shahzaibWaseem27/HSHL_ELE_Shahzaib_Waseem_Project_Work/Floorplanning/floorPlanning_bottomView.png

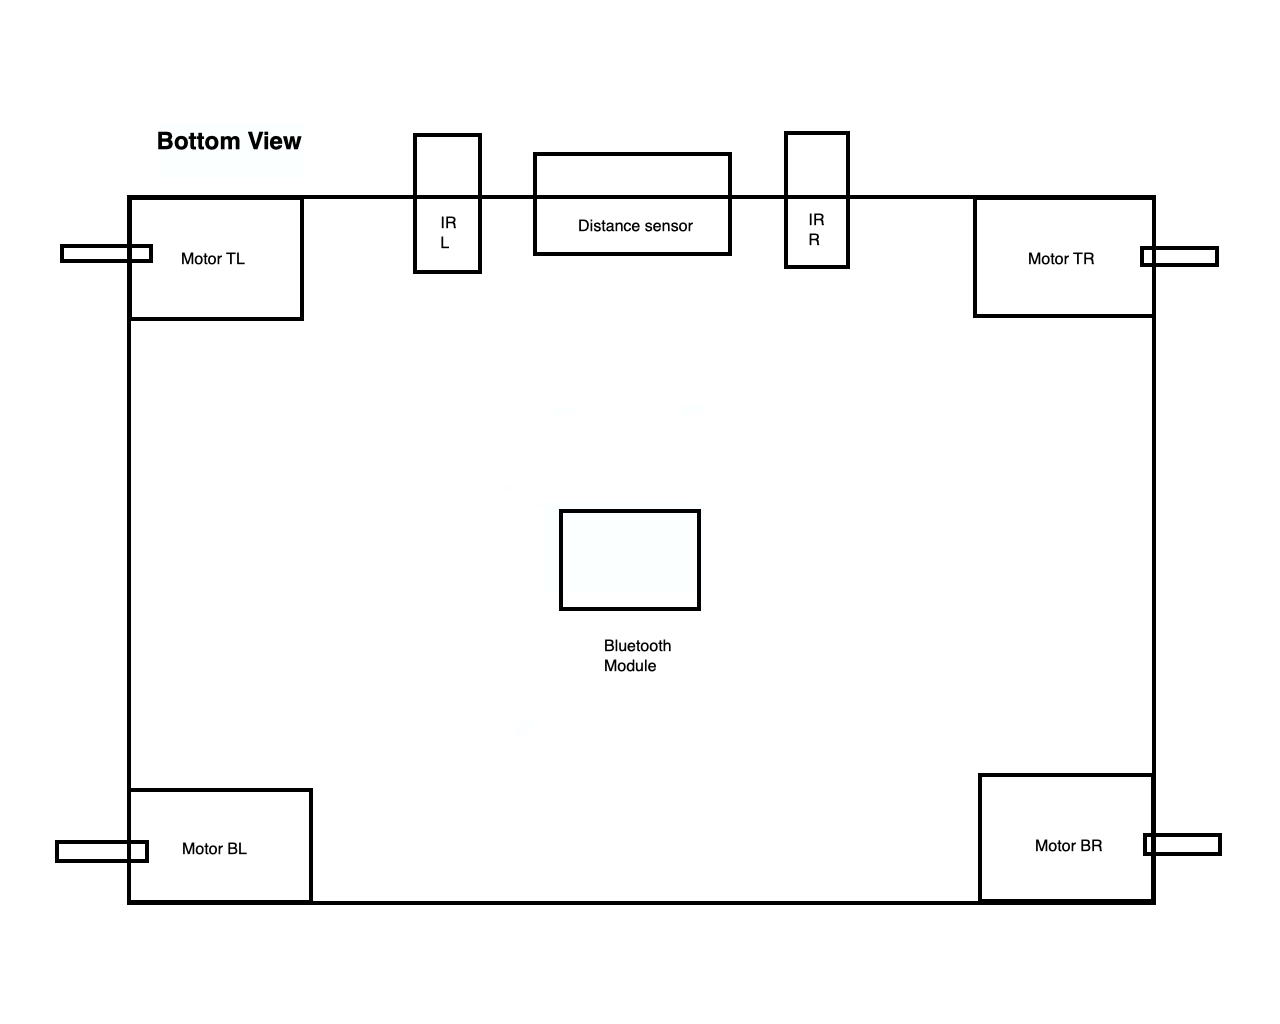
Floorplanning/floorPlanning_bottomView.png
