shahzaibWaseem27/HSHL_ELE_Shahzaib_Waseem_Project_Work/Floorplanning/floorPlanning_topView.png

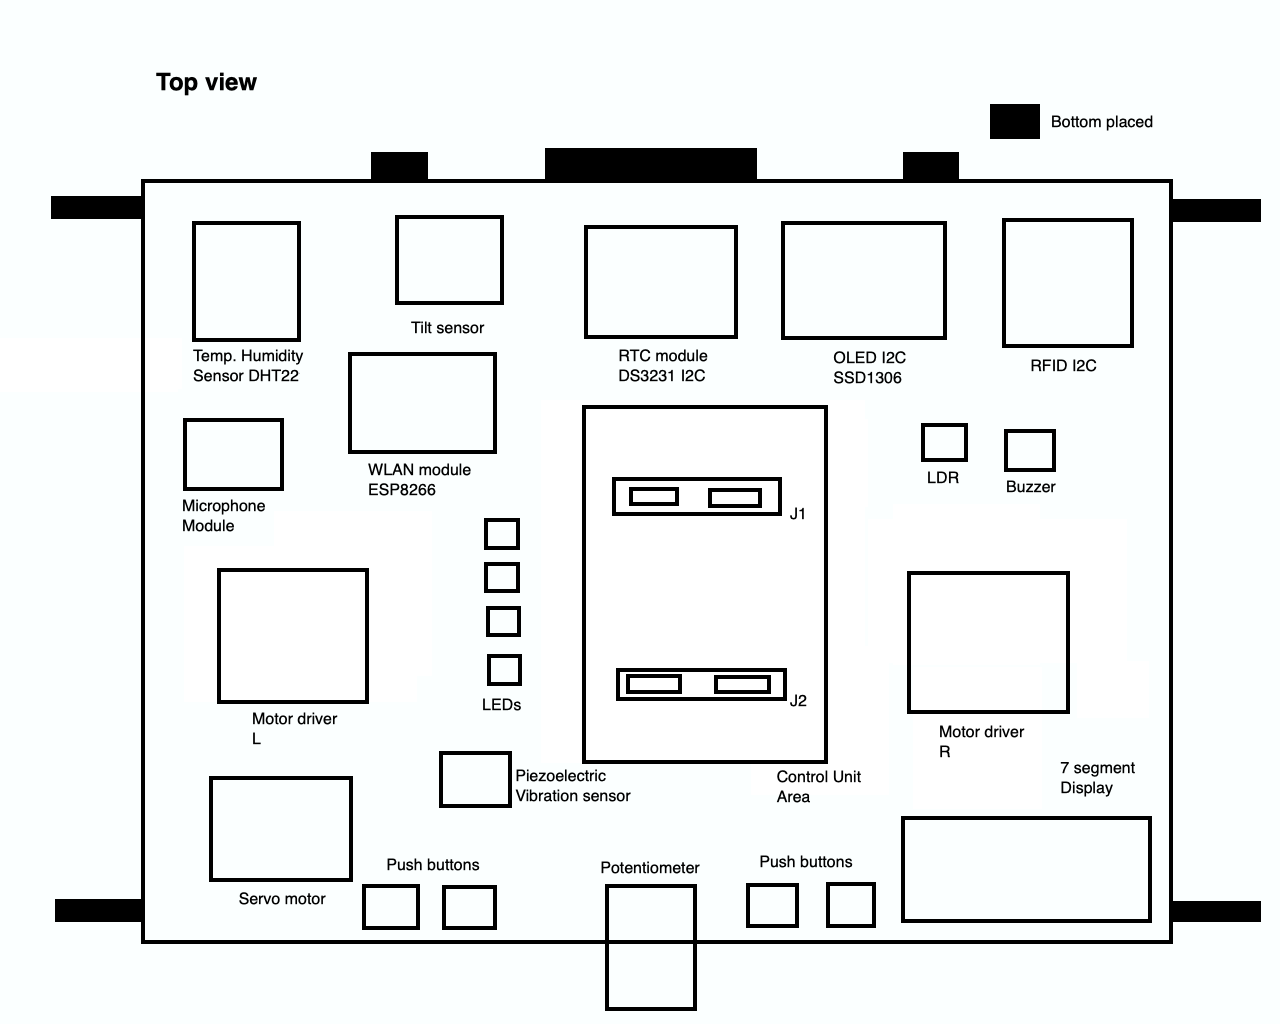
Floorplanning/floorPlanning_topView.png
