shahzaibWaseem27/HSHL_ELE_Shahzaib_Waseem_Project_Work/High density connectors pin mapping.xlsx

Sheet: Export Summary
This document was exported from Numbers. Each table was converted to an Excel worksheet. All other objects on each Numbers sheet were placed on separate worksheets. Please be aware that formula calculations may differ in Excel.
Numbers Sheet Name | Numbers Table Name | Excel Worksheet Name
x_connectors
 | X connectors | x_connectors - X connectors
y_connectors
 | Y connectors | y_connectors - Y connectors

Sheet: x_connectors - X connectors
X connectors
 | Connector code | Peripheral name | Arduino Portenta H7 pin
 | X1 | Keypad R1
 | X2 | Keypad R2
 | X3 | Keypad R3
 | X4 | Keypad R4
 | X5 | Keypad C1
 | X6 | Keypad C2
 | X7 | Keypad C3
 | X8 | Keypad C4
 | X9 | SPI SCK
 | X10 | SPI MISO
 | X11 | SPI MOSI
 | X12 | HC05 BLE RXD
 | X13 | HC05 BLE TXD
 | X14 | ESP8266 WLAN RXD
 | X15 | ESP8266 WLAN TXD
 | X16 | GPIO 1
 | X17 | GPIO 2
 | X18 | GPIO 3
 | X19 | GPIO 4
 | X20
 | X21 | VIN
 | X22 | GND
 | X23
 | X24 | LED 1
 | X25 | LED 2
 | X26 | LED 3
 | X27 | GPIO 5
 | X28 | GPIO 6
 | X29 | GPIO 7
 | X30 | GPIO 8
 | X31 | GND
 | X32 | VIN
 | X33 | LED 4
 | X34 | LED 5
 | X35 | LED 6
 | X36 | LED 7
 | X37 | LED 8
 | X38 | LED 9
 | X39 | LED 10
 | X40 | LED 11
 | X41 | VIN
 | X42 | GND
 | X43
 | X44 | I2C SDA | D11
 | X45
 | X46 | I2C SCL | D12
 | X47 | GND
 | X48 | VIN
 | X49 | LED 12
 | X50 | LED 13
 | X51 | LED 14
 | X52 | LED 15
 | X53 | VSYS
 | X54 | GND
 | X55
 | X56 | Switch 1
 | X57 | Switch 2
 | X58 | Switch 3
 | X59 | Switch 4
 | X60 | Switch 5
 | X61 | Switch 6
 | X62 | Switch 7
 | X63 | Switch 8
 | X64 | VSYS
 | X65 | Switch 9
 | X66 | Switch 10
 | X67 | Switch 11
 | X68 | Switch 12
 | X69 | Switch 13
 | X70 | Switch 14
 | X71 | Switch 15
 | X72 | Switch 16
 | X73 | RESET
 | X74
 | X75 | Push button 1
 | X76 | Push button 2
 | X77 | Push button 3
 | X78 | Push button 4
 | X79
 | X80

Sheet: y_connectors - Y connectors
Y connectors
 | Connector code | Peripheral name | Arduino Portenta H7 pin
 | Y1 | Color sensor S0
 | Y2 | Moisture sensor signal
 | Y3 | Color sensor S1
 | Y4 | Color sensor S2
 | Y5 | GPIO 9
 | Y6 | GPIO 10
 | Y7 | GPIO 11
 | Y8 | GPIO 12
 | Y9 | GPIO 13
 | Y10 | GPIO 14
 | Y11 | GPIO 15
 | Y12 | GPIO 16
 | Y13 | Buzzer
 | Y14 | Color sensor S3
 | Y15 | Seven segment display (segment a)
 | Y16 | Seven segment display (segment b)
 | Y17 | Seven segment display (segment c)
 | Y18 | Seven segment display (segment d)
 | Y19 | Seven segment display (segment e)
 | Y20 | Seven segment display (segment f)
 | Y21 | Seven segment display (segment g)
 | Y22 | Color sensor Out
 | Y23 | VCC / +3V3
 | Y24 | GND
 | Y25 | Seven segment display (anode 1)
 | Y26 | Seven segment display (anode 2)
 | Y27 | Seven segment display (anode 3)
 | Y28 | Seven segment display (anode 4)
 | Y29 | Seven segment display (anode 5)
 | Y30 | Seven segment display (anode 6)
 | Y31 | Seven segment display (anode 7)
 | Y32 | Seven segment display (anode 8)
 | Y33 | GND
 | Y34 | VCC
 | Y35
 | Y36 | Motor driver IN2 | D7
 | Y37
 | Y38 | Left IR sensor pin | D9
 | Y39
 | Y40 | Right IR sensor pin | D10
 | Y41
 | Y42 | Motor driver IN4 | D8
 | Y43 | VCC / +3V3
 | Y44 | GND
 | Y45
 | Y46 | PIR motion sensor
 | Y47
 | Y48 | LoRa G0
 | Y49 | LoRa CS
 | Y50 | LoRa RST
 | Y51 | RFID CS
 | Y52 | RFID RST
 | Y53
 | Y54 | DHT22 temperature sensor pin
 | Y55
 | Y56
 | Y57 | GND
 | Y58
 | Y59 | Distance sensor trigger | D6
 | Y60 | Motor driver IN1 | D1
 | Y61 | Left servo signal | D5
 | Y62 | Motor driver EnA | D0
 | Y63 | Motor driver IN3 | D4
 | Y64
 | Y65 | Motor driver EnB | D3
 | Y66
 | Y67 | Right servo signal | D2
 | Y68
 | Y69 | VCC / +3V3
 | Y70 | GND
 | Y71 | ADC VREF +
 | Y72 | ADC VREF -
 | Y73 | LDR | A0
 | Y74 | Piezo vibration sensor | A4
 | Y75 | Potentiometer 2 | A1
 | Y76 | Distance sensor echo | D20
 | Y77 | LED 16 | A2
 | Y78 | Push button 5 | D21
 | Y79 | Microphone analog pin | A3
 | Y80
