shahzaibWaseem27/HSHL_ELE_Shahzaib_Waseem_Project_Work/Arduino Portenta/ABX00042-full-pinout.pdf

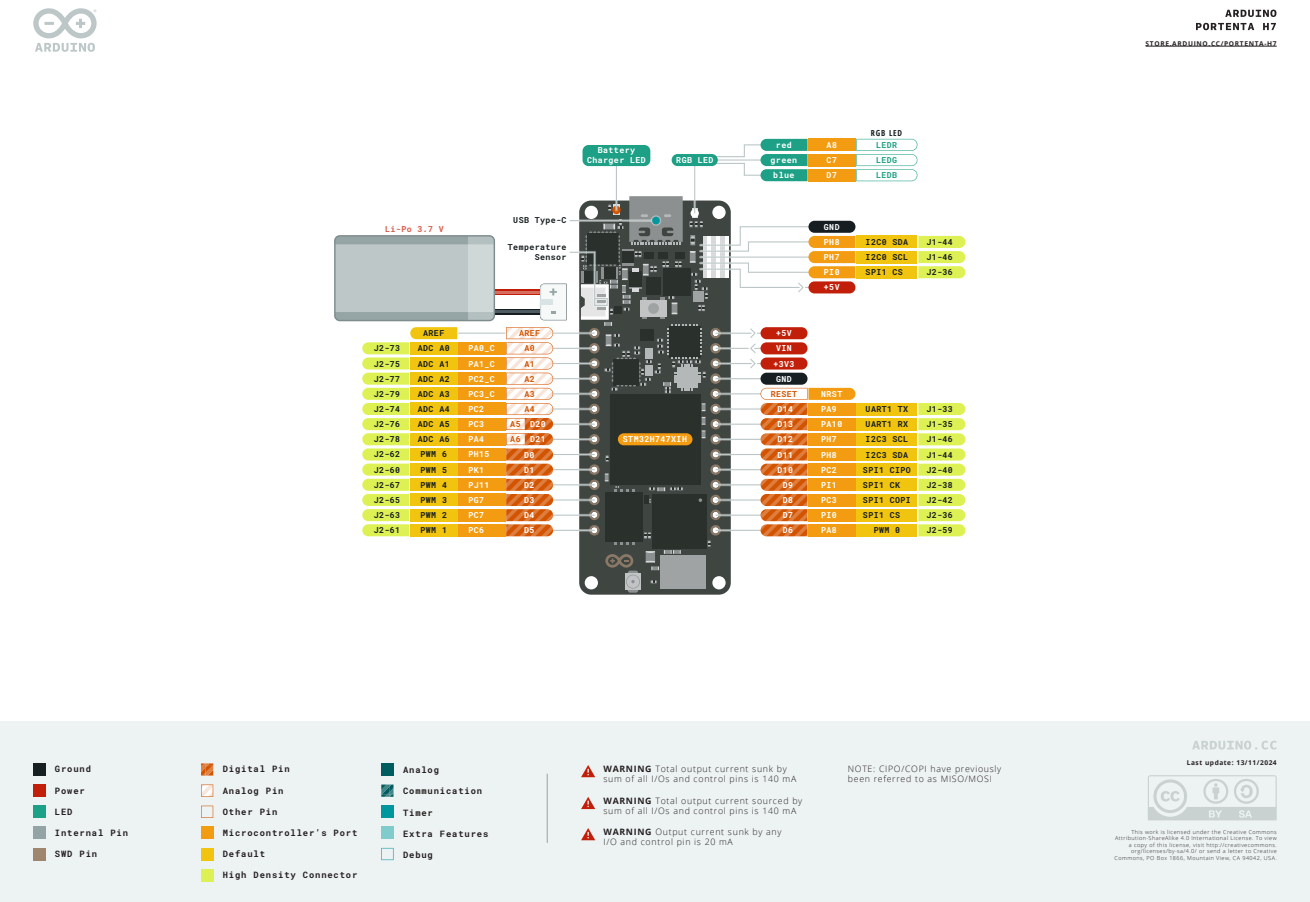
[picture p25: page 1]

STORE.ARDUINO.CC/PORTENTA-H7

WARNING Total output current sunk by
sum of all I/Os and control pins is 140 mA
WARNING Total output current sourced by
WARNING Output current sunk by any
I/O and control pin is 20 mA

NOTE: CIPO/COPI have previously
been referred to as MISO/MOSI

This work is licensed under the Creative Commons
Attribution-ShareAlike 4.0 International License. To view
a copy of this license, visit http://creativecommons.
org/licenses/by-sa/4.0/ or send a letter to Creative
Commons, PO Box 1866, Mountain View, CA 94042, USA.

J1 | J2

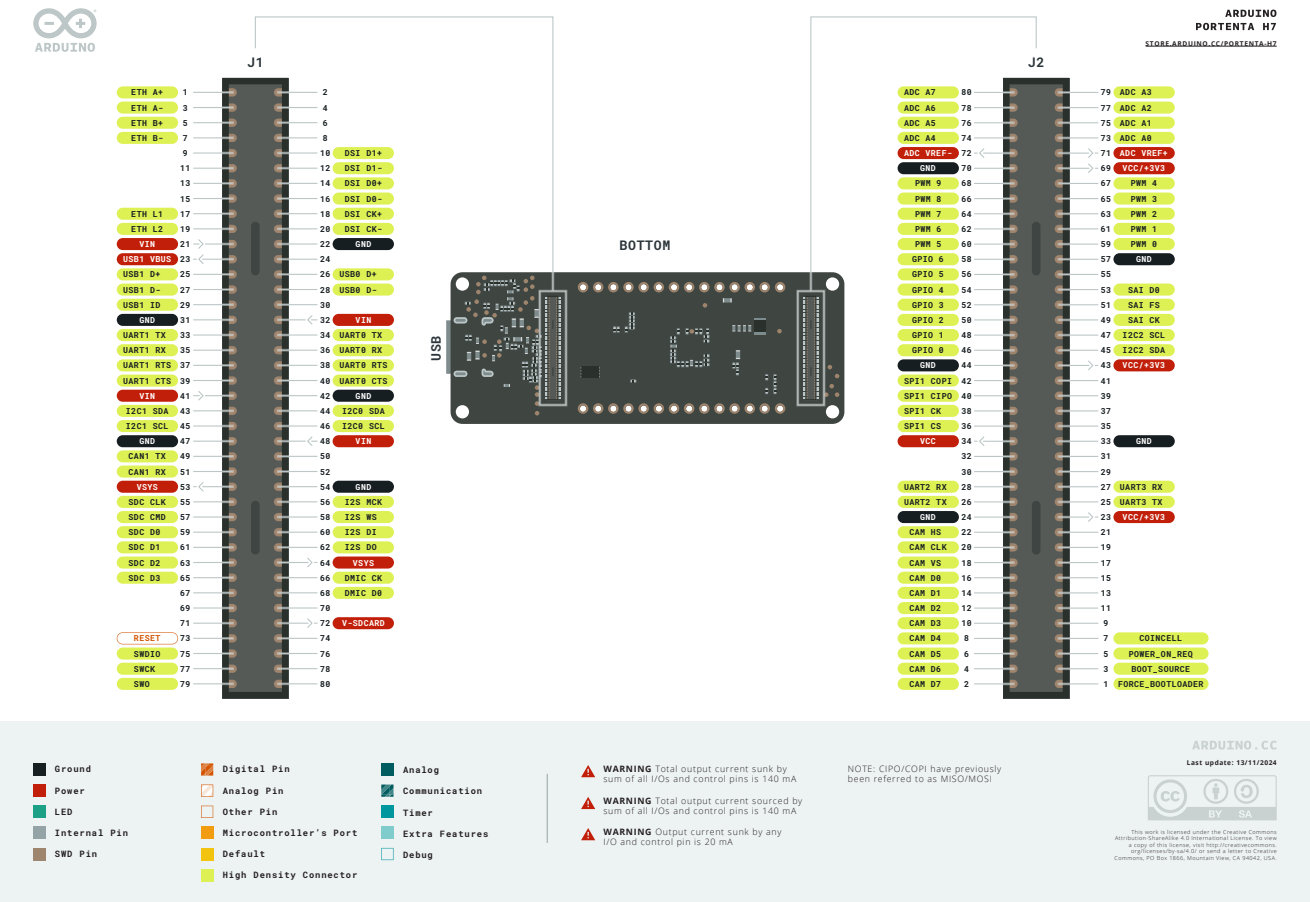
[picture p26: page 2]
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

NOTE: CIPO/COPI have previously
been referred to as MISO/MOSI

J1

# J1_odd - Analog/Timer

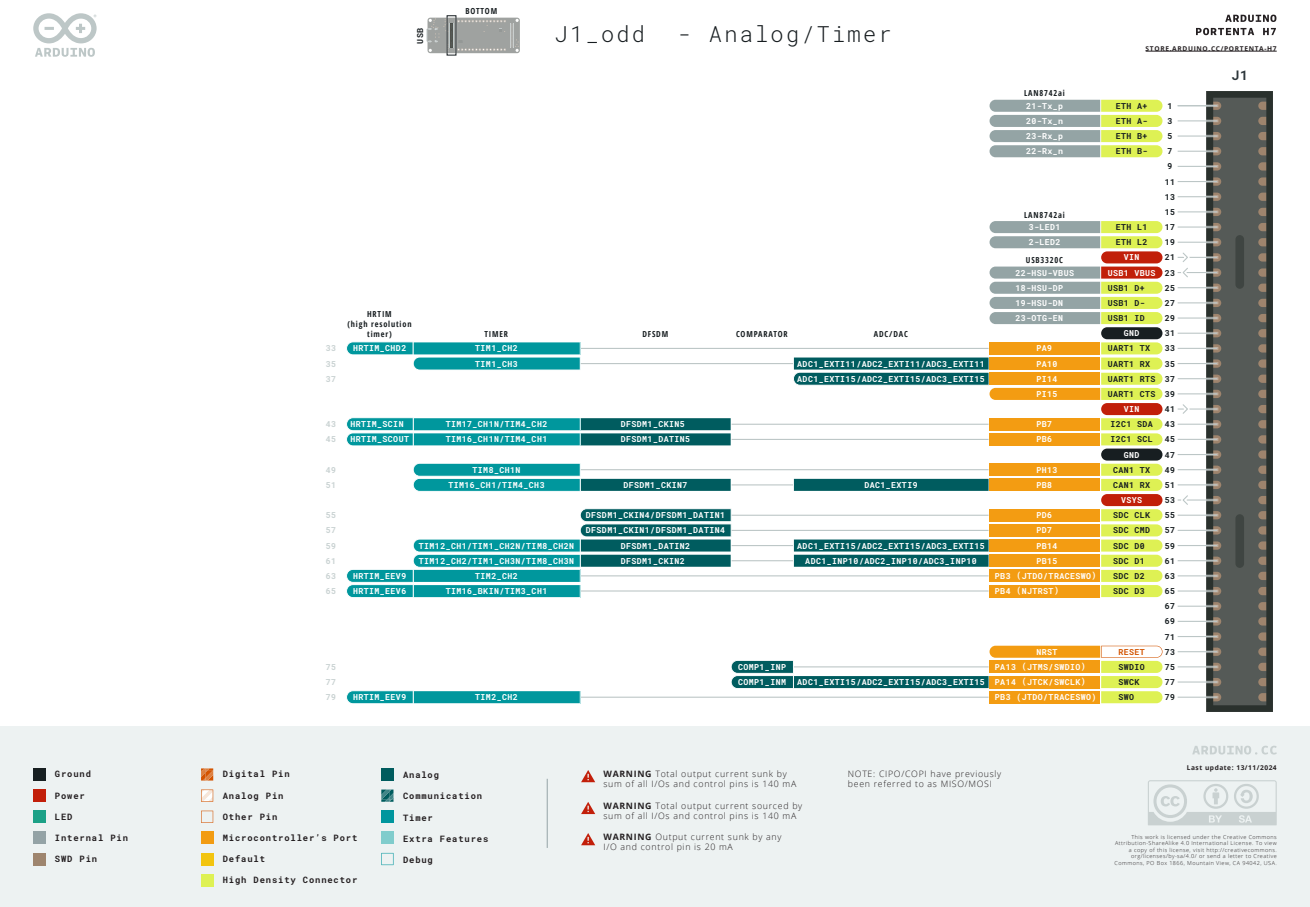
[picture p27: page 3]
Analog; Communication; Timer; Ground; Power; LED; Digital Pin; Analog Pin; Other Pin; Last update: 13/11/2024; BOTTOM; USB; ADC1_EXTI11/ADC2_EXTI11/ADC3_EXTI11 ADC1_EXTI15/ADC2_EXTI15/ADC3_EXTI15; DAC1_EXTI9; ADC1_EXTI15/ADC2_EXTI15/ADC3_EXTI15 ADC1_INP10/ADC2_INP10/ADC3_INP10; ADC1_EXTI15/ADC2_EXTI15/ADC3_EXTI15; DFSDM1_CKIN7; DFSDM1_CKIN4/DFSDM1_DATIN1 DFSDM1_CKIN1/DFSDM1_DATIN4 DFSDM1_DATIN2 DFSDM1_CKIN2; COMP1_INP COMP1_INM; DFSDM; COMPARATOR; ADC/DAC; ETH A+; ETH A-; ETH B+; ETH B-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

TIM17_CH1N/TIM4_CH2 | DFSDM1_CKIN5
TIM16_CH1N/TIM4_CH1 | DFSDM1_DATIN5

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

NOTE: CIPO/COPI have previously
been referred to as MISO/MOSI

J1

# J1_odd - Communication

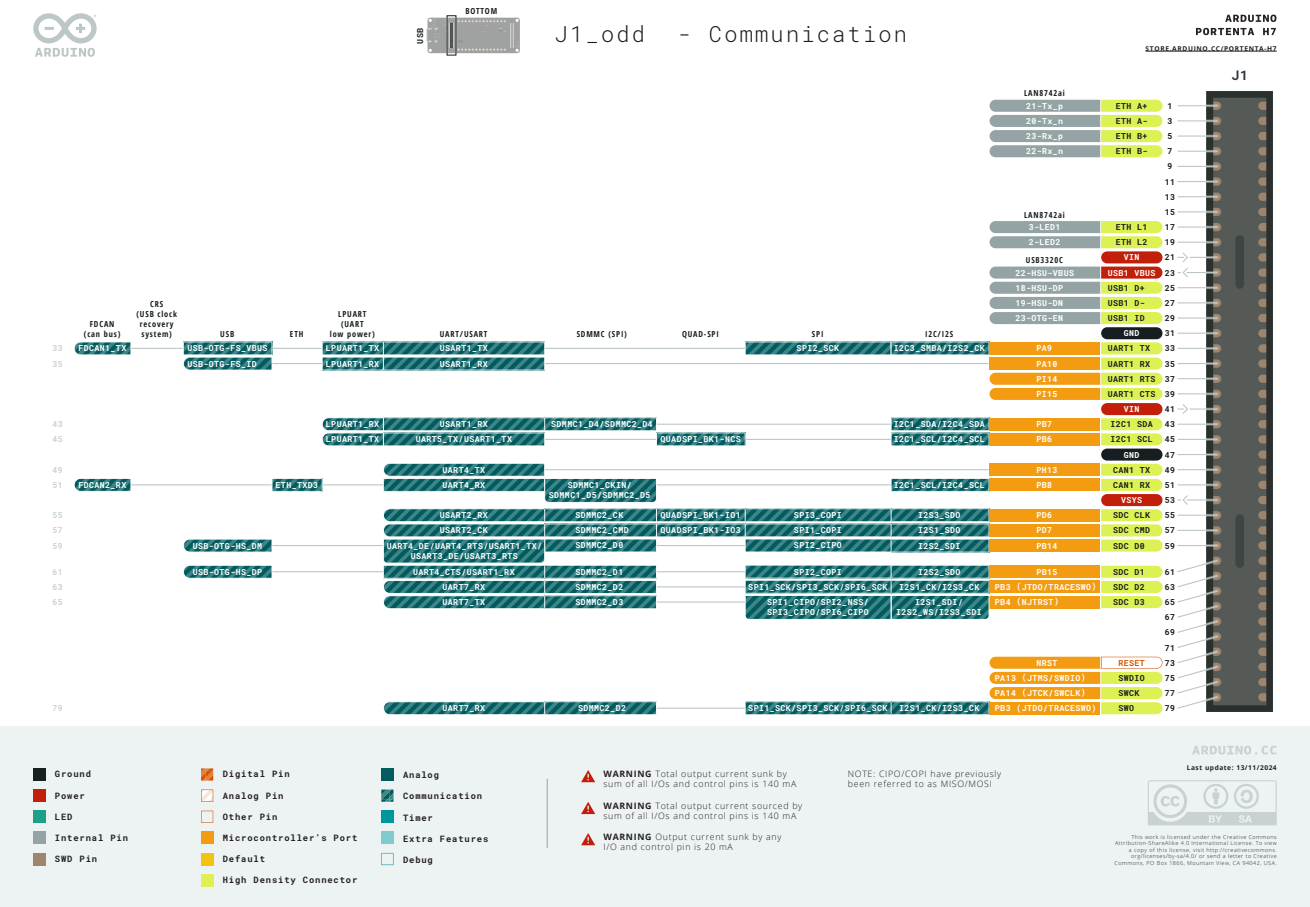
[picture p28: page 4]
Analog; Communication; Timer; Ground; Power; LED; Digital Pin; Analog Pin; Other Pin; Last update: 13/11/2024; I2C3_SMBA/I2S2_CK; I2C1_SDA/I2C4_SDA I2C1_SCL/I2C4_SCL; I2C1_SCL/I2C4_SCL; I2S2_SDO I2S1_CK/I2S3_CK; SPI2_SCK; SPI2_COPI SPI1_SCK/SPI3_SCK/SPI6_SCK; SPI1_SCK/SPI3_SCK/SPI6_SCK; USB-OTG-FS_VBUS USB-OTG-FS_ID; USB-OTG-HS_DM; USB-OTG-HS_DP; USART1_TX USART1_RX; USART1_RX UART5_TX/USART1_TX; UART4_TX UART4_RX; USART2_RX USART2_CK; UART4_CTS/USART1_RX UART7_RX UART7_TX; UART7_RX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

SDMMC2_CK | QUADSPI_BK1-IO1 | SPI3_COPI | I2S3_SDO
SDMMC2_CMD | QUADSPI_BK1-IO3 | SPI1_COPI | I2S1_SDO
SDMMC2_D0 | | SPI2_CIPO | I2S2_SDI

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

NOTE: CIPO/COPI have previously
been referred to as MISO/MOSI

J1

# J1_odd - Extra/Debug

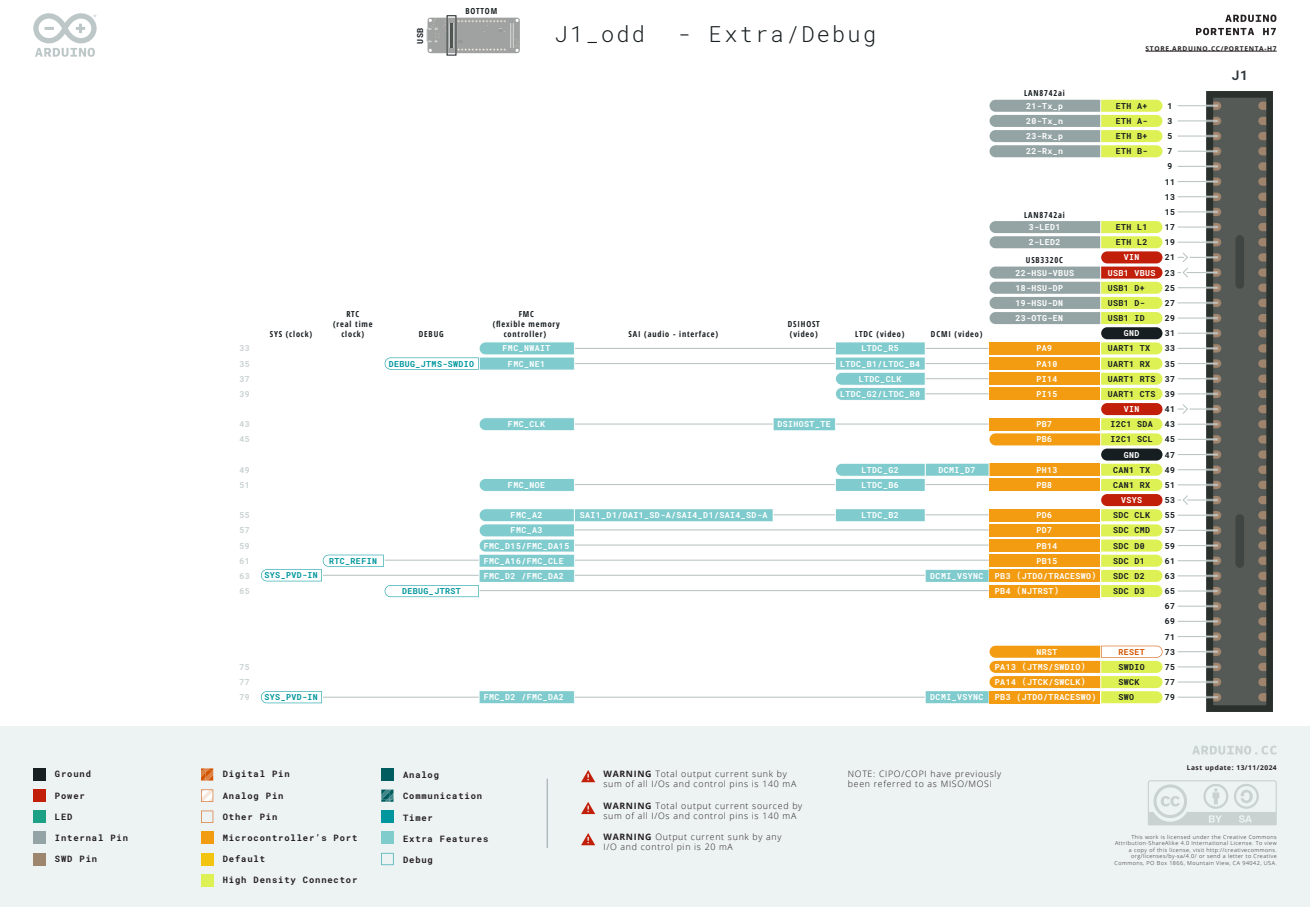
[picture p29: page 5]
Analog; Communication; Timer; Ground; Power; LED; Digital Pin; Analog Pin; Other Pin; Last update: 13/11/2024; ETH A+; ETH A-; ETH B+; ETH B-; ETH L1; ETH L2; VIN; USB1 VBUS 23; USB1 D+; USB1 D-; USB1 ID; GND; UART1 TX; UART1 RX; UART1 RTS 37 UART1 CTS 39; I2C1 SDA 43 I2C1 SCL 45; CAN1 TX; CAN1 RX; VSYS; SDC CLK; SDC CMD; SDC D0; SDC D1; SDC D2; SDC D3; RESET; SWDIO; SWCK; 75 77 79 SWO; 3-LED1 2-LED2; LAN8742ai; 19-HSU-DN 23-OTG-EN; 18-HSU-DP; 22-HSU-VBUS; USB3320C; DCMI_D7; DCMI_VSYNC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

NOTE: CIPO/COPI have previously
been referred to as MISO/MOSI

J1

# J1_even - Analog/Timer

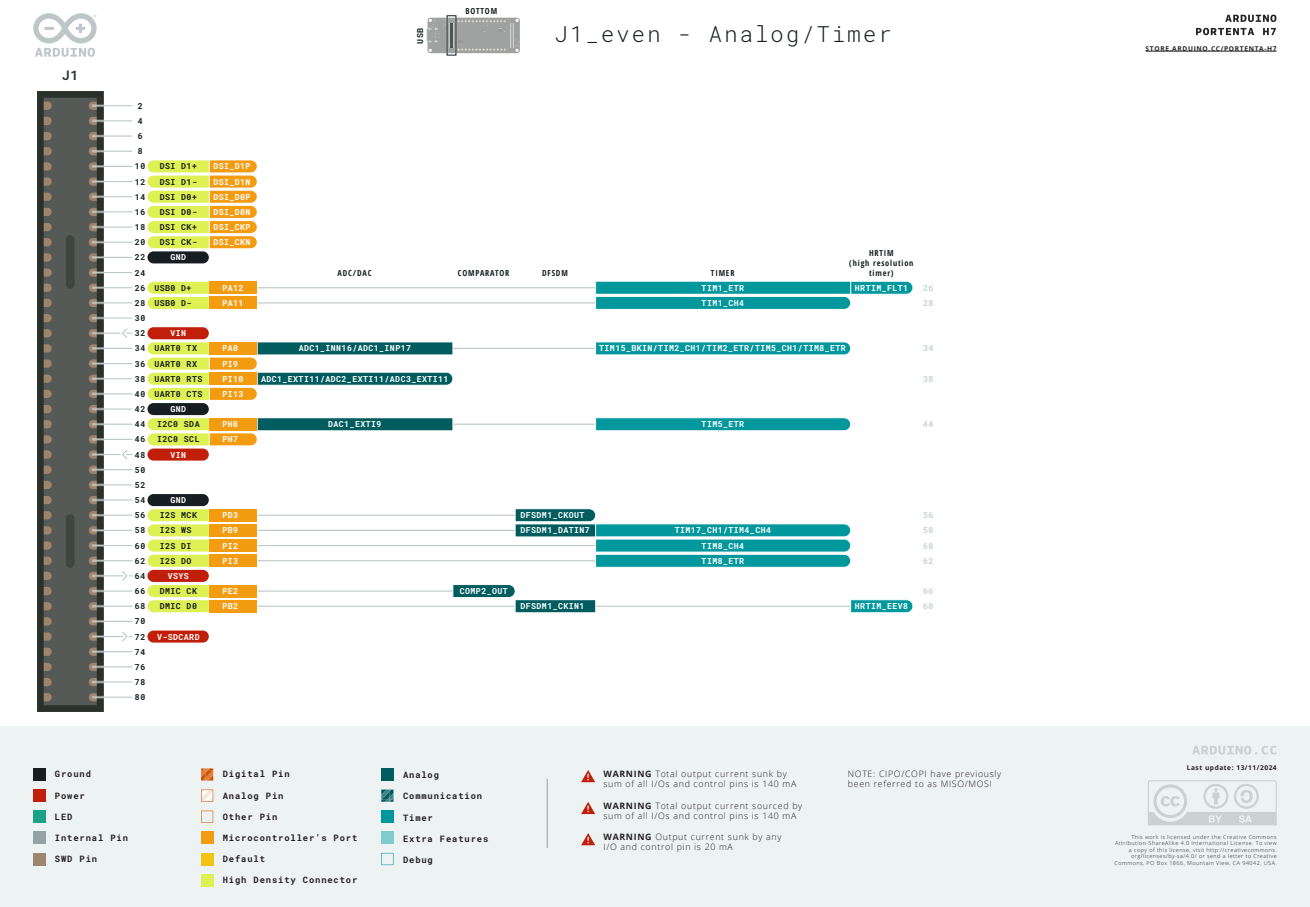
[picture p30: page 6]
Analog; Communication; Timer; Ground; Power; LED; Digital Pin; Analog Pin; Other Pin; Last update: 13/11/2024; ADC1_INN16/ADC1_INP17; ADC1_EXTI11/ADC2_EXTI11/ADC3_EXTI11; DAC1_EXTI9; DFSDM1_CKOUT DFSDM1_DATIN7; DFSDM1_CKIN1; COMP2_OUT; ADC/DAC; COMPARATOR; DFSDM; DSI D1+; DSI_D1P; DSI_D1N; DSI_D0N DSI_CKP DSI_CKN; DSI_D0P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

NOTE: CIPO/COPI have previously
been referred to as MISO/MOSI

J1

# J1_even - Communication

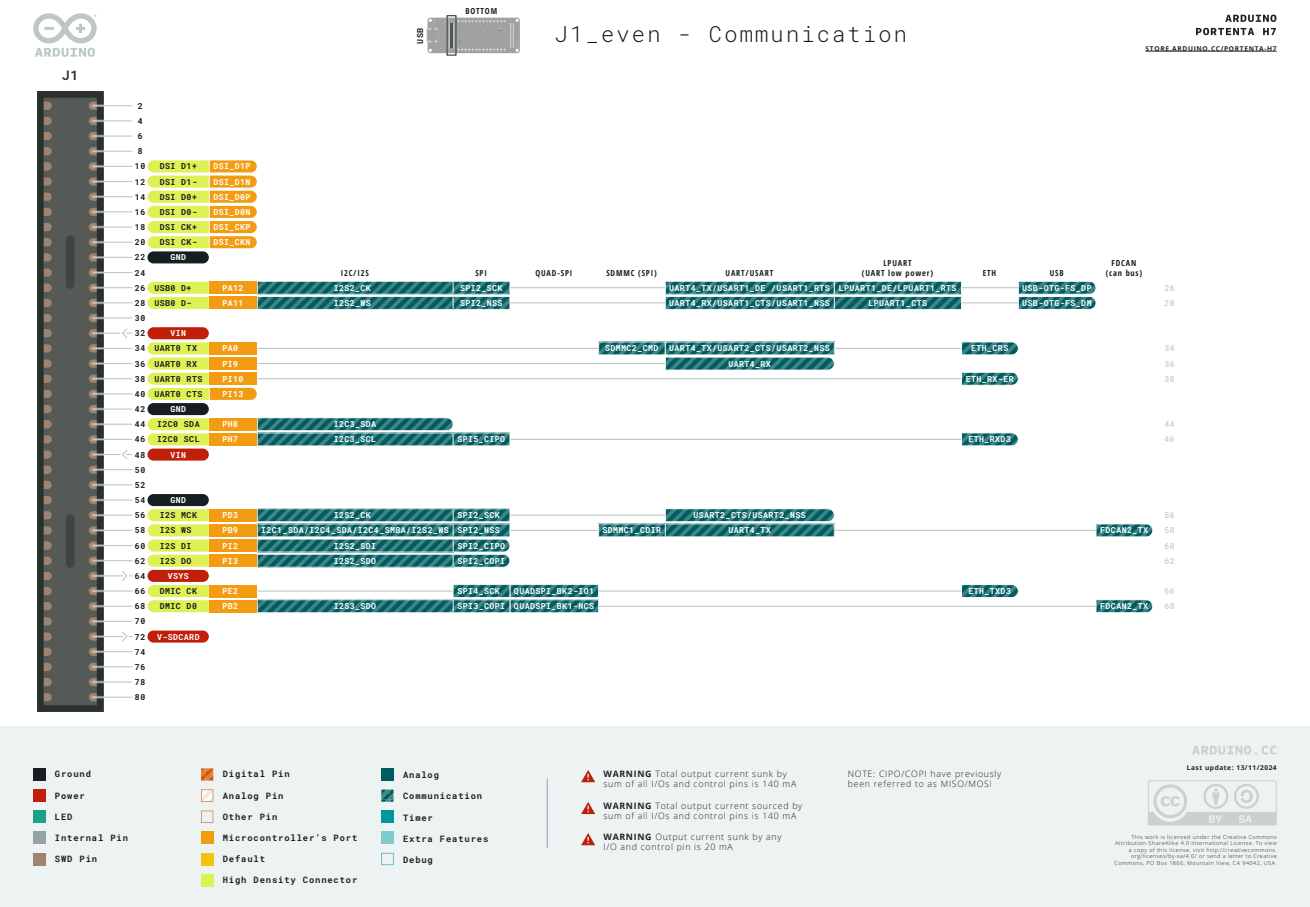
[picture p31: page 7]
Analog; Communication; Timer; Ground; Power; LED; Digital Pin; Analog Pin; Other Pin; Last update: 13/11/2024; SPI2_SCK; FDCAN2_TX; USB-OTG-FS_DP USB-OTG-FS_DM; UART4_TX/USART1_DE /USART1_RTS; LPUART1_DE/LPUART1_RTS; UART4_RX/USART1_CTS/USART1_NSS; LPUART1_CTS; UART4_TX/USART2_CTS/USART2_NSS UART4_RX; USART2_CTS/USART2_NSS UART4_TX; SDMMC2_CMD; ETH_CRS; ETH_RX-ER; ETH_RXD3; ETH_TXD3; SDMMC1_CDIR; SPI2_NSS; SPI2_SCK SPI2_NSS SPI2_CIPO SPI2_COPI; SPI5_CIPO; I2C3_SDA I2C3_SCL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

SPI4_SCK | QUADSPI_BK2-IO1

I2S3_SDO | SPI3_COPI | QUADSPI_BK1-NCS

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

NOTE: CIPO/COPI have previously
been referred to as MISO/MOSI

J1

# J1_even - Extra/Debug

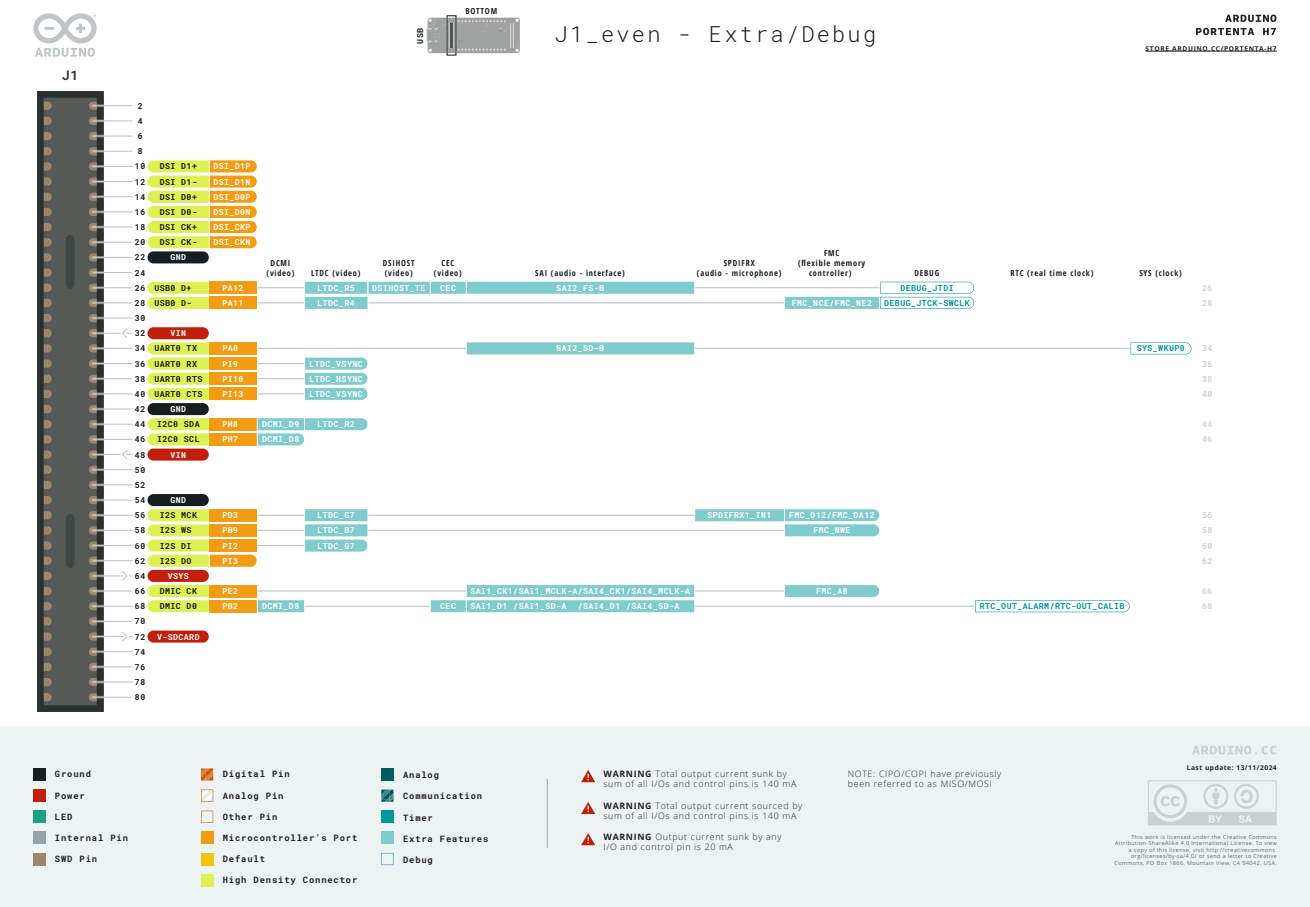
[picture p32: page 8]
Analog; Communication; Timer; Ground; Power; LED; Digital Pin; Analog Pin; Other Pin; Last update: 13/11/2024; DSI D1+; DSI_D1P; DSI_D1N; DSI_D0N DSI_CKP DSI_CKN; DSI_D0P; 12 DSI D1- 14 DSI D0+ 16 DSI D0- 18 DSI CK+ 20 DSI CK- 22 GND 24 26 USB0 D+ 28 USB0 D- 30 32 VIN 34 UART0 TX 36 UART0 RX 38 UART0 RTS 40 UART0 CTS 42 GND 44 I2C0 SDA 46 I2C0 SCL 48 VIN 50 52 54 GND 56 I2S MCK 58 I2S WS 60 I2S DI 62 I2S DO 64 VSYS 66 68; DMIC CK; DMIC D0; V-SDCARD; DCMI_D9 DCMI_D8; DCMI_D8; LTDC_VSYNC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

LTDC_R5 | DSIHOST_TE | CEC | SAI2_FS-B
LTDC_R4 | | FMC_NCE/FMC_NE2

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

NOTE: CIPO/COPI have previously
been referred to as MISO/MOSI

J2

# J2_even - Analog/Timer

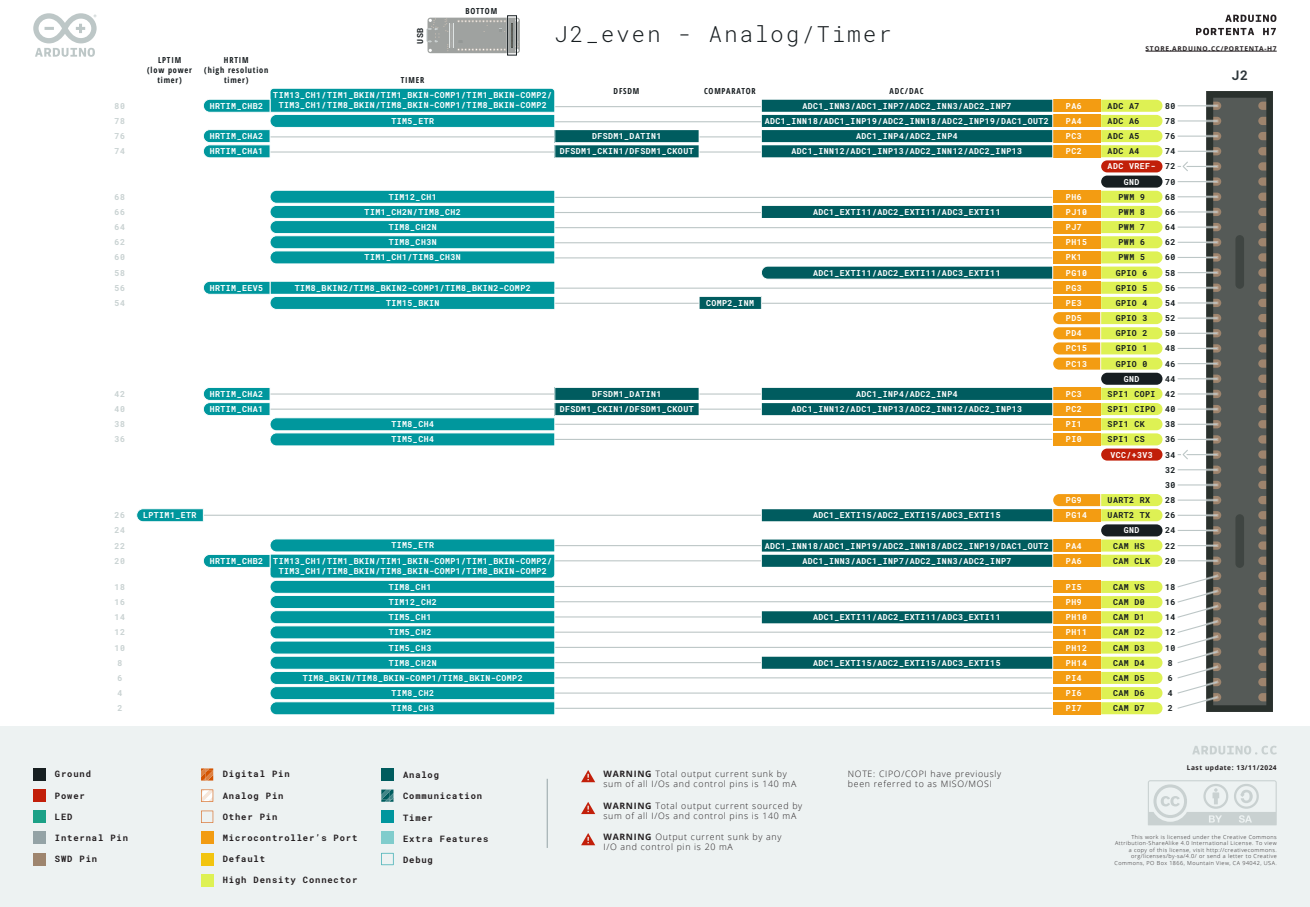
[picture p33: page 9]
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

NOTE: CIPO/COPI have previously
been referred to as MISO/MOSI

J2

# J2_even - Communication

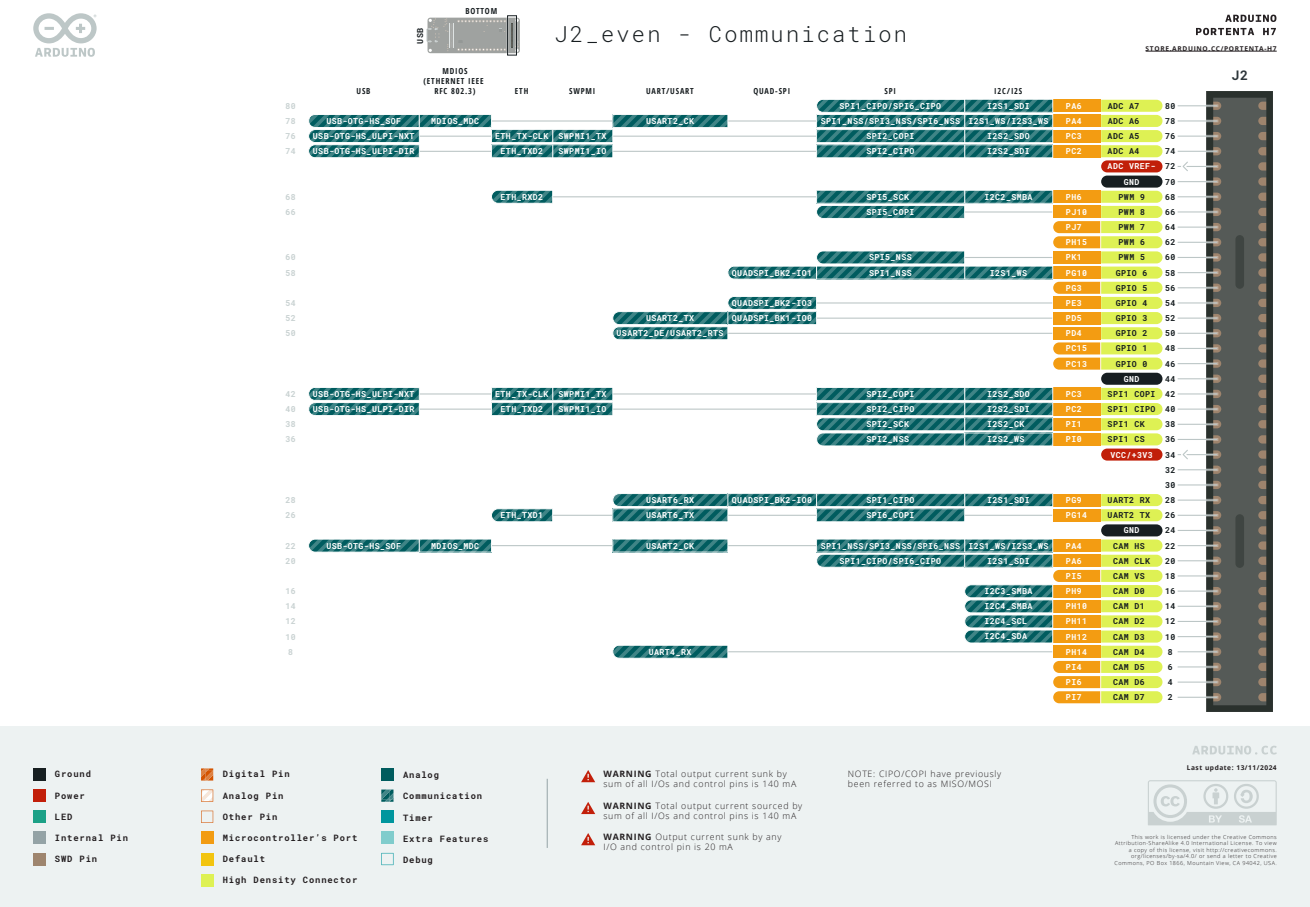
[picture p34: page 10]

QUADSPI_BK2-IO0 | SPI1_CIPO | I2S1_SDI

USART6_TX | | SPI6_COPI

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

NOTE: CIPO/COPI have previously
been referred to as MISO/MOSI

J2

# J2_even - Extra/Debug

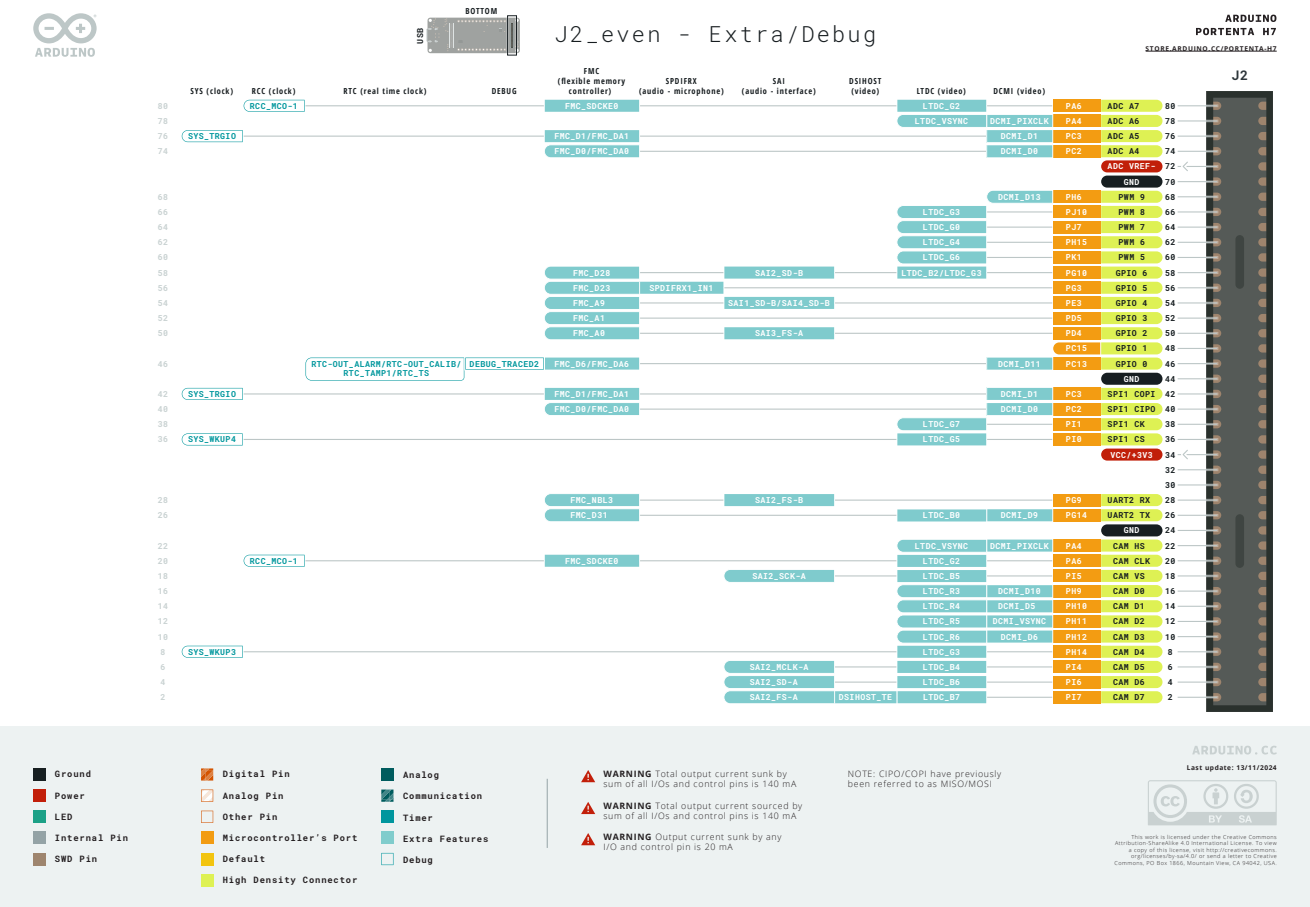
[picture p35: page 11]
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

NOTE: CIPO/COPI have previously
been referred to as MISO/MOSI

J2

# J2_odd - Analog/Timer

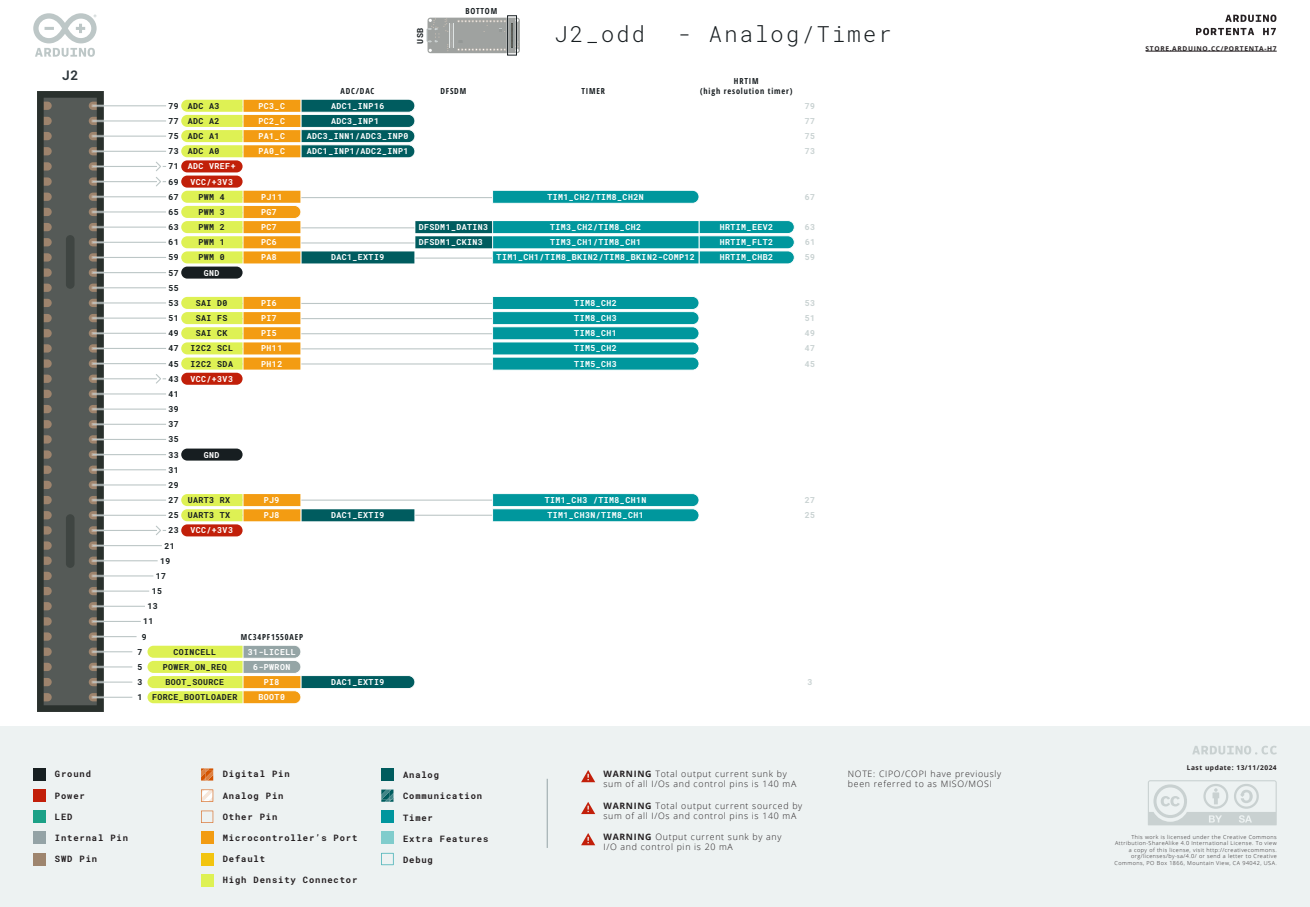
[picture p36: page 12]
Analog; Communication; Timer; Ground; Power; LED; Digital Pin; Analog Pin; Other Pin; Last update: 13/11/2024; MC34PF1550AEP; DAC1_EXTI9; ADC1_INP1/ADC2_INP1; ADC3_INN1/ADC3_INP0; ADC3_INP1; ADC1_INP16; HRTIM_CHB2; HRTIM_FLT2; HRTIM_EEV2; TIM1_CH3N/TIM8_CH1; TIM1_CH3 /TIM8_CH1N; TIM5_CH3; TIM5_CH2; TIM8_CH1; TIM8_CH3; TIM8_CH2; TIM3_CH1/TIM8_CH1; TIM3_CH2/TIM8_CH2; TIM1_CH2/TIM8_CH2N; TIM1_CH1/TIM8_BKIN2/TIM8_BKIN2-COMP12; DFSDM1_CKIN3; DFSDM1_DATIN3; ADC/DAC; DFSDM; TIMER; HRTIM; BOOT0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

(high resolution timer)

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

NOTE: CIPO/COPI have previously
been referred to as MISO/MOSI

J2

# J2_odd - Communication

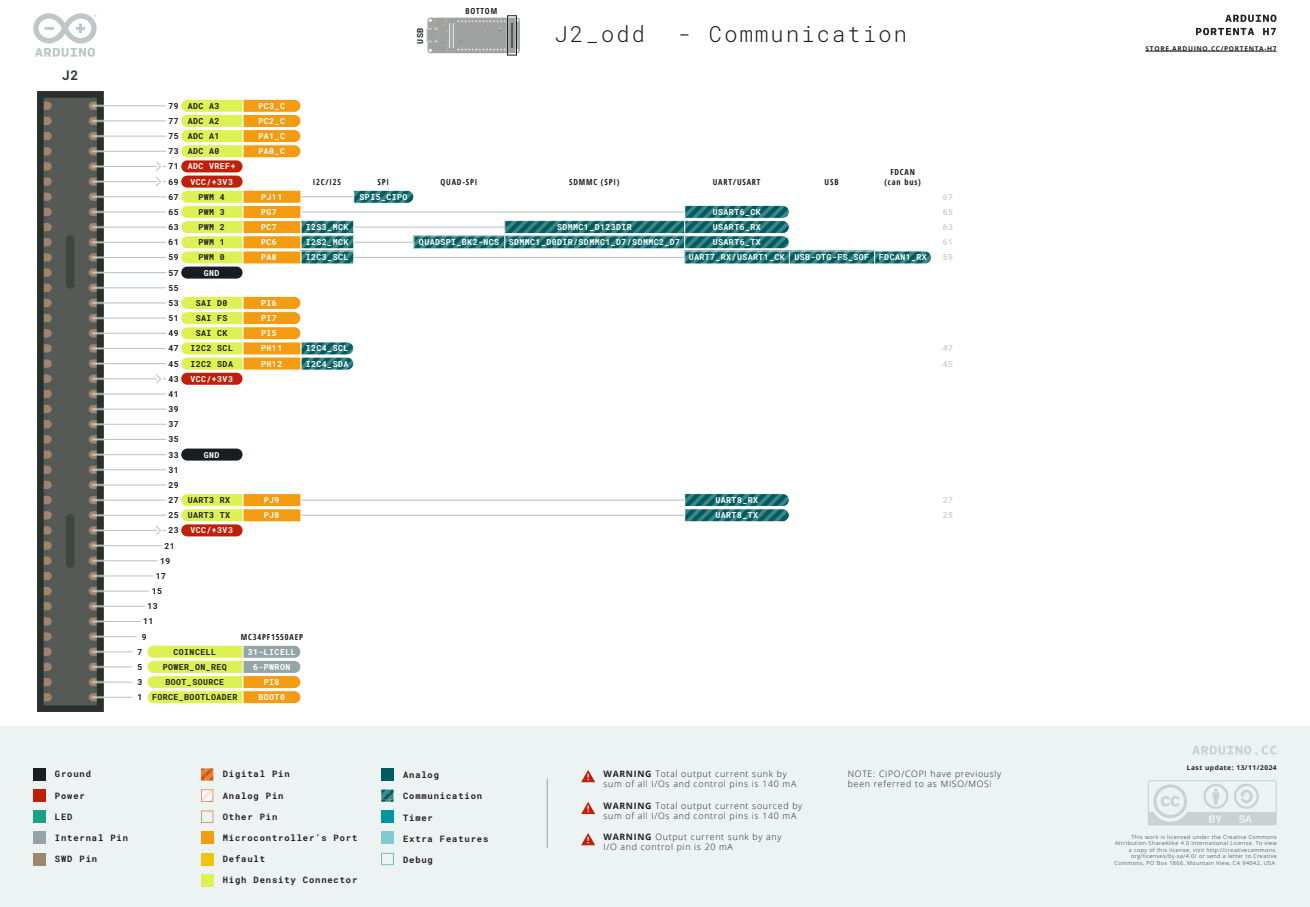
[picture p37: page 13]
Analog; Communication; Timer; Ground; Power; LED; Digital Pin; Analog Pin; Other Pin; Last update: 13/11/2024; FORCE_BOOTLOADER; BOOT_SOURCE; POWER_ON_REQ; 7 COINCELL; 23 VCC/+3V3; 25 UART3 TX; 27 UART3 RX; 33 GND; 43 VCC/+3V3; 45 I2C2 SDA; 47 I2C2 SCL; 49 SAI CK; 51 SAI FS; 53 SAI D0; 57 GND; 59 PWM 0; 61 PWM 1; 63 PWM 2; 65 PWM 3; 67 PWM 4; 69 VCC/+3V3; 71 ADC VREF+; 73 ADC A0; 75 ADC A1; 77 ADC A2; ADC A3; I2C4_SDA; I2C4_SCL; I2C3_SCL; I2S2_MCK; I2S3_MCK; SPI5_CIPO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

NOTE: CIPO/COPI have previously
been referred to as MISO/MOSI

J2

# J2_odd - Extra/Debug

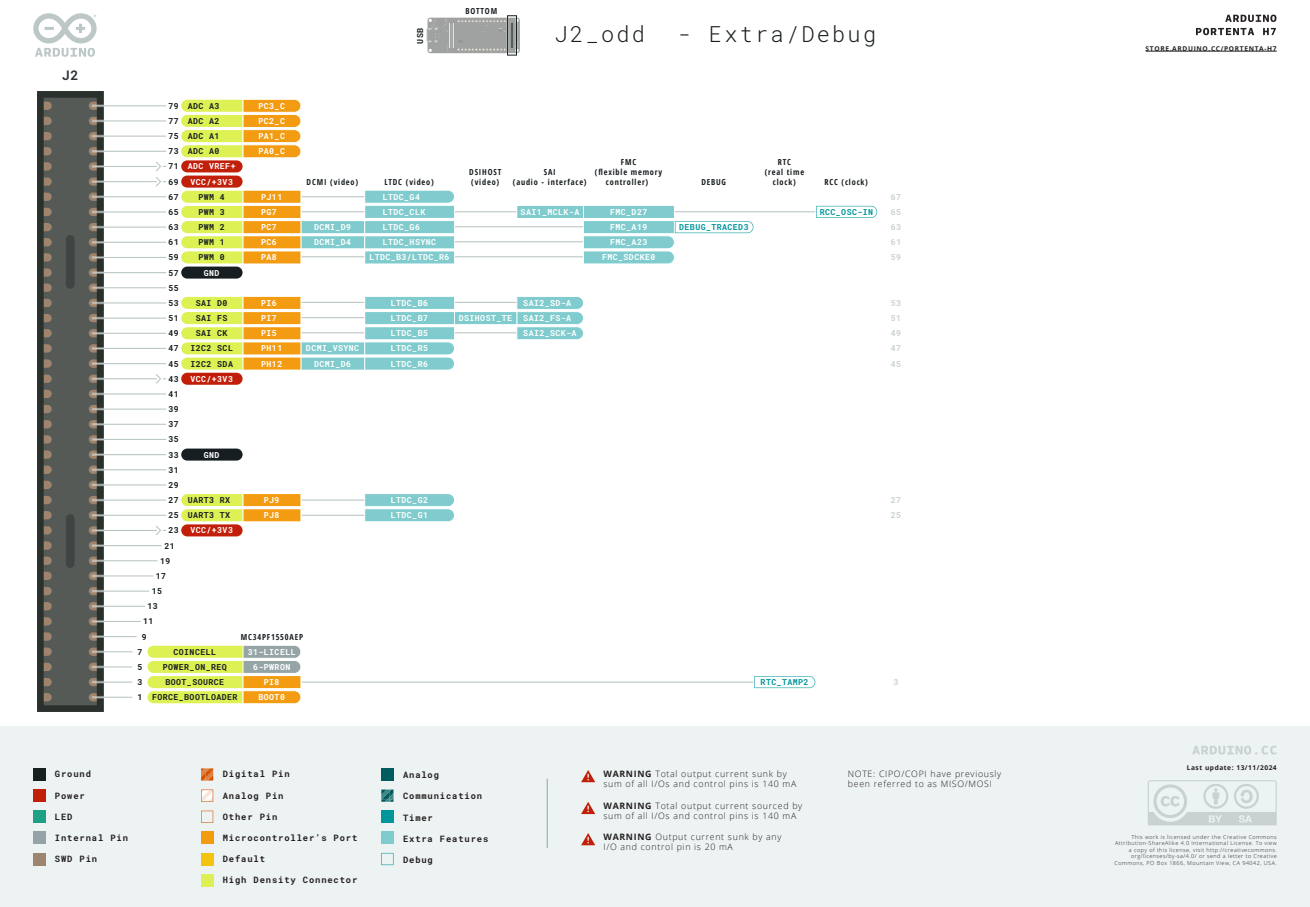
[picture p38: page 14]
Analog; Communication; Timer; Ground; Power; LED; Digital Pin; Analog Pin; Other Pin; Last update: 13/11/2024; FORCE_BOOTLOADER; BOOT_SOURCE; POWER_ON_REQ; 7 COINCELL; 23 VCC/+3V3; 25 UART3 TX; 27 UART3 RX; 33 GND; 43 VCC/+3V3; 45 I2C2 SDA; 47 I2C2 SCL; 49 SAI CK; 51 SAI FS; 53 SAI D0; 57 GND; 59 PWM 0; 61 PWM 1; 63 PWM 2; 65 PWM 3; 67 PWM 4; 69 VCC/+3V3; 71 ADC VREF+; 73 ADC A0; 75 ADC A1; 77 ADC A2; ADC A3; LTDC_G1; LTDC_G2; LTDC_R6; LTDC_R5; LTDC_B5; LTDC_B7; LTDC_B6; LTDC_CLK; LTDC_G4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

PC7 | DCMI_D9 | LTDC_G6 | FMC_A19
PC6 | DCMI_D4 | LTDC_HSYNC

PH11 | DCMI_VSYNC
PH12 | DCMI_D6

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

NOTE: CIPO/COPI have previously
been referred to as MISO/MOSI

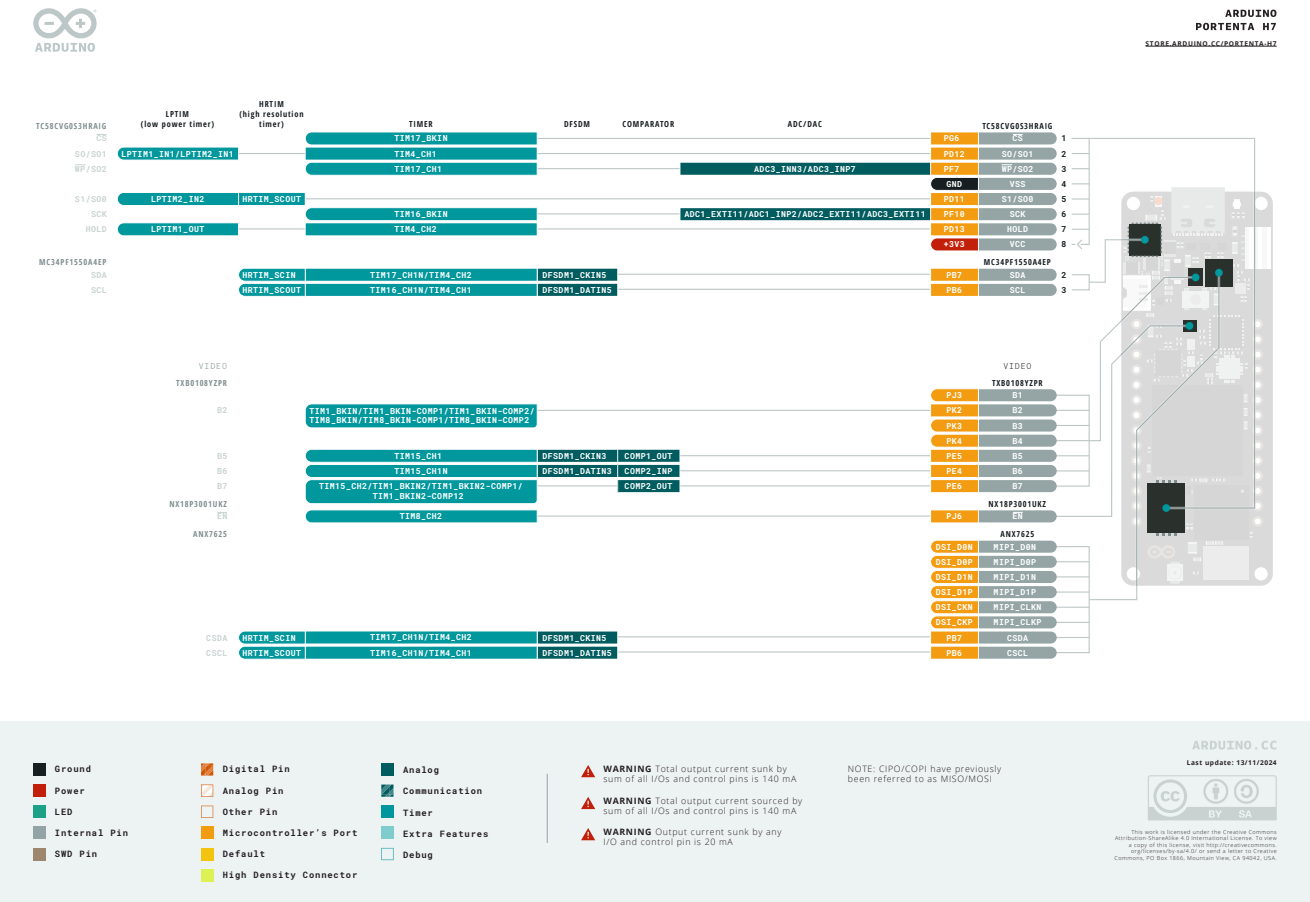
[picture p39: page 15]
Analog; Communication; Timer; Ground; Power; LED; Digital Pin; Analog Pin; Other Pin; Last update: 13/11/2024; GND; VSS; SCK; HOLD; VCC; SDA; SCL; MIPI_D0N MIPI_D0P MIPI_D1N MIPI_D1P MIPI_CLKN MIPI_CLKP CSDA CSCL; DSI_D0N DSI_D0P DSI_D1N DSI_D1P DSI_CKN DSI_CKP PB7 PB6; TC58CVG0S3HRAIG; VIDEO; TXB0108YZPR; NX18P3001UKZ; ANX7625; ADC3_INN3/ADC3_INP7; ADC1_EXTI11/ADC1_INP2/ADC2_EXTI11/ADC3_EXTI11; DFSDM1_CKIN5 DFSDM1_DATIN5; COMP2_OUT; TIM17_BKIN; TIM16_BKIN; TIM17_CH1; TIM4_CH1; TIM4_CH2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

LPTIM
(low power timer)

TIM17_CH1N/TIM4_CH2 | DFSDM1_CKIN5
TIM16_CH1N/TIM4_CH1 | DFSDM1_DATIN5

DFSDM1_CKIN3 | COMP1_OUT
DFSDM1_DATIN3 | COMP2_INP

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

NOTE: CIPO/COPI have previously
been referred to as MISO/MOSI

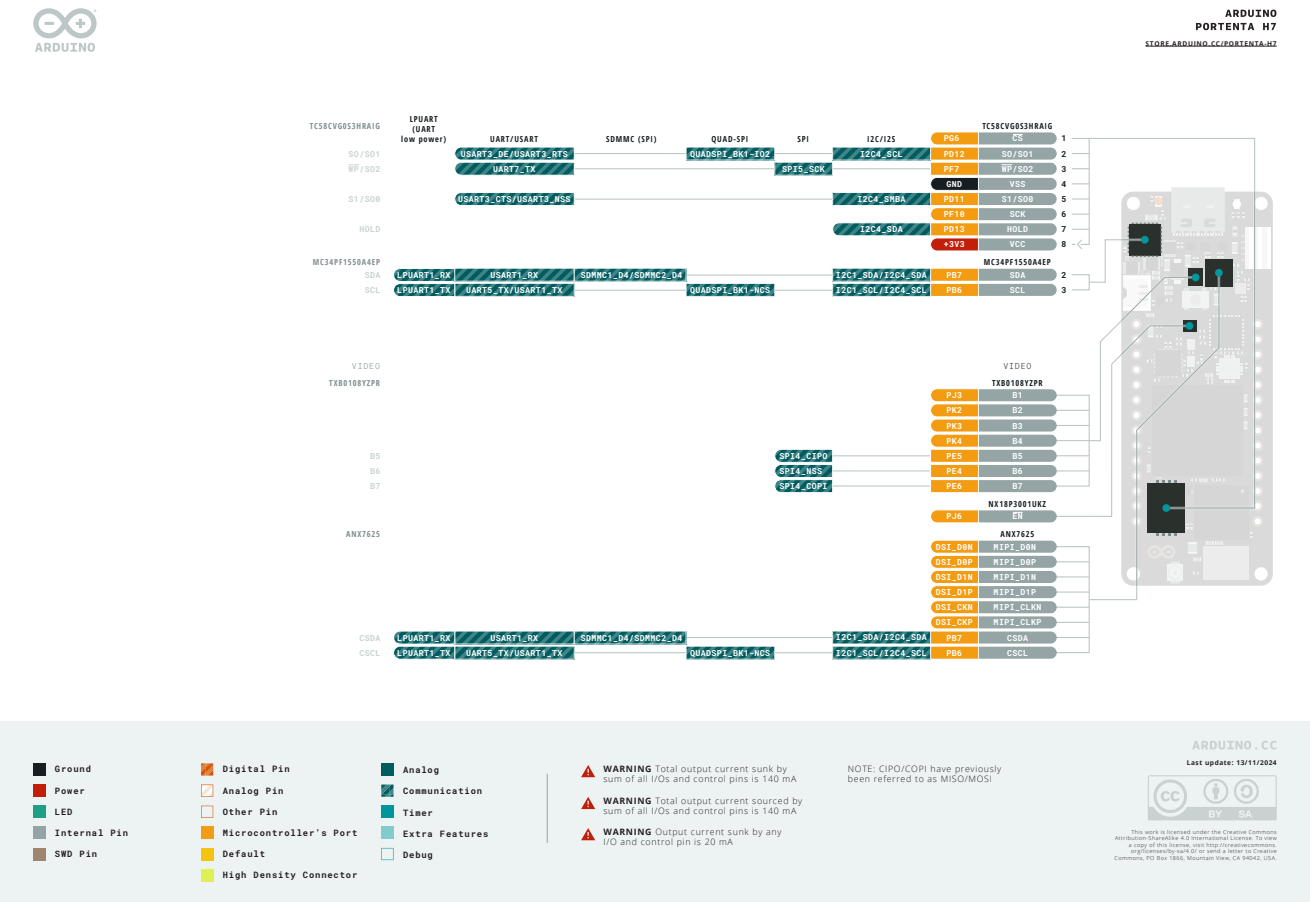
[picture p40: page 16]
Analog; Communication; Timer; Ground; Power; LED; Digital Pin; Analog Pin; Other Pin; Last update: 13/11/2024; GND; VSS; SCK; HOLD; VCC; SDA; SCL; MIPI_D0N MIPI_D0P MIPI_D1N MIPI_D1P MIPI_CLKN MIPI_CLKP CSDA CSCL; DSI_D0N DSI_D0P DSI_D1N DSI_D1P DSI_CKN DSI_CKP PB7 PB6; TC58CVG0S3HRAIG; VIDEO; TXB0108YZPR; NX18P3001UKZ; ANX7625; I2C4_SCL; I2C4_SMBA; I2C4_SDA; I2C1_SDA/I2C4_SDA I2C1_SCL/I2C4_SCL; SPI4_CIPO; SPI5_SCK; SPI4_NSS SPI4_COPI; USART3_DE/USART3_RTS; USART3_CTS/USART3_NSS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

NOTE: CIPO/COPI have previously
been referred to as MISO/MOSI

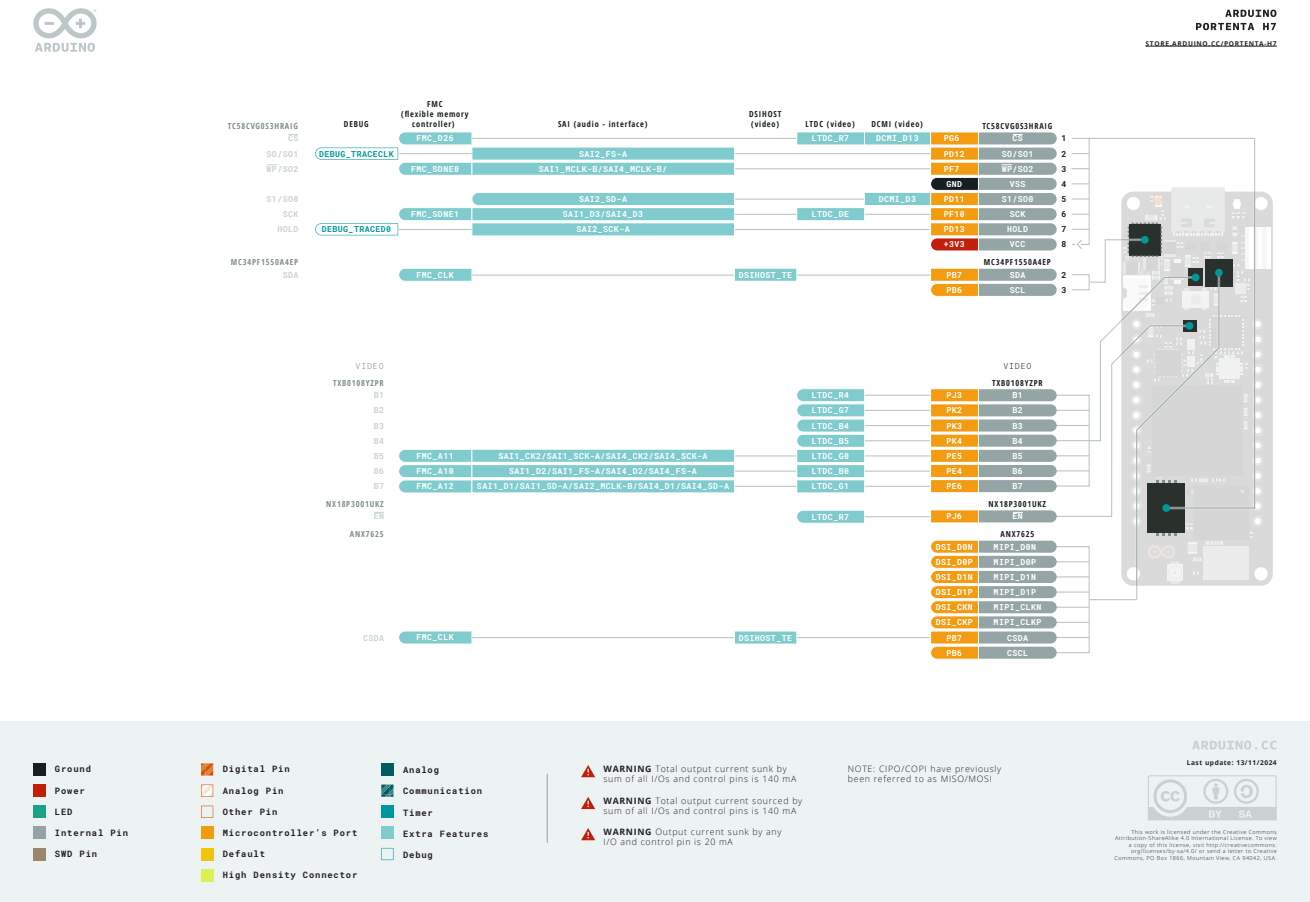
[picture p41: page 17]
Analog; Communication; Timer; Ground; Power; LED; Digital Pin; Analog Pin; Other Pin; Last update: 13/11/2024; GND; VSS; SCK; HOLD; VCC; SDA; SCL; MIPI_D0N MIPI_D0P MIPI_D1N MIPI_D1P MIPI_CLKN MIPI_CLKP CSDA CSCL; DSI_D0N DSI_D0P DSI_D1N DSI_D1P DSI_CKN DSI_CKP PB7 PB6; TC58CVG0S3HRAIG; VIDEO; TXB0108YZPR; NX18P3001UKZ; ANX7625; FMC_D26; FMC_SDNE0; FMC_SDNE1; FMC_CLK; FMC_A11 FMC_A10 FMC_A12; LTDC (video); DCMI (video); DSIHOST; SAI (audio - interface); (video); FMC (flexible memory; DEBUG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

NOTE: CIPO/COPI have previously
been referred to as MISO/MOSI

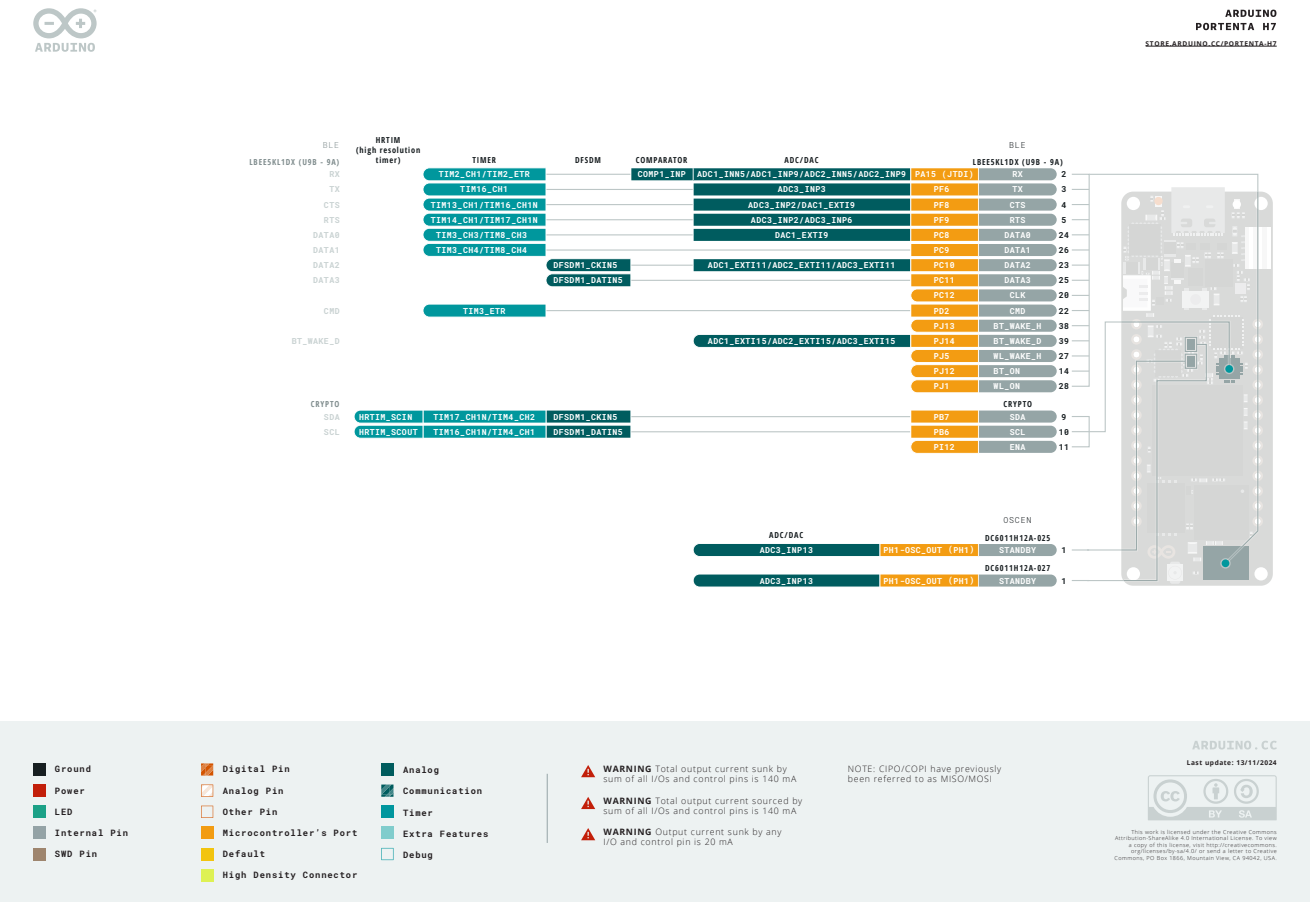
[picture p42: page 18]
Analog; Communication; Timer; Ground; Power; LED; Digital Pin; Analog Pin; Other Pin; Last update: 13/11/2024; ADC3_INP13; ADC1_EXTI11/ADC2_EXTI11/ADC3_EXTI11; ADC1_EXTI15/ADC2_EXTI15/ADC3_EXTI15; DFSDM1_CKIN5 DFSDM1_DATIN5; TIM2_CH1/TIM2_ETR; COMP1_INP; TIM16_CH1; TIM3_ETR; TIM13_CH1/TIM16_CH1N TIM14_CH1/TIM17_CH1N TIM3_CH3/TIM8_CH3 TIM3_CH4/TIM8_CH4; HRTIM_SCIN HRTIM_SCOUT; ADC/DAC; TIMER; DFSDM; COMPARATOR; HRTIM (high resolution timer) LBEE5KL1DX (U9B - 9A); CRYPTO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

ADC1_INN5/ADC1_INP9/ADC2_INN5/ADC2_INP9

ADC3_INP3
ADC3_INP2/DAC1_EXTI9
ADC3_INP2/ADC3_INP6
DAC1_EXTI9

TIM17_CH1N/TIM4_CH2 | DFSDM1_CKIN5
TIM16_CH1N/TIM4_CH1 | DFSDM1_DATIN5

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

NOTE: CIPO/COPI have previously
been referred to as MISO/MOSI

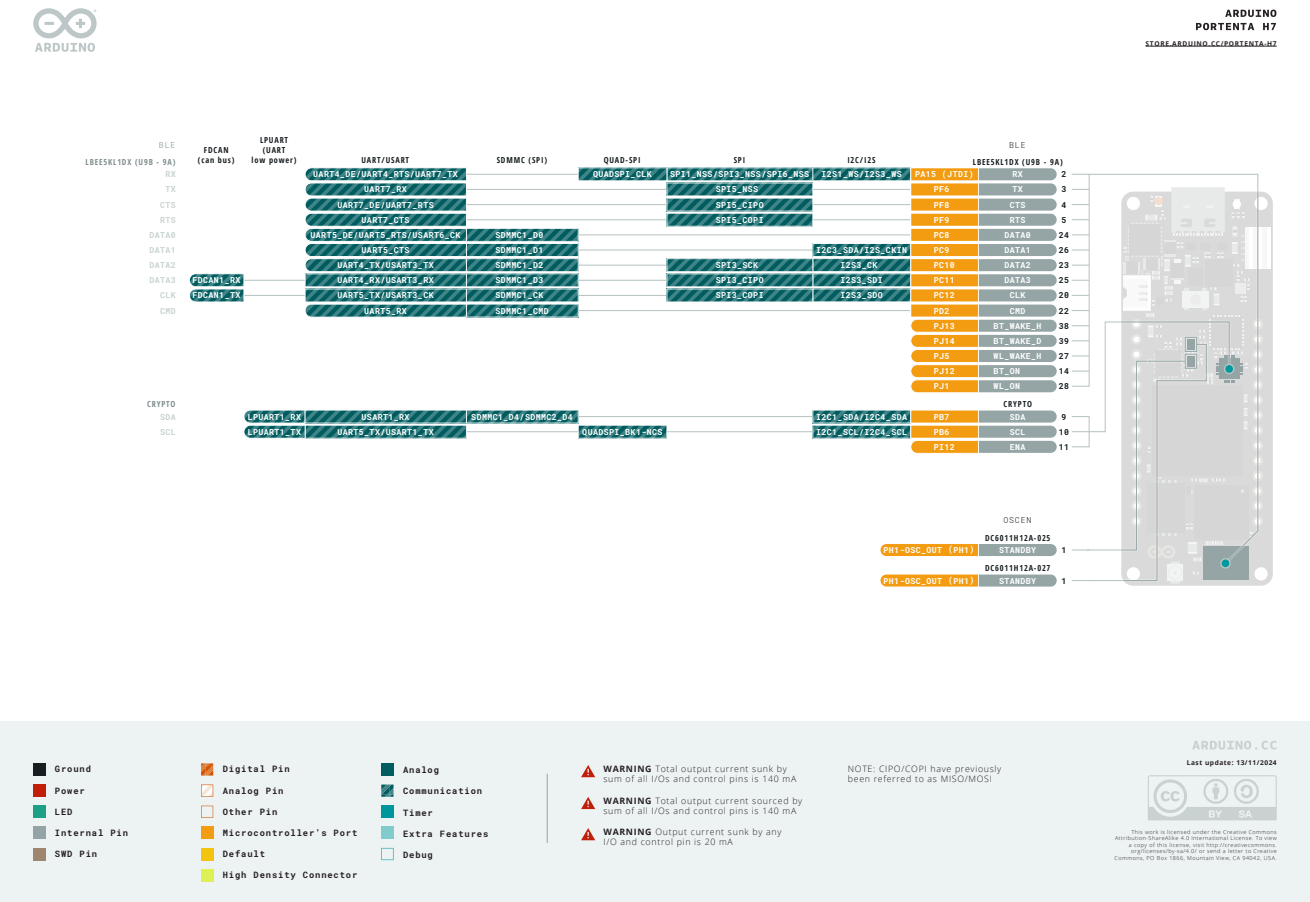
[picture p43: page 19]
Analog; Communication; Timer; Ground; Power; LED; Digital Pin; Analog Pin; Other Pin; Last update: 13/11/2024; I2C3_SDA/I2S_CKIN I2S3_CK I2S3_SDI I2S3_SDO; I2C1_SDA/I2C4_SDA I2C1_SCL/I2C4_SCL; SPI1_NSS/SPI3_NSS/SPI6_NSS SPI5_NSS SPI5_CIPO SPI5_COPI; SPI3_SCK SPI3_CIPO SPI3_COPI; UART4_DE/UART4_RTS/UART7_TX UART7_RX UART7_DE/UART7_RTS UART7_CTS UART5_DE/UART5_RTS/USART6_CK UART5_CTS UART4_TX/USART3_TX UART4_RX/USART3_RX UART5_TX/USART3_CK UART5_RX; USART1_RX UART5_TX/USART1_TX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

NOTE: CIPO/COPI have previously
been referred to as MISO/MOSI

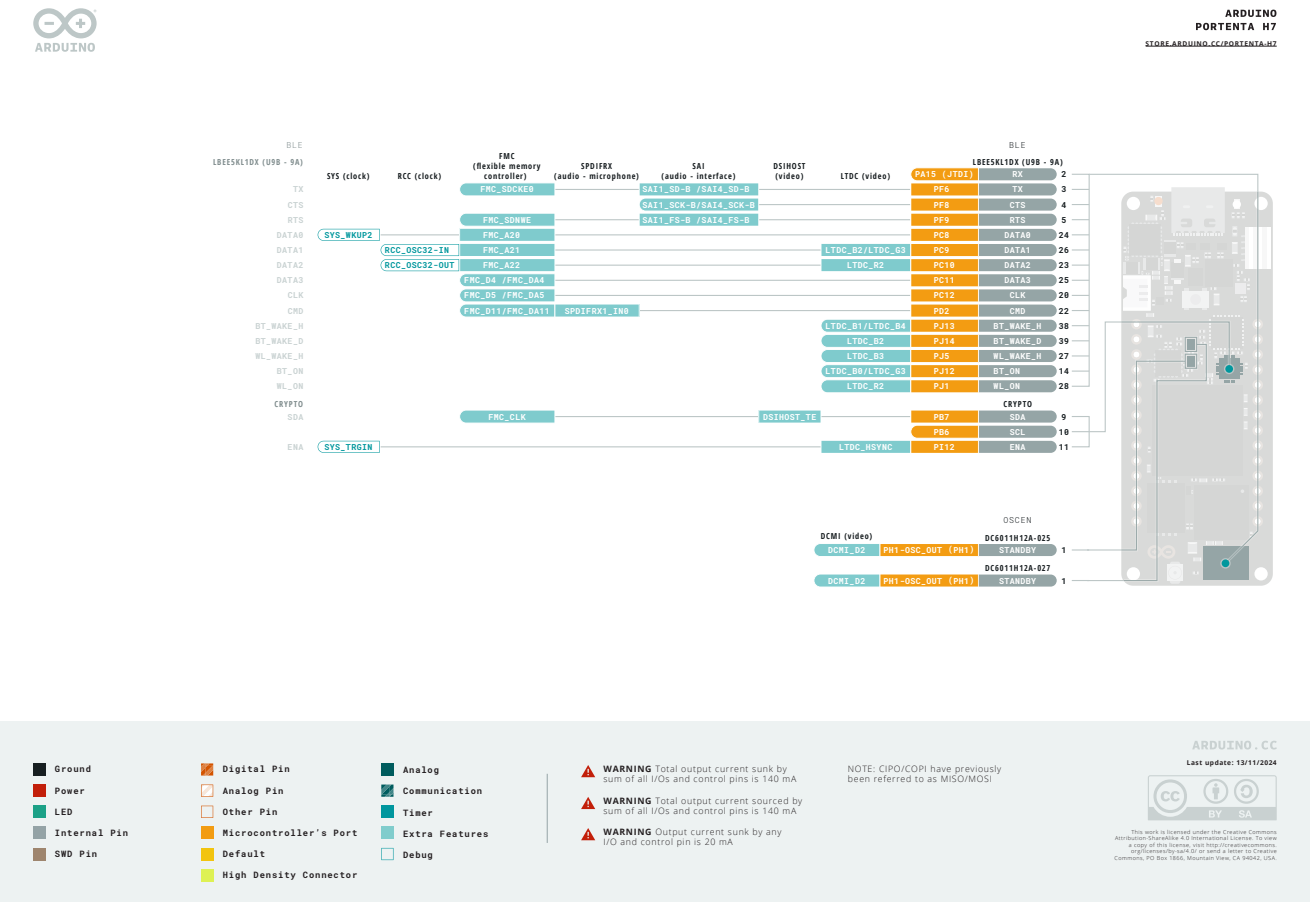
[picture p44: page 20]
Analog; Communication; Timer; Ground; Power; LED; Digital Pin; Analog Pin; Other Pin; Last update: 13/11/2024; FMC_SDCKE0; FMC_SDNWE FMC_A20 FMC_A21; FMC_CLK; FMC_A22 FMC_D4 /FMC_DA4 FMC_D5 /FMC_DA5 FMC_D11/FMC_DA11; LTDC (video); DSIHOST (video); SAI (audio - interface); FMC (flexible memory controller); SPDIFRX; SYS (clock); RCC (clock); (audio - microphone); SAI1_SD-B /SAI4_SD-B SAI1_SCK-B/SAI4_SCK-B SAI1_FS-B /SAI4_FS-B; SPDIFRX1_IN0; DSIHOST_TE; RCC_OSC32-IN RCC_OSC32-OUT; SYS_WKUP2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

NOTE: CIPO/COPI have previously
been referred to as MISO/MOSI

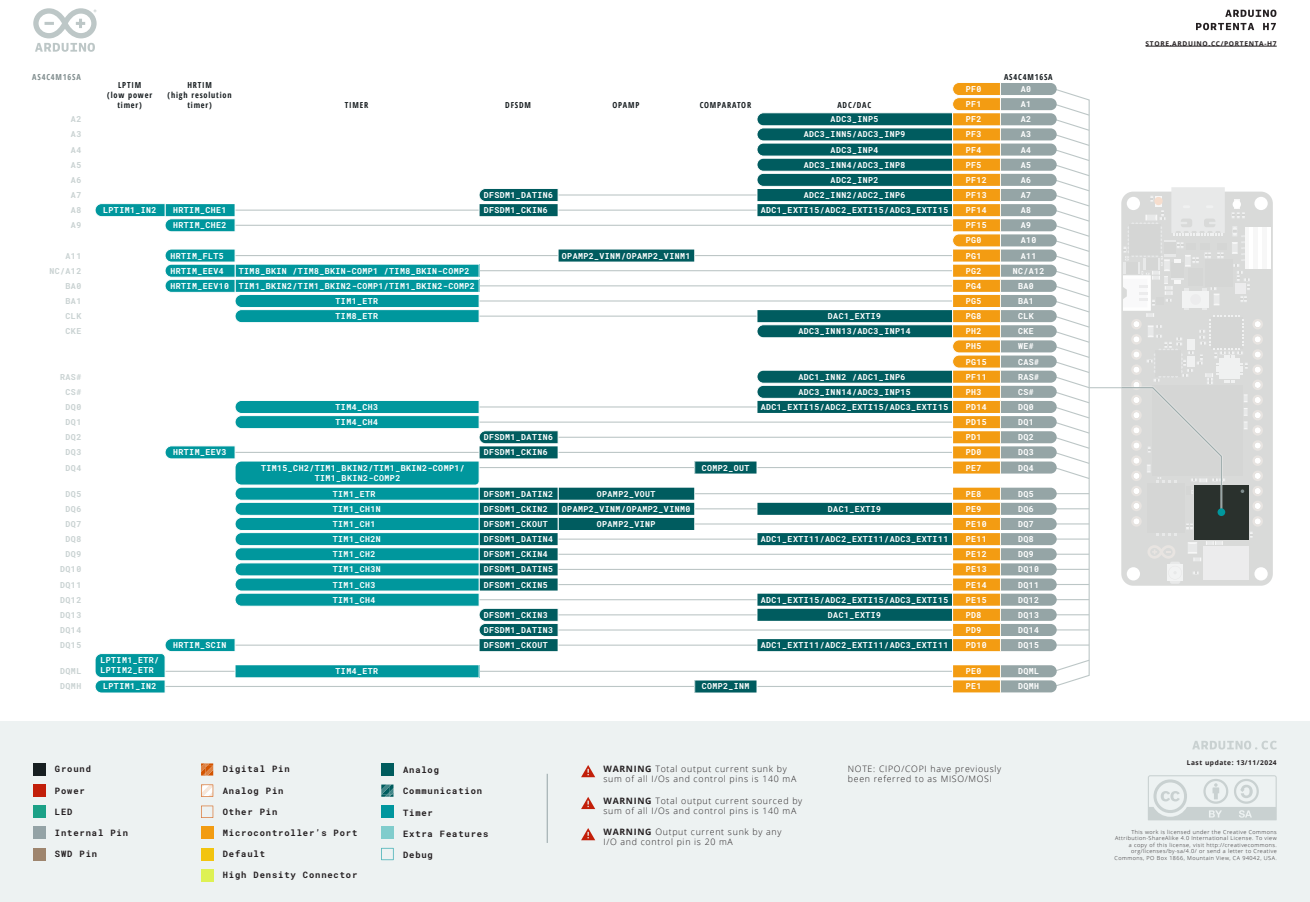
[picture p45: page 21]
Analog; Communication; Timer; Ground; Power; LED; Digital Pin; Analog Pin; Other Pin; Last update: 13/11/2024; ADC3_INP5 ADC3_INN5/ADC3_INP9 ADC3_INP4 ADC3_INN4/ADC3_INP8 ADC2_INP2; DAC1_EXTI9; ADC2_INN2/ADC2_INP6; ADC3_INN13/ADC3_INP14; ADC1_INN2 /ADC1_INP6 ADC3_INN14/ADC3_INP15; ADC1_EXTI15/ADC2_EXTI15/ADC3_EXTI15; ADC1_EXTI11/ADC2_EXTI11/ADC3_EXTI11; OPAMP2_VINM/OPAMP2_VINM1; OPAMP2_VOUT OPAMP2_VINM/OPAMP2_VINM0; COMP2_OUT; COMP2_INM; DFSDM1_DATIN6 DFSDM1_CKIN6; DFSDM1_DATIN6; DFSDM1_DATIN2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

DFSDM1_CKOUT | OPAMP2_VINP
DFSDM1_DATIN4 | | ADC1_EXTI11/ADC2_EXTI11/ADC3_EXTI11

ADC1_EXTI15/ADC2_EXTI15/ADC3_EXTI15

DAC1_EXTI9

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

NOTE: CIPO/COPI have previously
been referred to as MISO/MOSI

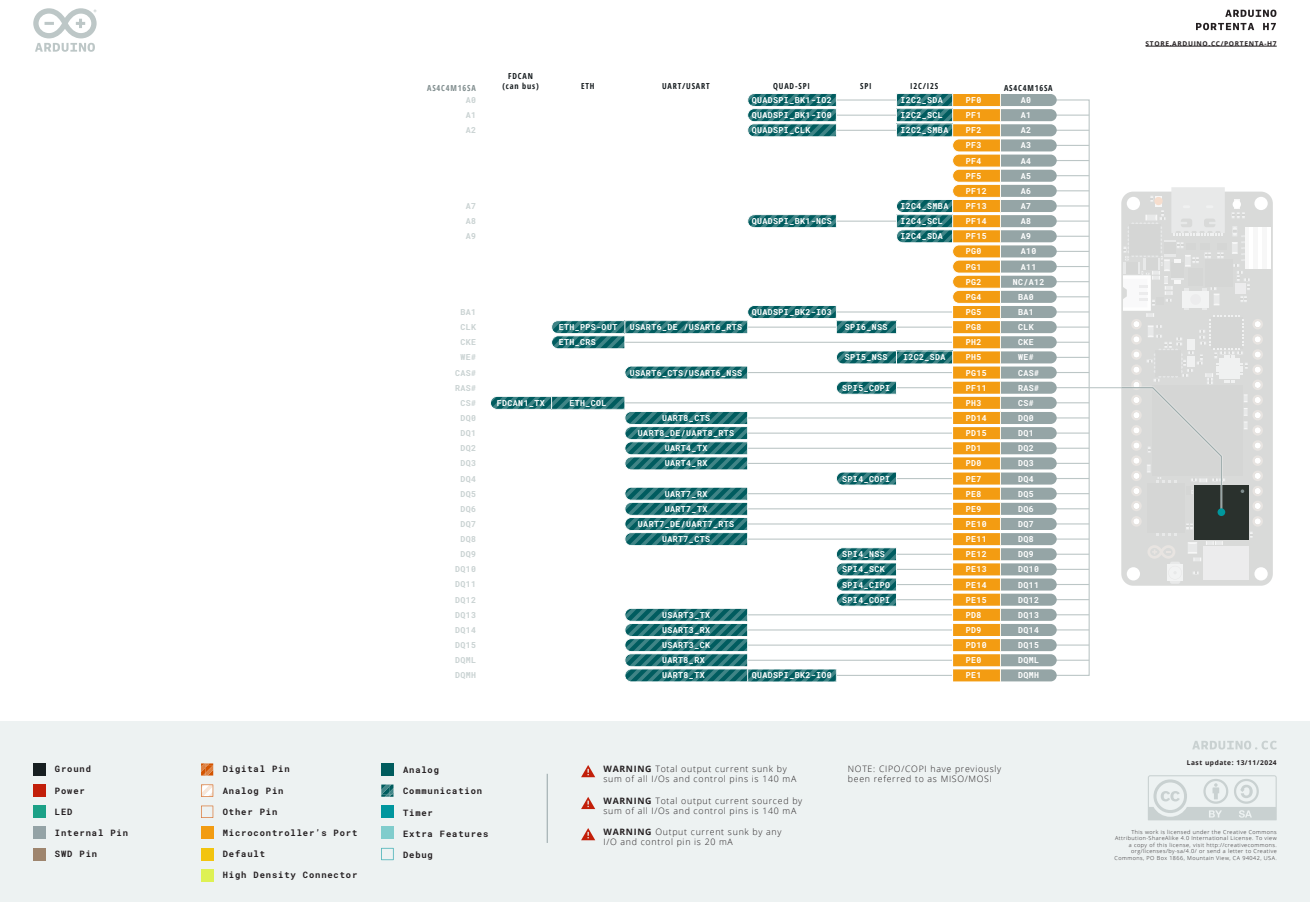
[picture p46: page 22]
Analog; Communication; Timer; Ground; Power; LED; Digital Pin; Analog Pin; Other Pin; Last update: 13/11/2024; CLK; CKE; CAS#; RAS#; DQML; DQMH; I2C4_SMBA I2C4_SCL I2C4_SDA; I2C2_SDA; SPI6_NSS; SPI5_NSS; SPI5_COPI; SPI4_COPI; SPI4_NSS SPI4_SCK SPI4_CIPO SPI4_COPI; ETH_PPS-OUT; ETH_COL; ETH_CRS; FDCAN1_TX; ETH; UART/USART; QUAD-SPI; SPI; FDCAN (can bus); USART6_DE /USART6_RTS; USART6_CTS/USART6_NSS; UART8_CTS UART8_DE/UART8_RTS UART4_TX UART4_RX; UART7_RX UART7_TX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

I2C2_SDA
I2C2_SCL
I2C2_SMBA

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

NOTE: CIPO/COPI have previously
been referred to as MISO/MOSI

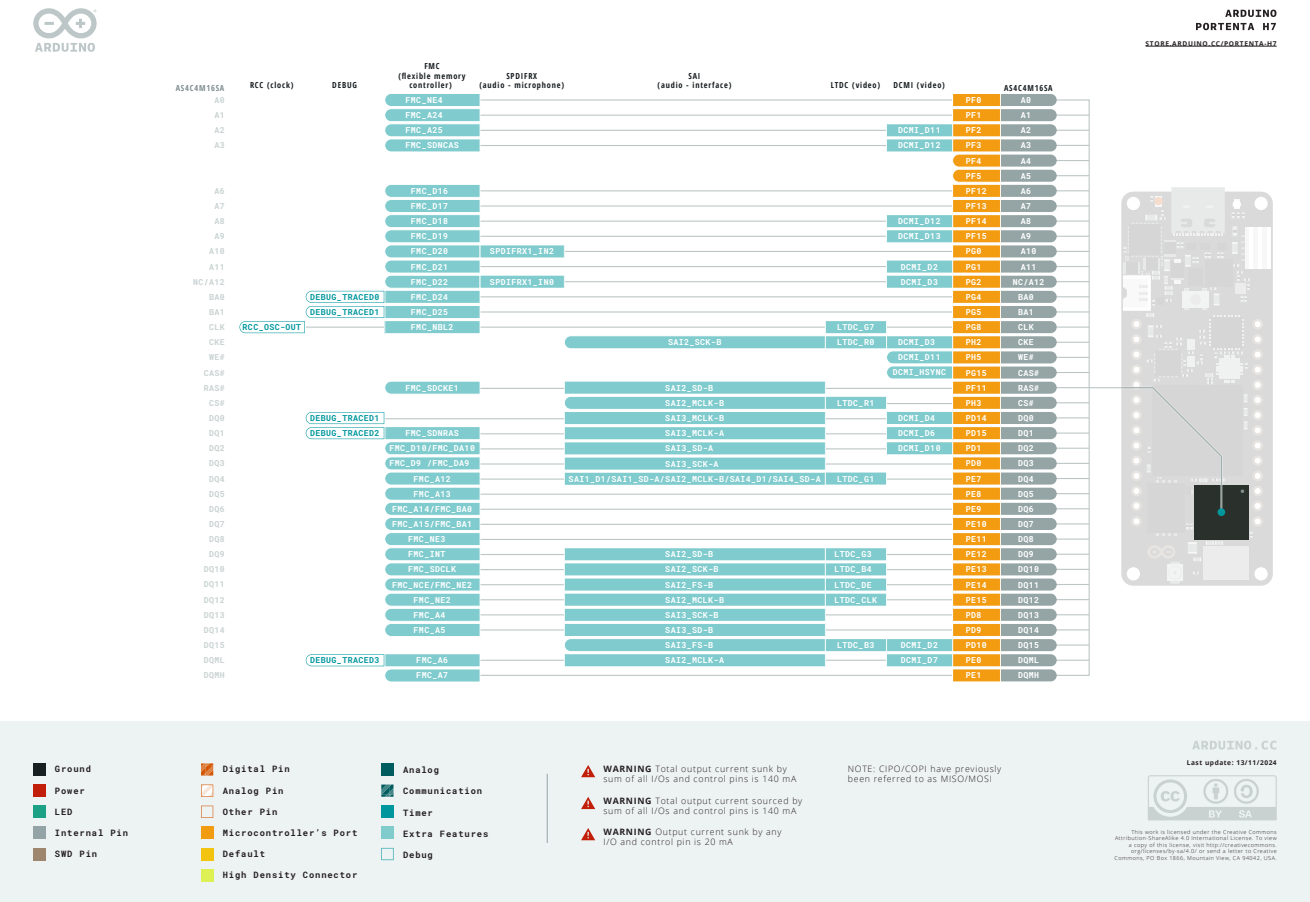
[picture p47: page 23]
Analog; Communication; Timer; Ground; Power; LED; Digital Pin; Analog Pin; Other Pin; Last update: 13/11/2024; CLK; CKE; CAS#; RAS#; DQML; DQMH; A6 A7 A8 A9 A10 A11 NC/A12 BA0 BA1 CLK CKE WE# CAS# RAS# CS# DQ0 DQ1 DQ2 DQ3 DQ4 DQ5 DQ6 DQ7 DQ8 DQ9 DQ10 DQ11 DQ12 DQ13 DQ14 DQ15 DQML; FMC_NE4 FMC_A24; FMC_D16 FMC_D17 FMC_D18 FMC_D19 FMC_D20 FMC_D21 FMC_D22 FMC_D24 FMC_D25 FMC_NBL2; FMC_SDCKE1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

LTDC (video) DCMI (video)

DCMI_D11
DCMI_D12

DCMI_D13

SAI2_SD-B | LTDC_G3
SAI2_SCK-B | LTDC_B4
SAI2_FS-B | LTDC_DE
SAI2_MCLK-B | LTDC_CLK

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

NOTE: CIPO/COPI have previously
been referred to as MISO/MOSI

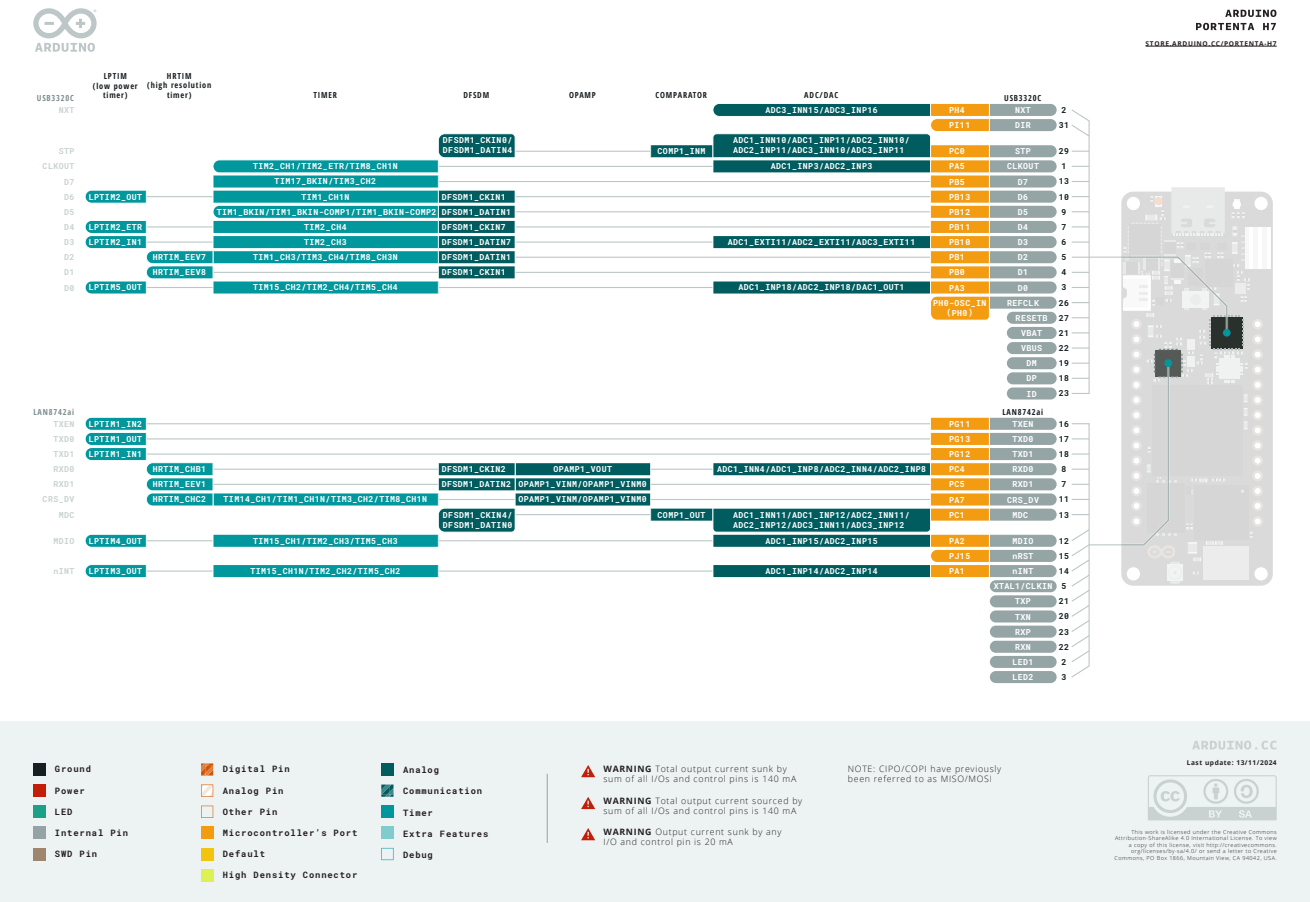
[picture p48: page 24]

DFSDM1_DATIN2 | OPAMP1_VINM/OPAMP1_VINM0

TIM14_CH1/TIM1_CH1N/TIM3_CH2/TIM8_CH1N | | OPAMP1_VINM/OPAMP1_VINM0

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

NOTE: CIPO/COPI have previously
been referred to as MISO/MOSI

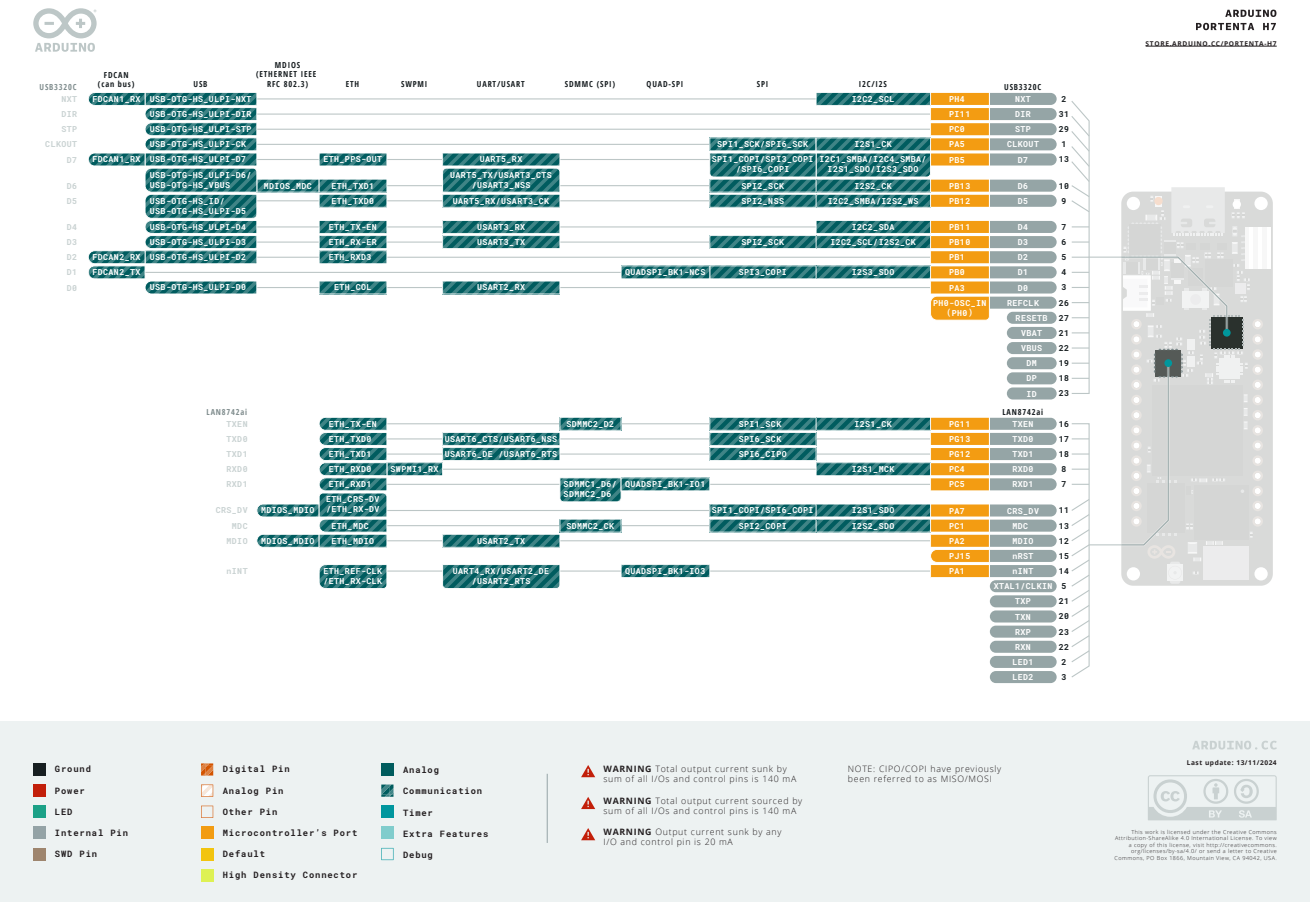
[picture p49: page 25]
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

NOTE: CIPO/COPI have previously
been referred to as MISO/MOSI

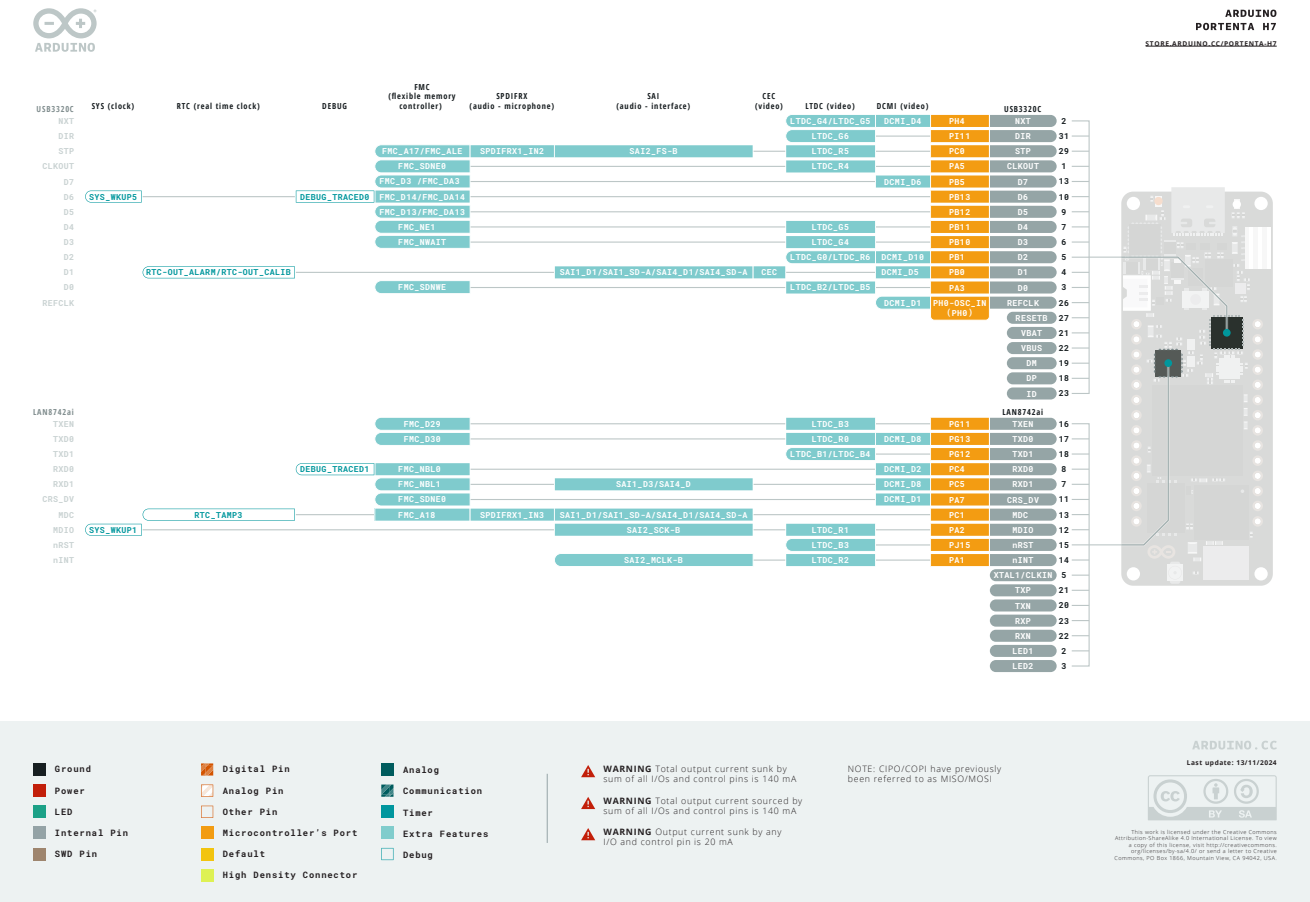
[picture p50: page 26]

DCMI_D6

DEBUG_TRACED0 | FMC_D14/FMC_DA14

DCMI_D1

FMC_A18 | SPDIFRX1_IN3 | SAI1_D1/SAI1_SD-A/SAI4_D1/SAI4_SD-A

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

NOTE: CIPO/COPI have previously
been referred to as MISO/MOSI
