shahzaibWaseem27/HSHL_ELE_Shahzaib_Waseem_Project_Work/previous_student_project_files/PCB Schematic.pdf

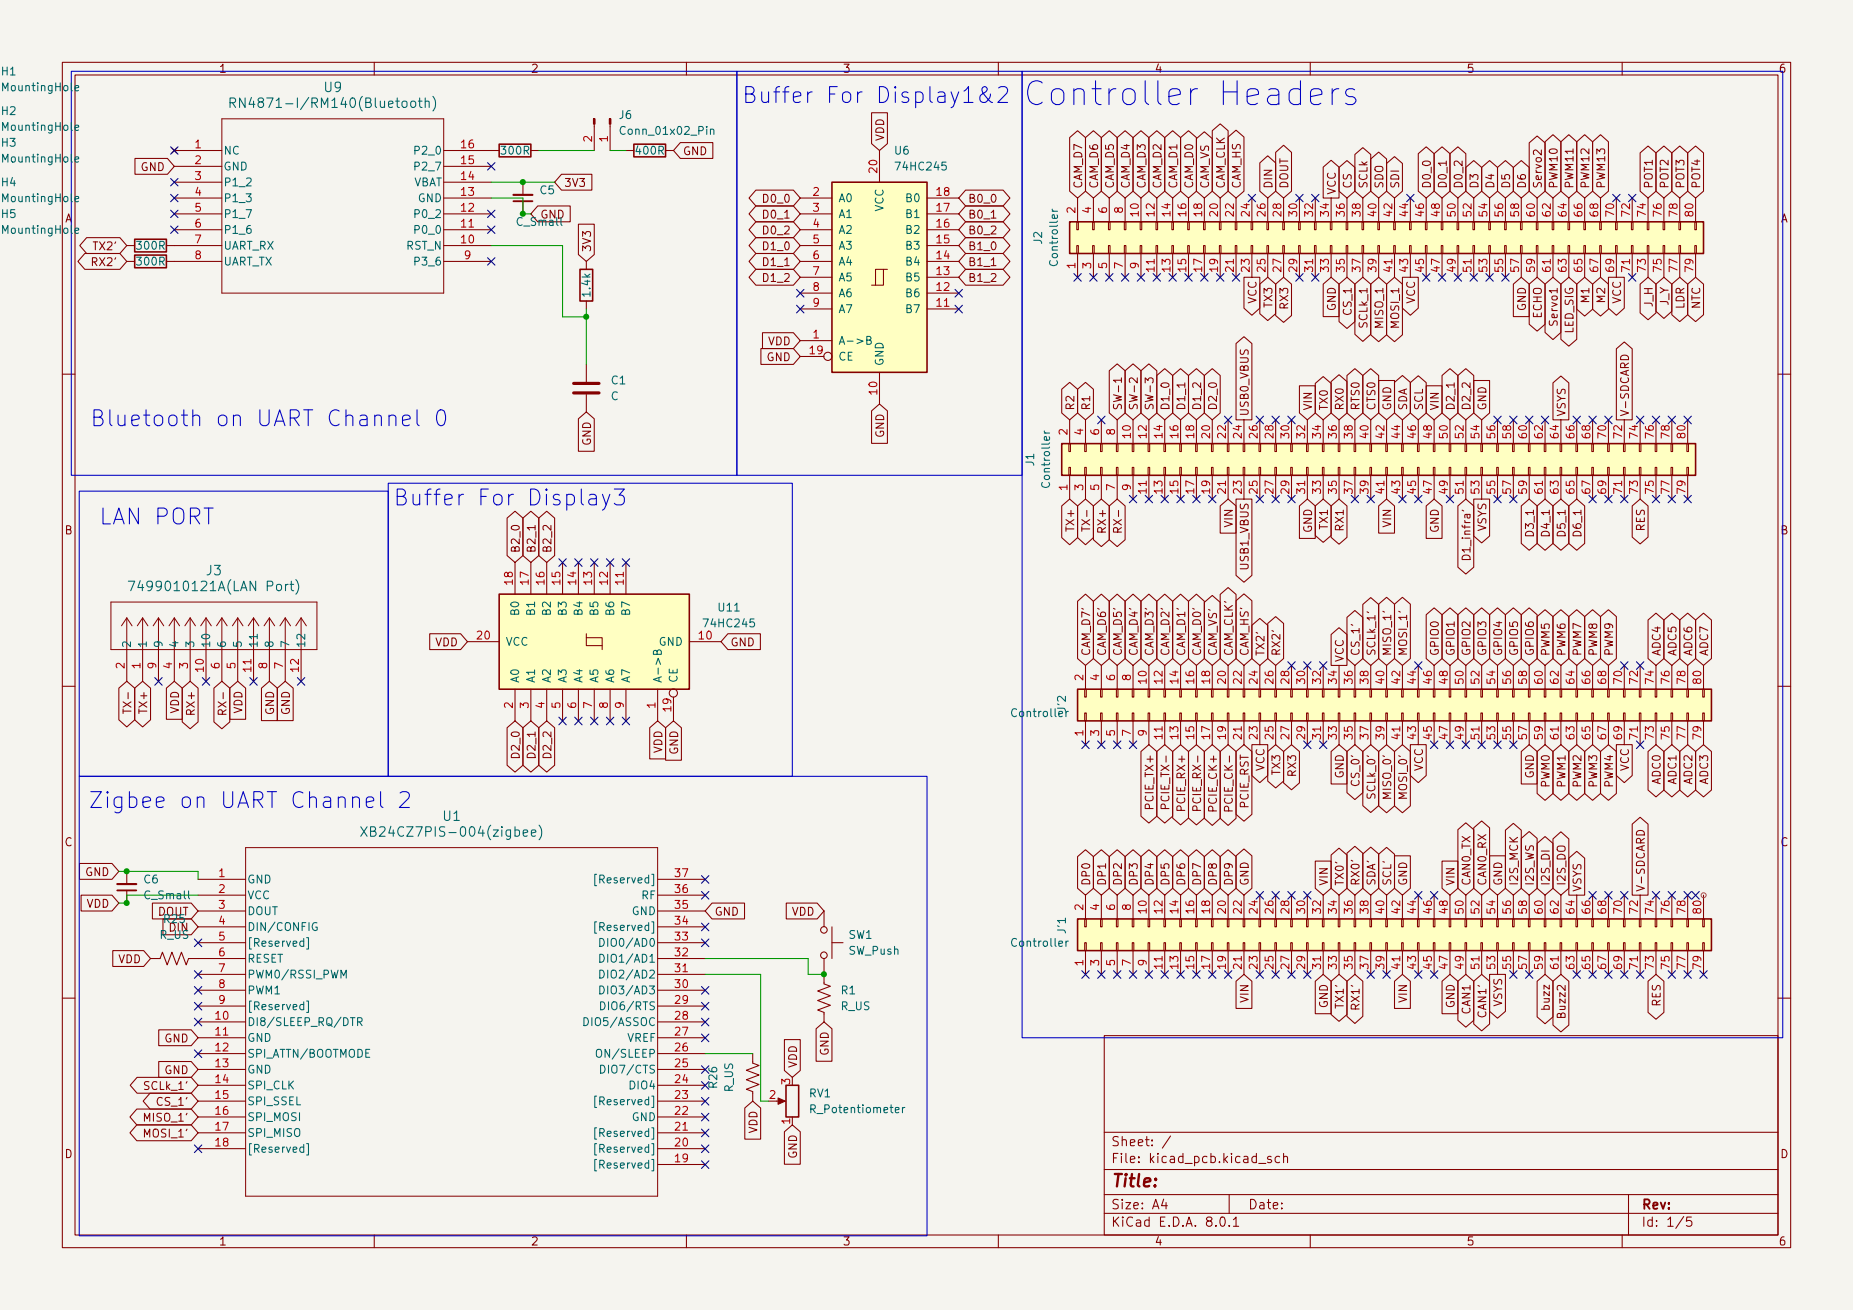
[picture p51: page 1]

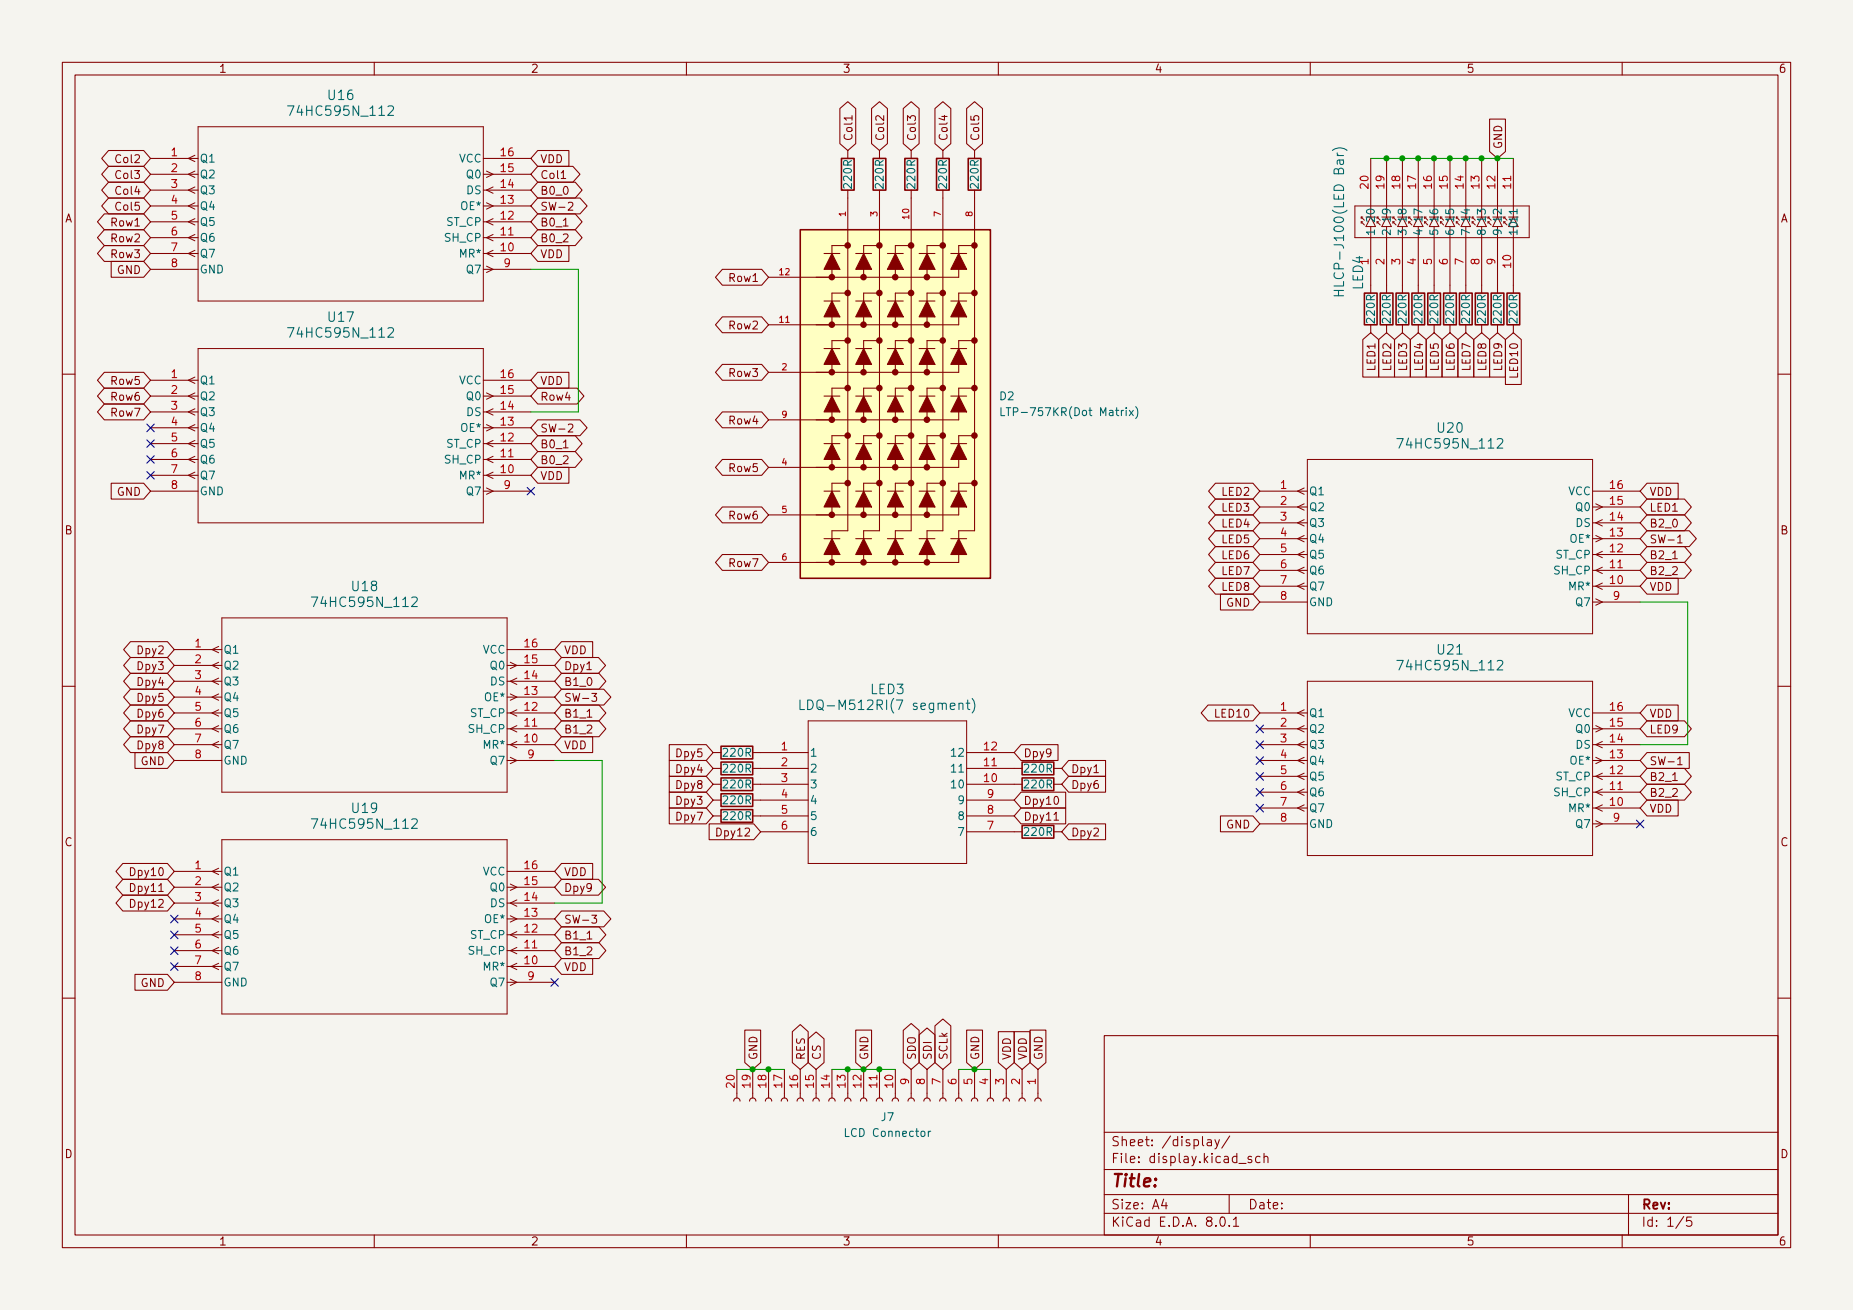
[picture p52: page 2]

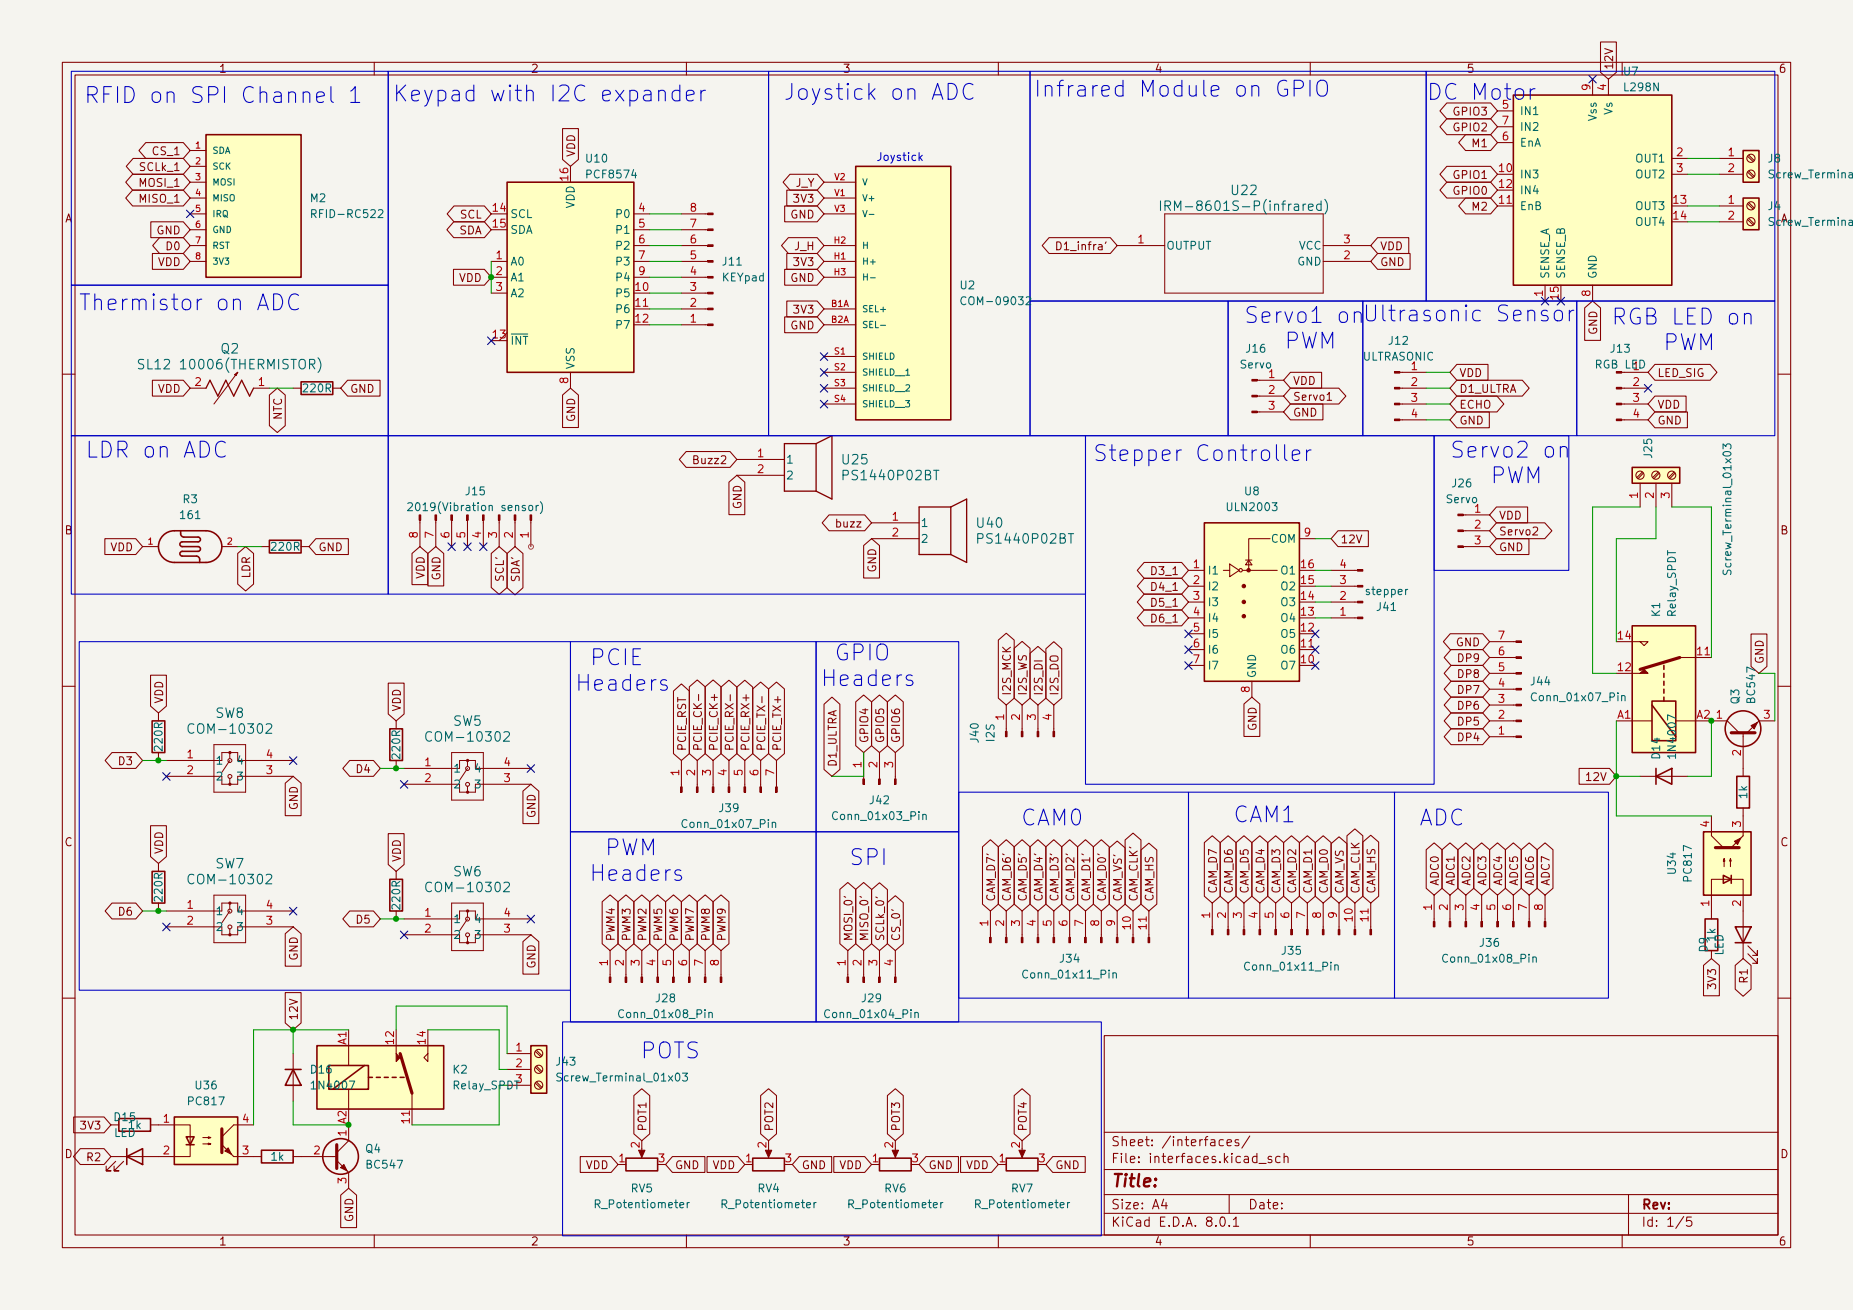
[picture p53: page 3]

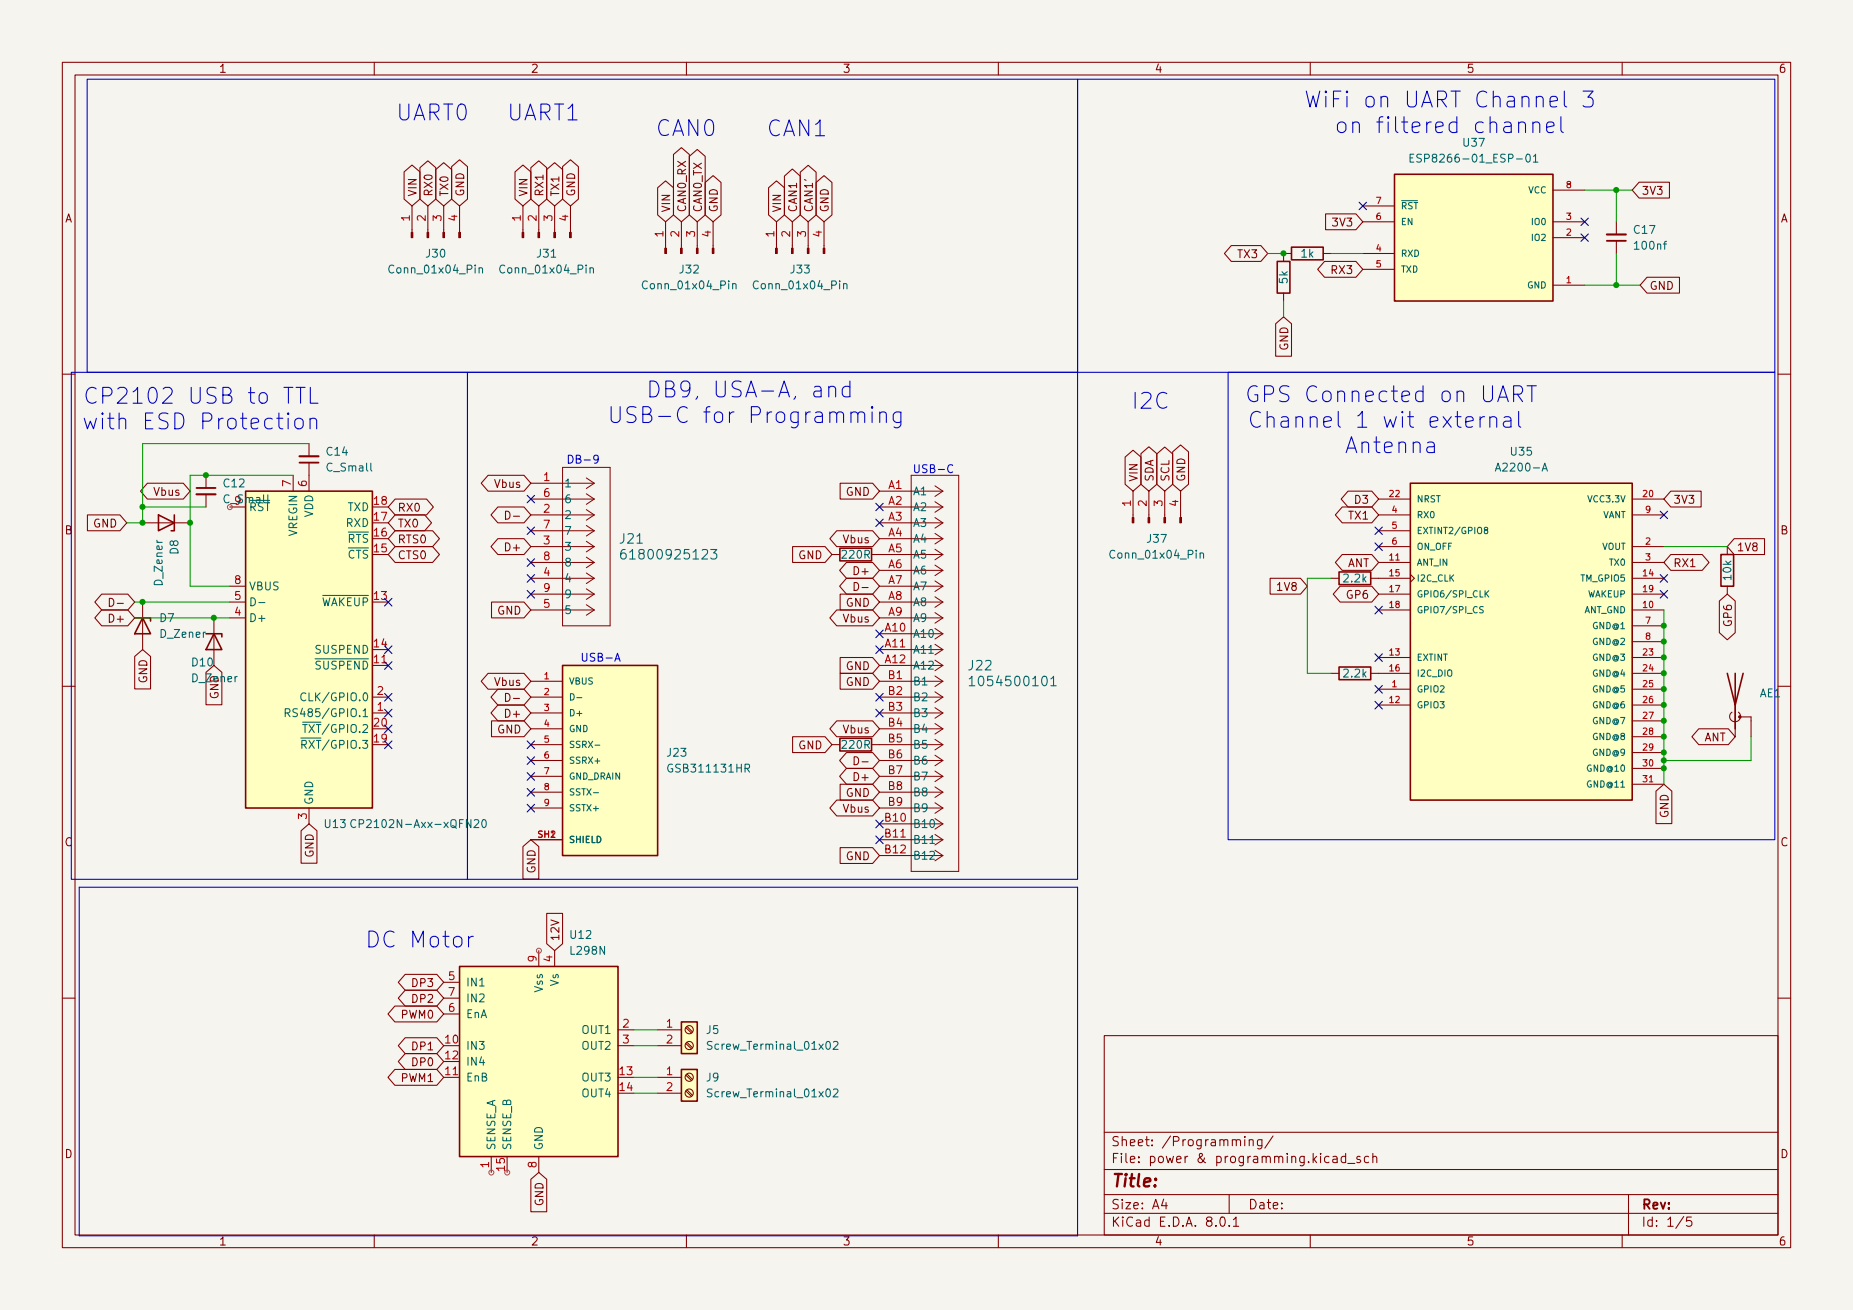
[picture p54: page 4]

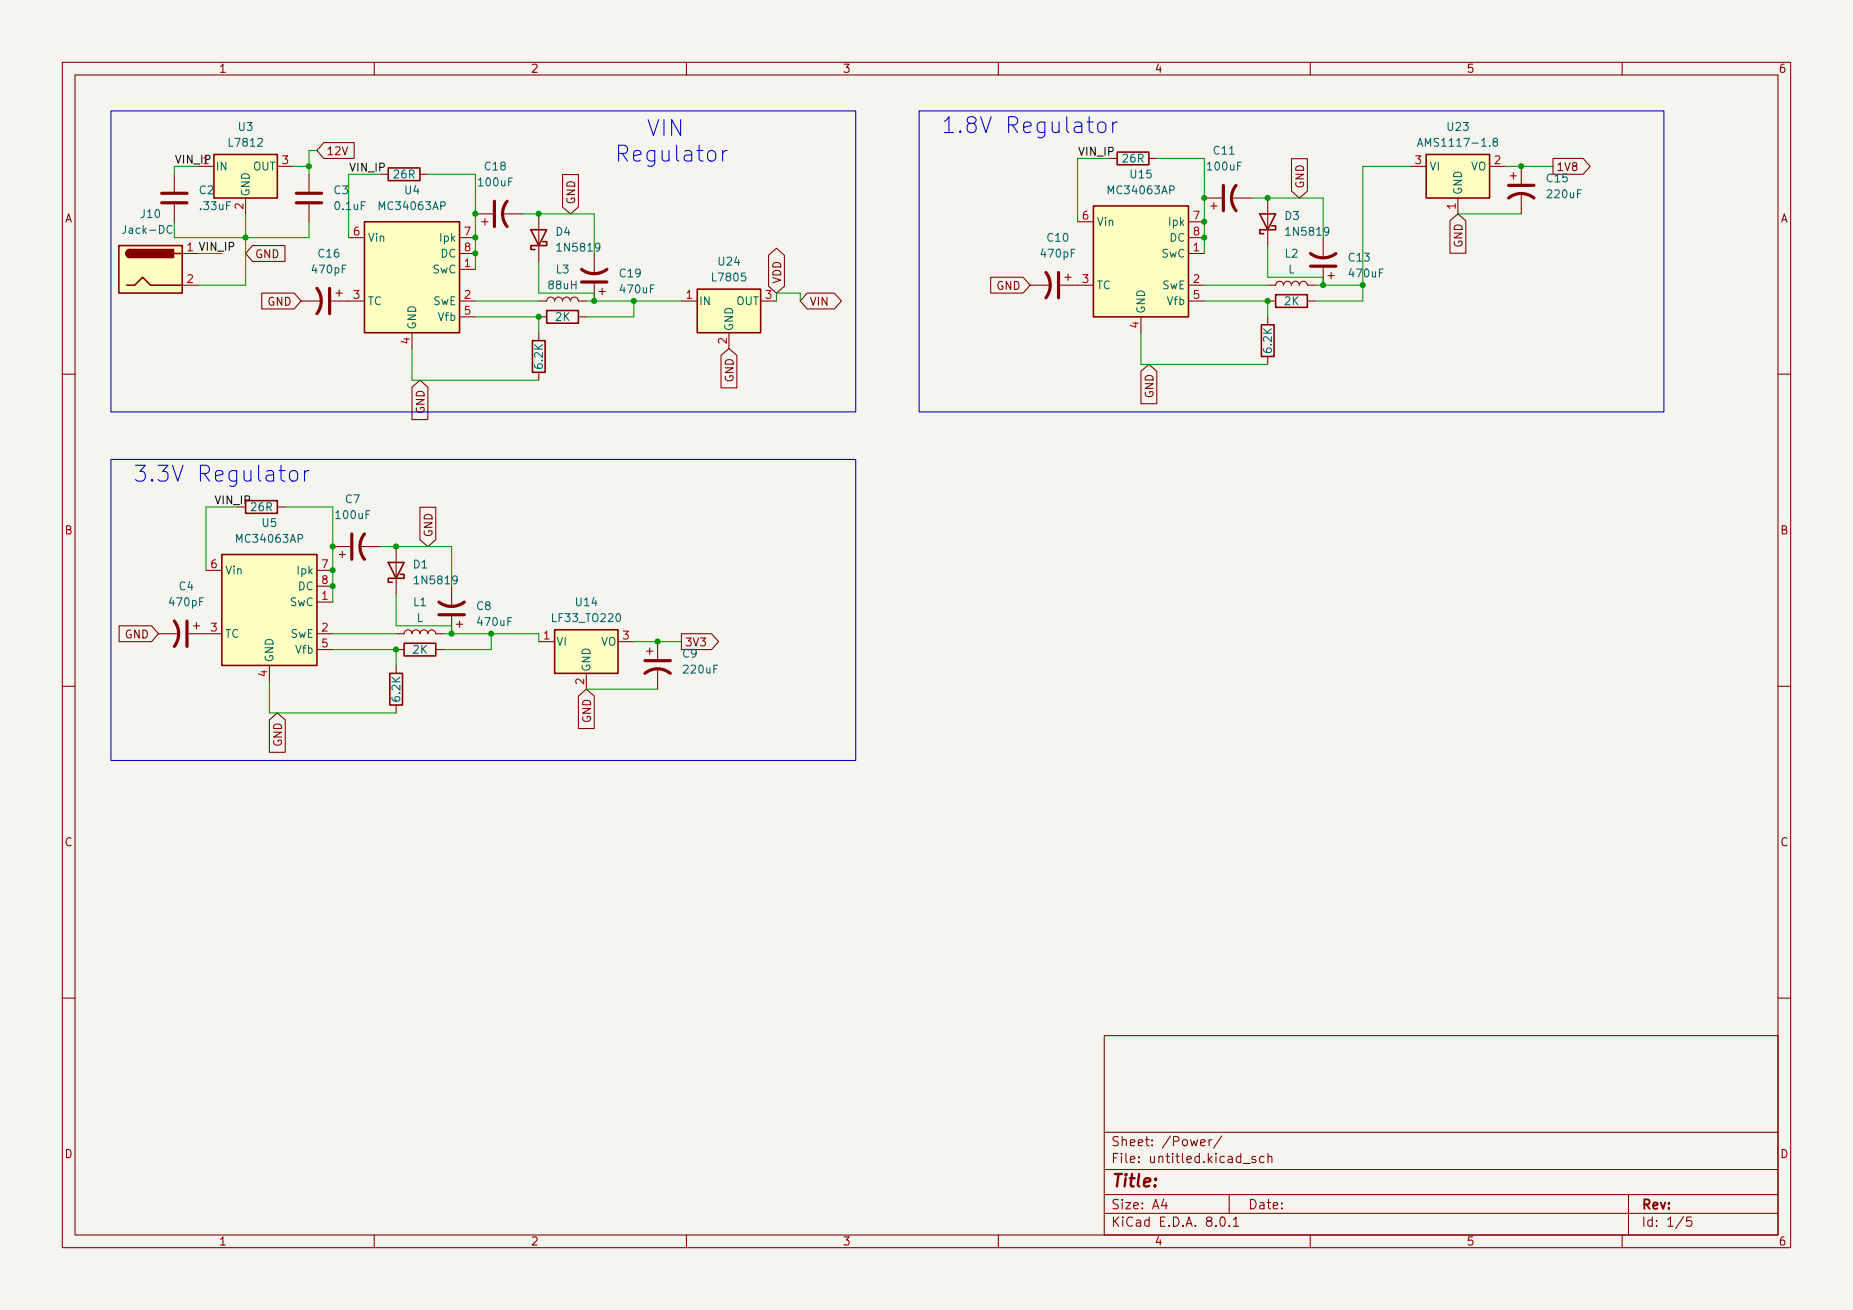
[picture p55: page 5]
