shahzaibWaseem27/HSHL_ELE_Shahzaib_Waseem_Project_Work/project_files/kicad_pcb.kicad_pcb

## KiCad design project_files/kicad_pcb.kicad_pcb (2025-02-12)

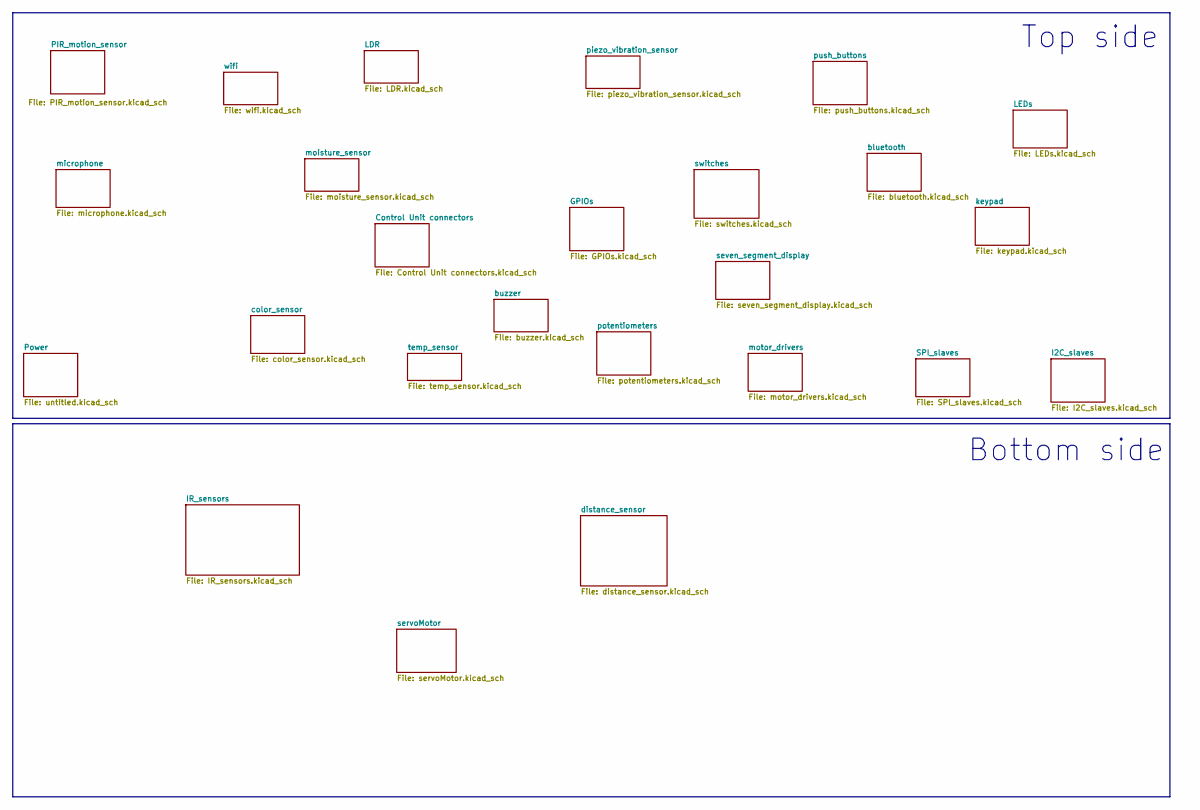
[picture p56: schematic kicad_pcb.kicad_sch]

Notes on the sheet:
Bottom side
Top side

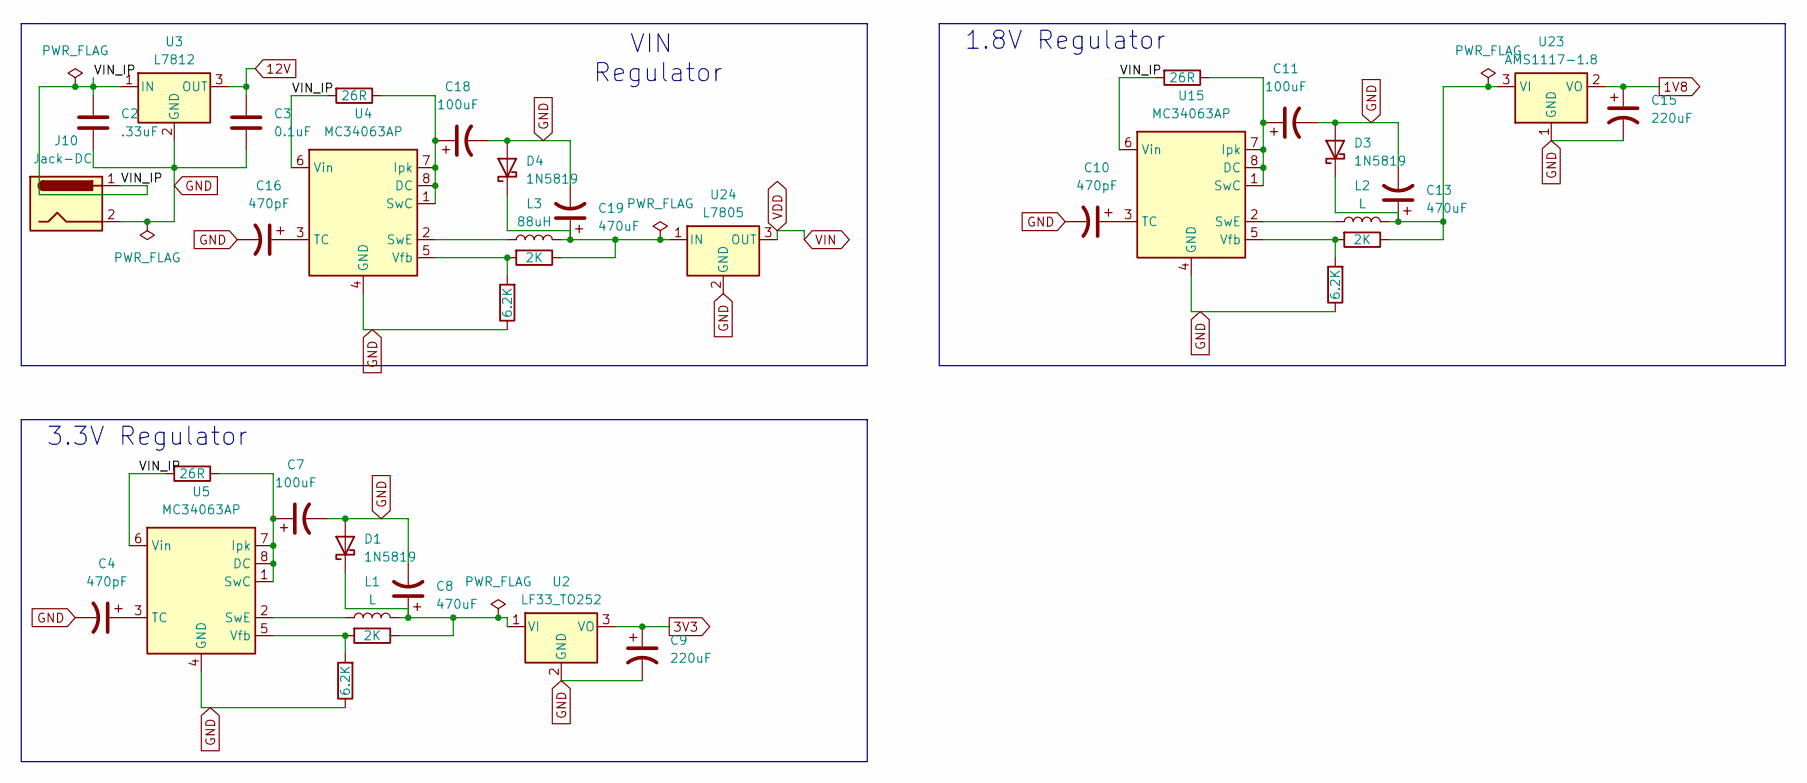
[picture p57: schematic untitled.kicad_sch]

Parts:
C2: .33uF; C_0805_2012Metric
C3: 0.1uF; C_0805_2012Metric
C4, C10, C16: 470pF; CP_Elec_3x5.3
C7, C11, C18: 100uF; CP_Elec_6.3x7.7
C8, C13, C19: 470uF; CP_Elec_6.3x7.7
C9, C15: 220uF; CP_Elec_6.3x7.7
D1, D3, D4: 1N5819; D_2114_3652Metric
J10: Jack-DC; BarrelJack_SwitchcraftConxall_RAPC10U_Horizontal
L1, L2: L; L_10.4x10.4_H4.8
L3: 88uH; L_10.4x10.4_H4.8
R2, R6, R9: 26R; R_0603_1608Metric
R4, R7, R10: 6.2K; R_0603_1608Metric
R5, R8, R11: 2K; R_0603_1608Metric
U2: LF33_TO252; TO-252-2
U3: L7812; TO-252-2
U4, U5, U15: MC34063AP; DIP-8_W8.89mm_SMDSocket_LongPads
U23: AMS1117-1.8; SOT-223-3_TabPin2
U24: L7805; TO-252-2

Connections:
1V8: C15.1, U23.2 (VO)
3V3: C9.1, U2.3 (VO); also elsewhere on the board
12V: C3.1, U3.3 (OUT); also elsewhere on the board
/Power/VIN_IP: C2.1, J10.1, R2.2, R6.2, R9.2, U3.1 (IN), U4.6 (Vin), U5.6 (Vin), U15.6 (Vin)
GND: C2.2, C3.2, C4.2, C7.2, C8.2, C9.2, C10.2, C11.2, C13.2, C15.2, C16.2, C18.2, C19.2, D1.2 (A), D3.2 (A), D4.2 (A), J10.2, R4.1, R7.1, R10.1, U2.2 (GND), U3.2 (GND), U4.4 (GND), U5.4 (GND), U15.4 (GND), U23.1 (GND), U24.2 (GND); also elsewhere on the board
unnamed: C8.1, D1.1 (K), L1.2, R5.1, U2.1 (VI)
unnamed: C13.1, D3.1 (K), L2.2, R8.1, U23.3 (VI)
unnamed: C19.1, D4.1 (K), L3.2, R11.1, U24.1 (IN)
unnamed: C18.1, R9.1, U4.1 (SwC), U4.7 (Ipk), U4.8 (DC)
unnamed: L3.1, U4.2 (SwE)
unnamed: C16.1, U4.3 (TC)
unnamed: R10.2, R11.2, U4.5 (Vfb)
unnamed: C7.1, R2.1, U5.1 (SwC), U5.7 (Ipk), U5.8 (DC)
unnamed: L1.1, U5.2 (SwE)
unnamed: C4.1, U5.3 (TC)
unnamed: R4.2, R5.2, U5.5 (Vfb)
unnamed: C11.1, R6.1, U15.1 (SwC), U15.7 (Ipk), U15.8 (DC)
unnamed: L2.1, U15.2 (SwE)
unnamed: C10.1, U15.3 (TC)
unnamed: R7.2, R8.2, U15.5 (Vfb)
VDD: U24.3 (OUT); also elsewhere on the board

Notes on the sheet:
1.8V Regulator
VIN Regulator
3.3V Regulator

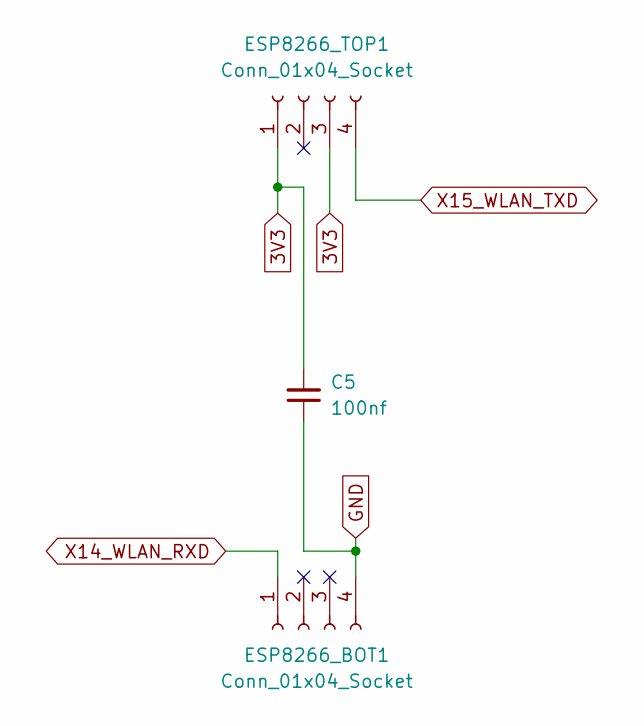
[picture p58: schematic wifi.kicad_sch]

Parts:
C5: 100nf; C_0603_1608Metric
ESP8266_BOT1, ESP8266_TOP1: Conn_01x04_Socket; PinSocket_1x04_P2.54mm_Vertical_SMD_Pin1Left

Connections:
3V3: C5.2, ESP8266_TOP1.1, ESP8266_TOP1.3; also elsewhere on the board
GND: C5.1, ESP8266_BOT1.4; also elsewhere on the board
X14_WLAN_RXD: ESP8266_BOT1.1; also elsewhere on the board
X15_WLAN_TXD: ESP8266_TOP1.4; also elsewhere on the board

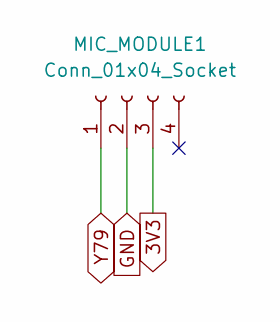
[picture p59: schematic microphone.kicad_sch]

Parts:
MIC_MODULE1: Conn_01x04_Socket; PinSocket_1x04_P2.54mm_Vertical_SMD_Pin1Left

Connections:
3V3: MIC_MODULE1.3; also elsewhere on the board
GND: MIC_MODULE1.2; also elsewhere on the board
Y79: MIC_MODULE1.1; also elsewhere on the board

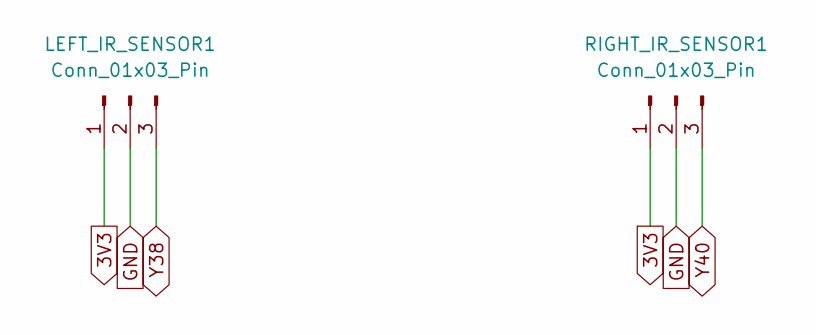
[picture p60: schematic IR_sensors.kicad_sch]

Parts:
LEFT_IR_SENSOR1: Conn_01x03_Pin; PinHeader_1x03_P2.54mm_Vertical_SMD_Pin1Left
RIGHT_IR_SENSOR1: Conn_01x03_Pin; PinHeader_1x03_P2.54mm_Vertical_SMD_Pin1Left

Connections:
3V3: LEFT_IR_SENSOR1.1, RIGHT_IR_SENSOR1.1; also elsewhere on the board
GND: LEFT_IR_SENSOR1.2, RIGHT_IR_SENSOR1.2; also elsewhere on the board
Y38: LEFT_IR_SENSOR1.3; also elsewhere on the board
Y40: RIGHT_IR_SENSOR1.3; also elsewhere on the board

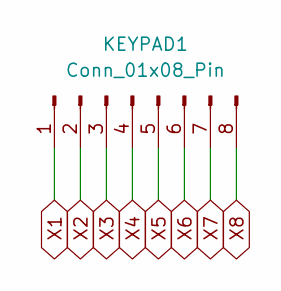
[picture p61: schematic keypad.kicad_sch]

Parts:
KEYPAD1: Conn_01x08_Pin; PinHeader_1x08_P2.54mm_Vertical_SMD_Pin1Left

Connections:
X1: KEYPAD1.1; also elsewhere on the board
X2: KEYPAD1.2; also elsewhere on the board
X3: KEYPAD1.3; also elsewhere on the board
X4: KEYPAD1.4; also elsewhere on the board
X5: KEYPAD1.5; also elsewhere on the board
X6: KEYPAD1.6; also elsewhere on the board
X7: KEYPAD1.7; also elsewhere on the board
X8: KEYPAD1.8; also elsewhere on the board

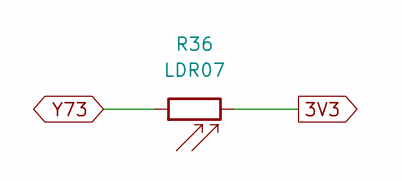
[picture p62: schematic LDR.kicad_sch]

Parts:
R36: LDR07; R_LDR_5.1x4.3mm_P3.4mm_Vertical

Connections:
3V3: R36.2; also elsewhere on the board
Y73: R36.1; also elsewhere on the board

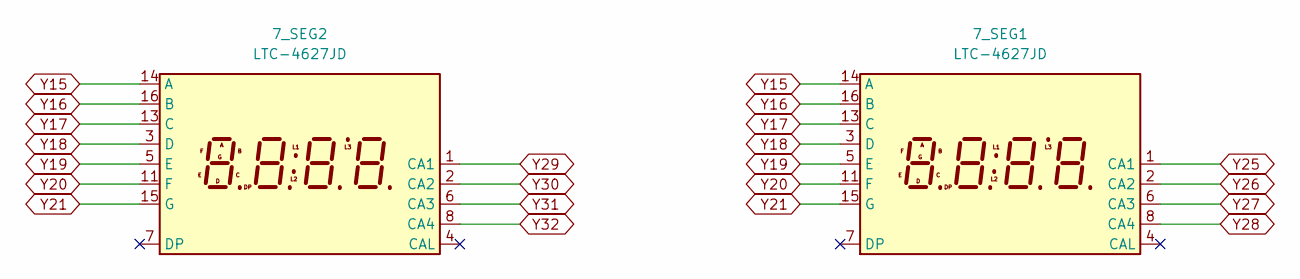
[picture p63: schematic seven_segment_display.kicad_sch]

Parts:
7_SEG1, 7_SEG2: LTC-4627JD; LTC-4627Jx

Connections:
Y15: 7_SEG1.14 (A), 7_SEG2.14 (A); also elsewhere on the board
Y16: 7_SEG1.16 (B), 7_SEG2.16 (B); also elsewhere on the board
Y17: 7_SEG1.13 (C), 7_SEG2.13 (C); also elsewhere on the board
Y18: 7_SEG1.3 (D), 7_SEG2.3 (D); also elsewhere on the board
Y19: 7_SEG1.5 (E), 7_SEG2.5 (E); also elsewhere on the board
Y20: 7_SEG1.11 (F), 7_SEG2.11 (F); also elsewhere on the board
Y21: 7_SEG1.15 (G), 7_SEG2.15 (G); also elsewhere on the board
Y25: 7_SEG1.1 (CA1); also elsewhere on the board
Y26: 7_SEG1.2 (CA2); also elsewhere on the board
Y27: 7_SEG1.6 (CA3); also elsewhere on the board
Y28: 7_SEG1.8 (CA4); also elsewhere on the board
Y29: 7_SEG2.1 (CA1); also elsewhere on the board
Y30: 7_SEG2.2 (CA2); also elsewhere on the board
Y31: 7_SEG2.6 (CA3); also elsewhere on the board
Y32: 7_SEG2.8 (CA4); also elsewhere on the board

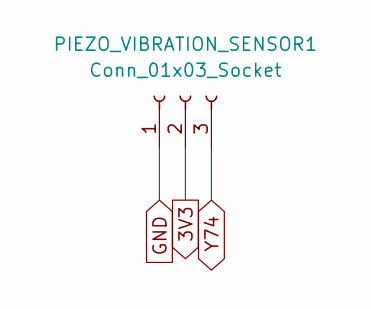
[picture p64: schematic piezo_vibration_sensor.kicad_sch]

Parts:
PIEZO_VIBRATION_SENSOR1: Conn_01x03_Socket; PinSocket_1x03_P2.54mm_Vertical_SMD_Pin1Left

Connections:
3V3: PIEZO_VIBRATION_SENSOR1.2; also elsewhere on the board
GND: PIEZO_VIBRATION_SENSOR1.1; also elsewhere on the board
Y74: PIEZO_VIBRATION_SENSOR1.3; also elsewhere on the board

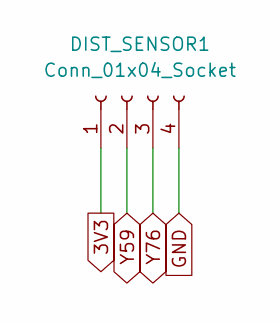
[picture p65: schematic distance_sensor.kicad_sch]

Parts:
DIST_SENSOR1: Conn_01x04_Socket; PinSocket_1x04_P2.54mm_Vertical_SMD_Pin1Left

Connections:
3V3: DIST_SENSOR1.1; also elsewhere on the board
GND: DIST_SENSOR1.4; also elsewhere on the board
Y59: DIST_SENSOR1.2; also elsewhere on the board
Y76: DIST_SENSOR1.3; also elsewhere on the board

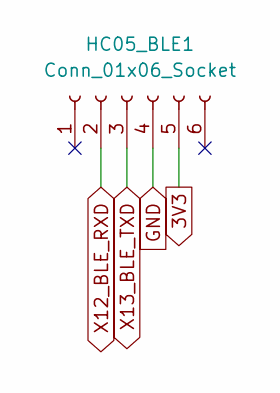
[picture p66: schematic bluetooth.kicad_sch]

Parts:
HC05_BLE1: Conn_01x06_Socket; PinHeader_1x06_P2.54mm_Vertical_SMD_Pin1Left

Connections:
3V3: HC05_BLE1.5; also elsewhere on the board
GND: HC05_BLE1.4; also elsewhere on the board
X12_BLE_RXD: HC05_BLE1.2; also elsewhere on the board
X13_BLE_TXD: HC05_BLE1.3; also elsewhere on the board

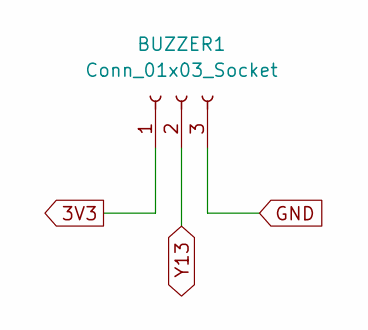
[picture p67: schematic buzzer.kicad_sch]

Parts:
BUZZER1: Conn_01x03_Socket; PinSocket_1x03_P2.54mm_Vertical_SMD_Pin1Left

Connections:
3V3: BUZZER1.1; also elsewhere on the board
GND: BUZZER1.3; also elsewhere on the board
Y13: BUZZER1.2; also elsewhere on the board

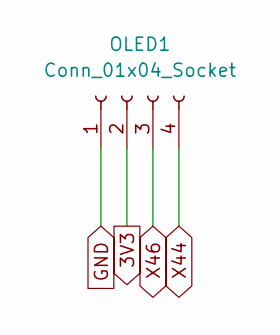
[picture p68: schematic I2C_slaves.kicad_sch]

Parts:
OLED1: Conn_01x04_Socket; PinSocket_1x04_P2.54mm_Vertical_SMD_Pin1Left

Connections:
3V3: OLED1.2; also elsewhere on the board
GND: OLED1.1; also elsewhere on the board
X44: OLED1.4; also elsewhere on the board
X46: OLED1.3; also elsewhere on the board

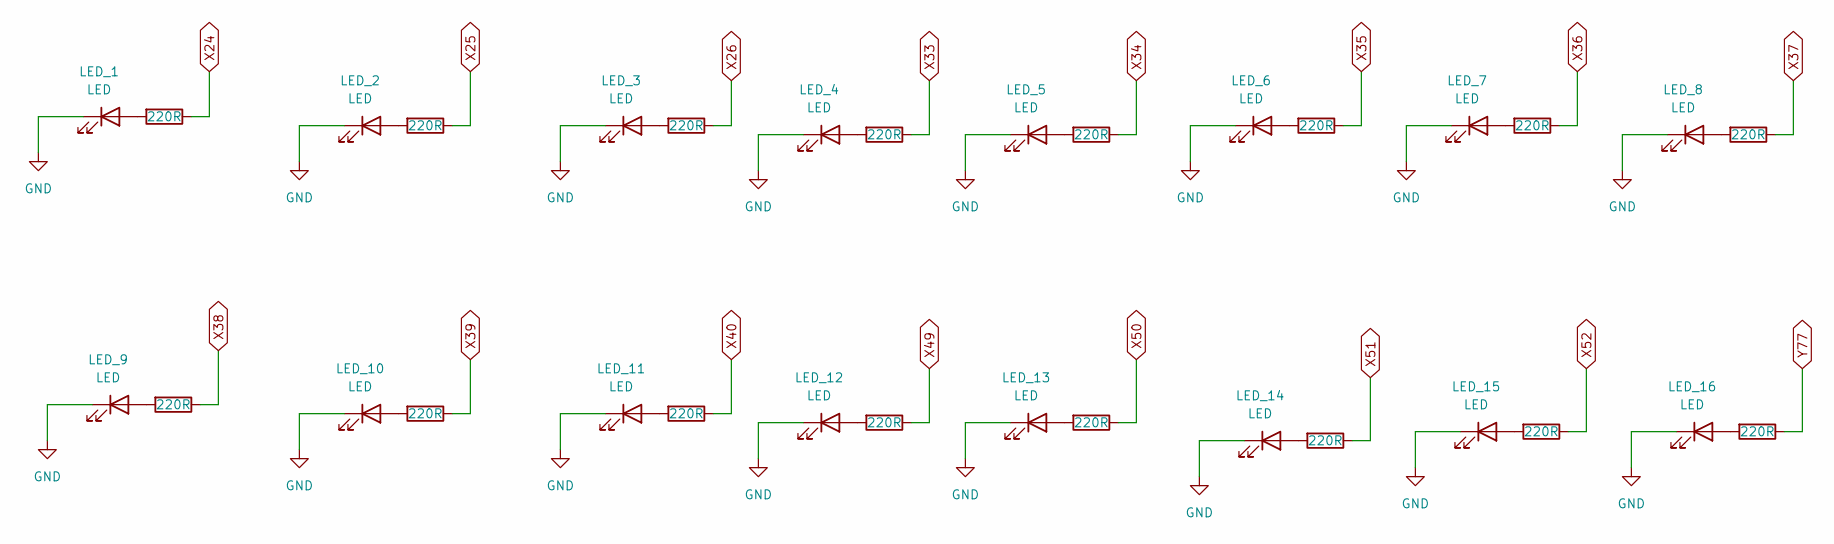
[picture p69: schematic LEDs.kicad_sch]

Parts:
LED_1, LED_2, LED_3, LED_4, LED_5, LED_6, LED_7, LED_8, LED_9, LED_10, LED_11, LED_12, LED_13, LED_14, LED_15, LED_16: LED; LED_0201_0603Metric
R33, R34, R35, R38, R39, R40, R41, R42, R43, R44, R45, R46, R47, R48, R49, R50: 220R; R_0603_1608Metric

Connections:
GND: LED_1.1 (K), LED_2.1 (K), LED_3.1 (K), LED_4.1 (K), LED_5.1 (K), LED_6.1 (K), LED_7.1 (K), LED_8.1 (K), LED_9.1 (K), LED_10.1 (K), LED_11.1 (K), LED_12.1 (K), LED_13.1 (K), LED_14.1 (K), LED_15.1 (K), LED_16.1 (K); also elsewhere on the board
unnamed: LED_1.2 (A), R33.2
unnamed: LED_2.2 (A), R34.2
unnamed: LED_3.2 (A), R35.2
unnamed: LED_4.2 (A), R38.2
unnamed: LED_5.2 (A), R39.2
unnamed: LED_6.2 (A), R40.2
unnamed: LED_7.2 (A), R41.2
unnamed: LED_8.2 (A), R42.2
unnamed: LED_9.2 (A), R43.2
unnamed: LED_10.2 (A), R44.2
unnamed: LED_11.2 (A), R45.2
unnamed: LED_12.2 (A), R46.2
unnamed: LED_13.2 (A), R47.2
unnamed: LED_14.2 (A), R48.2
unnamed: LED_15.2 (A), R49.2
unnamed: LED_16.2 (A), R50.2
X24: R33.1; also elsewhere on the board
X25: R34.1; also elsewhere on the board
X26: R35.1; also elsewhere on the board
X33: R38.1; also elsewhere on the board
X34: R39.1; also elsewhere on the board
X35: R40.1; also elsewhere on the board
X36: R41.1; also elsewhere on the board
X37: R42.1; also elsewhere on the board
X38: R43.1; also elsewhere on the board
X39: R44.1; also elsewhere on the board
X40: R45.1; also elsewhere on the board
X49: R46.1; also elsewhere on the board
X50: R47.1; also elsewhere on the board
X51: R48.1; also elsewhere on the board
X52: R49.1; also elsewhere on the board
Y77: R50.1; also elsewhere on the board

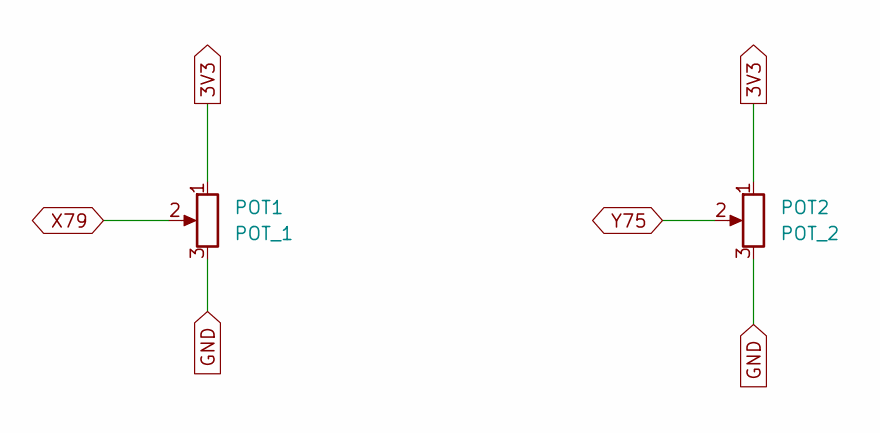
[picture p70: schematic potentiometers.kicad_sch]

Parts:
POT1: POT_1; Potentiometer_ACP_CA6-VSMD_Vertical
POT2: POT_2; Potentiometer_ACP_CA6-VSMD_Vertical

Connections:
3V3: POT1.1, POT2.1; also elsewhere on the board
GND: POT1.3, POT2.3; also elsewhere on the board
X79: POT1.2; also elsewhere on the board
Y75: POT2.2; also elsewhere on the board

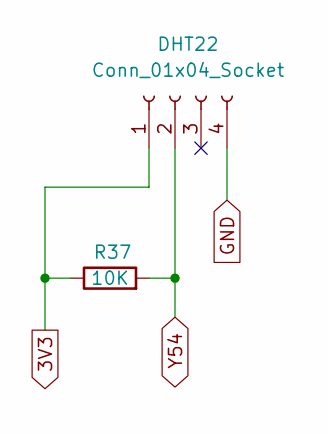
[picture p71: schematic temp_sensor.kicad_sch]

Parts:
DHT22: Conn_01x04_Socket; PinSocket_1x04_P2.54mm_Vertical_SMD_Pin1Left
R37: 10K; R_0201_0603Metric

Connections:
3V3: DHT22.1, R37.1; also elsewhere on the board
GND: DHT22.4; also elsewhere on the board
Y54: DHT22.2, R37.2; also elsewhere on the board

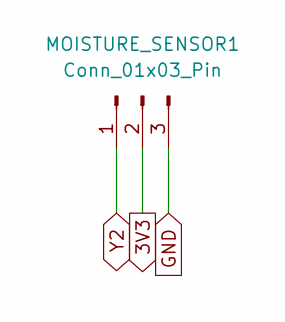
[picture p72: schematic moisture_sensor.kicad_sch]

Parts:
MOISTURE_SENSOR1: Conn_01x03_Pin; PinHeader_1x03_P2.54mm_Vertical_SMD_Pin1Left

Connections:
3V3: MOISTURE_SENSOR1.2; also elsewhere on the board
GND: MOISTURE_SENSOR1.3; also elsewhere on the board
Y2: MOISTURE_SENSOR1.1; also elsewhere on the board

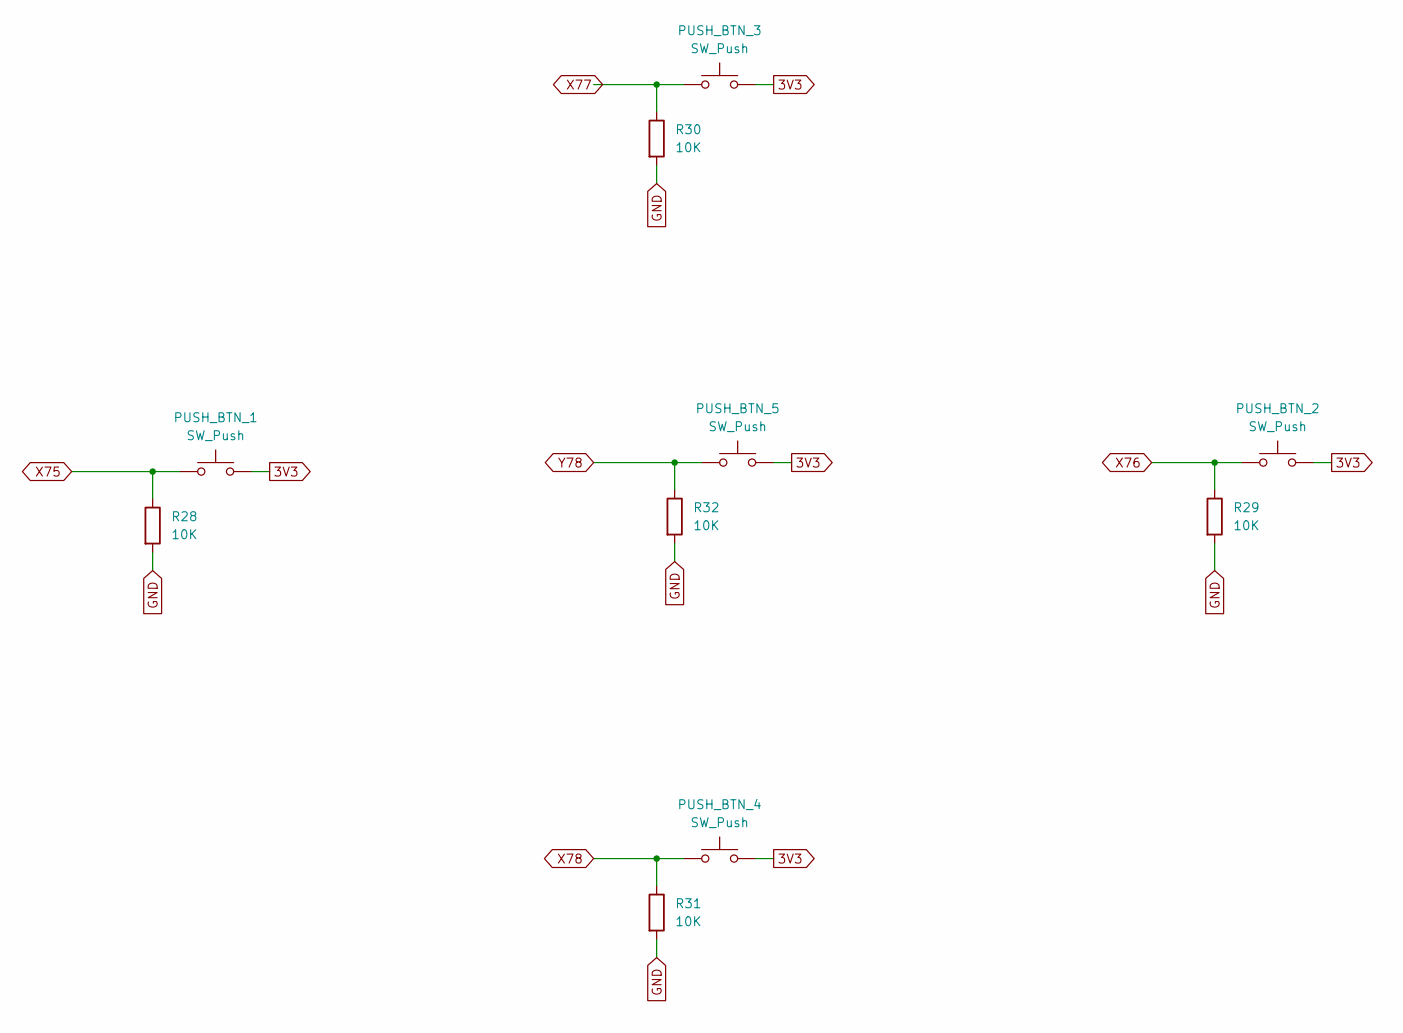
[picture p73: schematic push_buttons.kicad_sch]

Parts:
PUSH_BTN_1, PUSH_BTN_2, PUSH_BTN_3, PUSH_BTN_4, PUSH_BTN_5: SW_Push; SW_Push_SPST_NO_Alps_SKRK
R28, R29, R30, R31, R32: 10K; R_0603_1608Metric

Connections:
3V3: PUSH_BTN_1.2, PUSH_BTN_2.2, PUSH_BTN_3.2, PUSH_BTN_4.2, PUSH_BTN_5.2; also elsewhere on the board
GND: R28.2, R29.2, R30.2, R31.2, R32.2; also elsewhere on the board
X75: PUSH_BTN_1.1, R28.1; also elsewhere on the board
X76: PUSH_BTN_2.1, R29.1; also elsewhere on the board
X77: PUSH_BTN_3.1, R30.1; also elsewhere on the board
X78: PUSH_BTN_4.1, R31.1; also elsewhere on the board
Y78: PUSH_BTN_5.1, R32.1; also elsewhere on the board

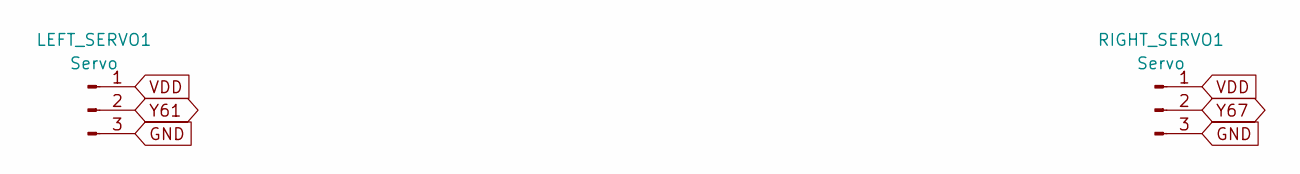
[picture p74: schematic servoMotor.kicad_sch]

Parts:
LEFT_SERVO1: Servo; PinHeader_1x03_P2.54mm_Vertical_SMD_Pin1Left
RIGHT_SERVO1: Servo; PinHeader_1x03_P2.54mm_Vertical_SMD_Pin1Left

Connections:
GND: LEFT_SERVO1.3, RIGHT_SERVO1.3; also elsewhere on the board
VDD: LEFT_SERVO1.1, RIGHT_SERVO1.1; also elsewhere on the board
Y61: LEFT_SERVO1.2; also elsewhere on the board
Y67: RIGHT_SERVO1.2; also elsewhere on the board

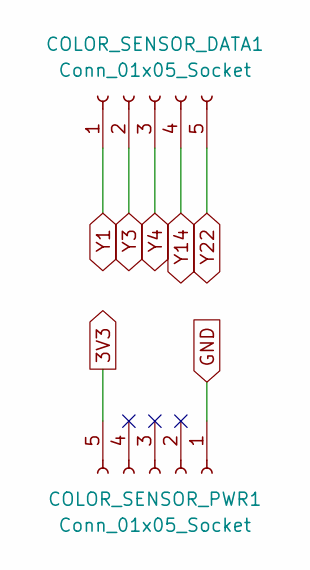
[picture p75: schematic color_sensor.kicad_sch]

Parts:
COLOR_SENSOR_DATA1: Conn_01x05_Socket; PinSocket_1x05_P2.54mm_Vertical_SMD_Pin1Left
COLOR_SENSOR_PWR1: Conn_01x05_Socket; PinSocket_1x05_P2.54mm_Vertical_SMD_Pin1Left

Connections:
3V3: COLOR_SENSOR_PWR1.5; also elsewhere on the board
GND: COLOR_SENSOR_PWR1.1; also elsewhere on the board
Y1: COLOR_SENSOR_DATA1.1; also elsewhere on the board
Y3: COLOR_SENSOR_DATA1.2; also elsewhere on the board
Y4: COLOR_SENSOR_DATA1.3; also elsewhere on the board
Y14: COLOR_SENSOR_DATA1.4; also elsewhere on the board
Y22: COLOR_SENSOR_DATA1.5; also elsewhere on the board
