shahzaibWaseem27/HSHL_ELE_Shahzaib_Waseem_Project_Work/project_files/kicad_pcb.kicad_pcb

## KiCad design project_files/kicad_pcb.kicad_pcb (continued)

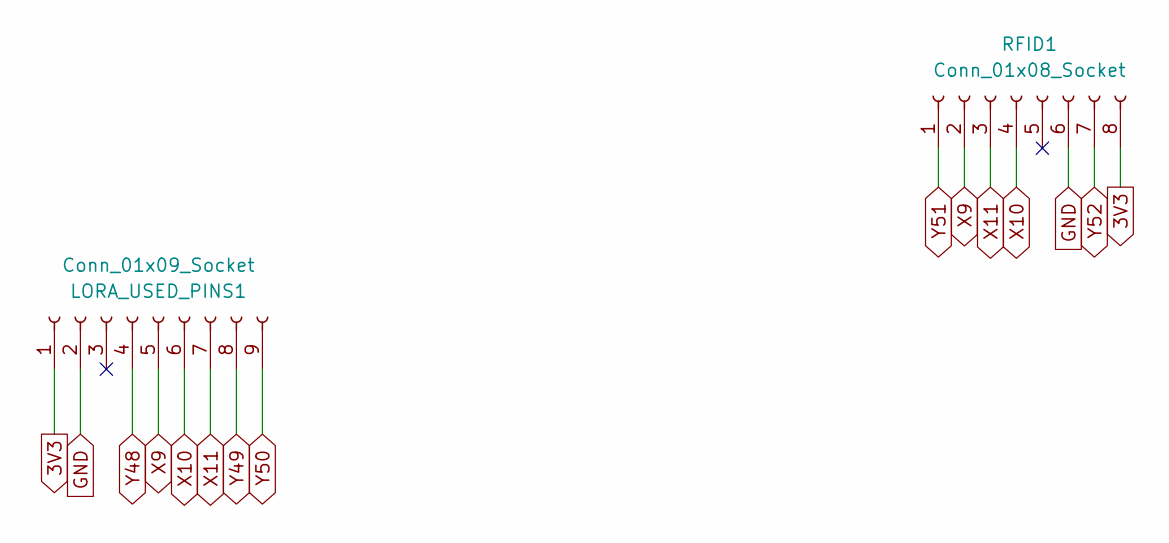
[picture p76: schematic SPI_slaves.kicad_sch]

Parts:
LORA_USED_PINS1: Conn_01x09_Socket; PinSocket_1x09_P2.54mm_Vertical_SMD_Pin1Left
RFID1: Conn_01x08_Socket; PinSocket_1x08_P2.54mm_Vertical_SMD_Pin1Left

Connections:
3V3: LORA_USED_PINS1.1, RFID1.8; also elsewhere on the board
GND: LORA_USED_PINS1.2, RFID1.6; also elsewhere on the board
X9: LORA_USED_PINS1.5, RFID1.2; also elsewhere on the board
X10: LORA_USED_PINS1.6, RFID1.4; also elsewhere on the board
X11: LORA_USED_PINS1.7, RFID1.3; also elsewhere on the board
Y48: LORA_USED_PINS1.4; also elsewhere on the board
Y49: LORA_USED_PINS1.8; also elsewhere on the board
Y50: LORA_USED_PINS1.9; also elsewhere on the board
Y51: RFID1.1; also elsewhere on the board
Y52: RFID1.7; also elsewhere on the board

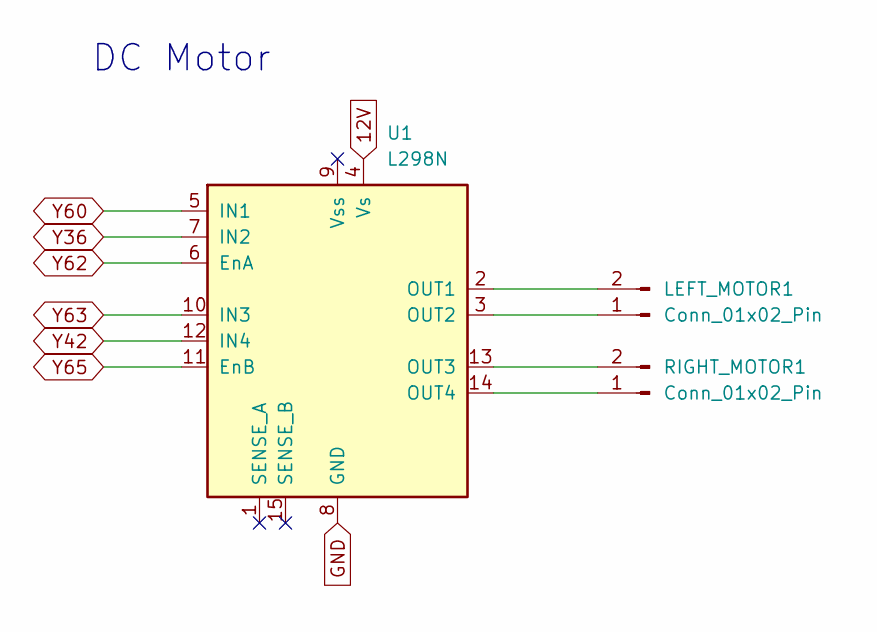
[picture p77: schematic motor_drivers.kicad_sch]

Parts:
LEFT_MOTOR1: Conn_01x02_Pin; PinHeader_1x02_P2.54mm_Vertical_SMD_Pin1Left
RIGHT_MOTOR1: Conn_01x02_Pin; PinHeader_1x02_P2.54mm_Vertical_SMD_Pin1Left
U1: L298N; TO-220-15_P2.54x2.54mm_StaggerOdd_Lead4.58mm_Vertical

Connections:
12V: U1.4 (Vs); also elsewhere on the board
GND: U1.8 (GND); also elsewhere on the board
unnamed: LEFT_MOTOR1.1, U1.3 (OUT2)
unnamed: LEFT_MOTOR1.2, U1.2 (OUT1)
unnamed: RIGHT_MOTOR1.1, U1.14 (OUT4)
unnamed: RIGHT_MOTOR1.2, U1.13 (OUT3)
Y36: U1.7 (IN2); also elsewhere on the board
Y42: U1.12 (IN4); also elsewhere on the board
Y60: U1.5 (IN1); also elsewhere on the board
Y62: U1.6 (EnA); also elsewhere on the board
Y63: U1.10 (IN3); also elsewhere on the board
Y65: U1.11 (EnB); also elsewhere on the board

Notes on the sheet:
DC Motor

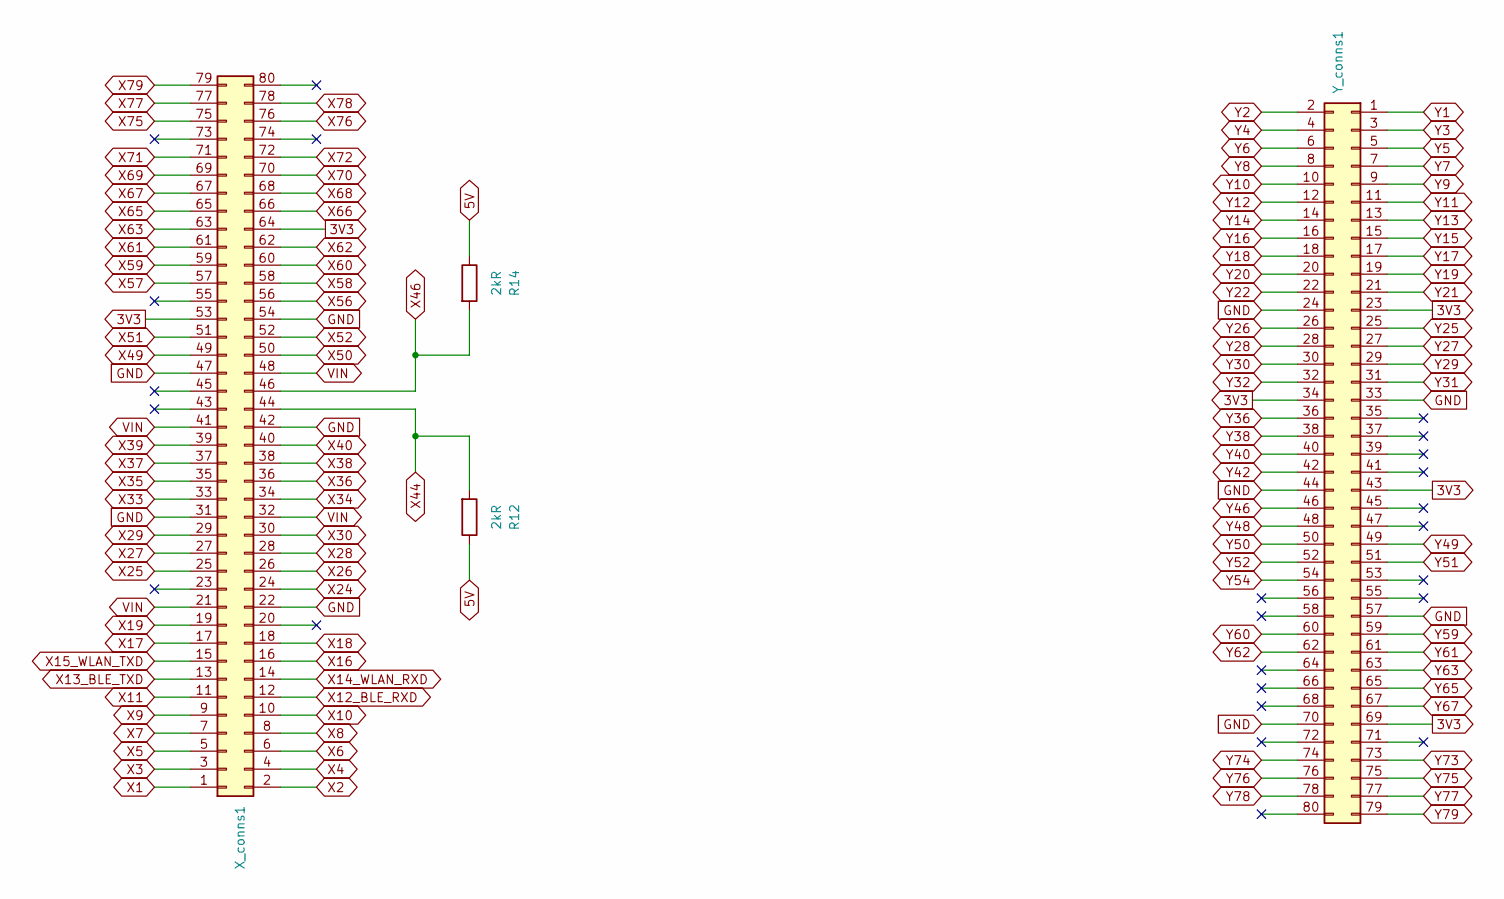
[picture p78: schematic Control Unit connectors.kicad_sch]

Parts:
R12, R14: 2kR; R_0603_1608Metric
X_conns1: 5024308030
Y_conns1: 5024308030

Connections:
3V3: X_conns1.53, X_conns1.64, Y_conns1.23, Y_conns1.34, Y_conns1.43, Y_conns1.69; also elsewhere on the board
5V: R12.1, R14.1
GND: X_conns1.22, X_conns1.31, X_conns1.42, X_conns1.47, X_conns1.54, Y_conns1.24, Y_conns1.33, Y_conns1.44, Y_conns1.57, Y_conns1.70; also elsewhere on the board
VDD: X_conns1.21, X_conns1.32, X_conns1.41, X_conns1.48; also elsewhere on the board
X1: X_conns1.1; also elsewhere on the board
X2: X_conns1.2; also elsewhere on the board
X3: X_conns1.3; also elsewhere on the board
X4: X_conns1.4; also elsewhere on the board
X5: X_conns1.5; also elsewhere on the board
X6: X_conns1.6; also elsewhere on the board
X7: X_conns1.7; also elsewhere on the board
X8: X_conns1.8; also elsewhere on the board
X9: X_conns1.9; also elsewhere on the board
X10: X_conns1.10; also elsewhere on the board
X11: X_conns1.11; also elsewhere on the board
X12_BLE_RXD: X_conns1.12; also elsewhere on the board
X13_BLE_TXD: X_conns1.13; also elsewhere on the board
X14_WLAN_RXD: X_conns1.14; also elsewhere on the board
X15_WLAN_TXD: X_conns1.15; also elsewhere on the board
X16: X_conns1.16; also elsewhere on the board
X17: X_conns1.17; also elsewhere on the board
X18: X_conns1.18; also elsewhere on the board
X19: X_conns1.19; also elsewhere on the board
X24: X_conns1.24; also elsewhere on the board
X25: X_conns1.25; also elsewhere on the board
X26: X_conns1.26; also elsewhere on the board
X27: X_conns1.27; also elsewhere on the board
X28: X_conns1.28; also elsewhere on the board
X29: X_conns1.29; also elsewhere on the board
X30: X_conns1.30; also elsewhere on the board
X33: X_conns1.33; also elsewhere on the board
X34: X_conns1.34; also elsewhere on the board
X35: X_conns1.35; also elsewhere on the board
X36: X_conns1.36; also elsewhere on the board
X37: X_conns1.37; also elsewhere on the board
X38: X_conns1.38; also elsewhere on the board
X39: X_conns1.39; also elsewhere on the board
X40: X_conns1.40; also elsewhere on the board
X44: R12.2, X_conns1.44; also elsewhere on the board
X46: R14.2, X_conns1.46; also elsewhere on the board
X49: X_conns1.49; also elsewhere on the board
X50: X_conns1.50; also elsewhere on the board
X51: X_conns1.51; also elsewhere on the board
X52: X_conns1.52; also elsewhere on the board
X56: X_conns1.56; also elsewhere on the board
X57: X_conns1.57; also elsewhere on the board
X58: X_conns1.58; also elsewhere on the board
X59: X_conns1.59; also elsewhere on the board
X60: X_conns1.60; also elsewhere on the board
X61: X_conns1.61; also elsewhere on the board
X62: X_conns1.62; also elsewhere on the board
X63: X_conns1.63; also elsewhere on the board
X65: X_conns1.65; also elsewhere on the board
X66: X_conns1.66; also elsewhere on the board
X67: X_conns1.67; also elsewhere on the board
X68: X_conns1.68; also elsewhere on the board
X69: X_conns1.69; also elsewhere on the board
X70: X_conns1.70; also elsewhere on the board
X71: X_conns1.71; also elsewhere on the board
X72: X_conns1.72; also elsewhere on the board
X75: X_conns1.75; also elsewhere on the board
X76: X_conns1.76; also elsewhere on the board
X77: X_conns1.77; also elsewhere on the board
X78: X_conns1.78; also elsewhere on the board
X79: X_conns1.79; also elsewhere on the board
Y1: Y_conns1.1; also elsewhere on the board
Y2: Y_conns1.2; also elsewhere on the board
Y3: Y_conns1.3; also elsewhere on the board
Y4: Y_conns1.4; also elsewhere on the board
Y5: Y_conns1.5; also elsewhere on the board
Y6: Y_conns1.6; also elsewhere on the board
Y7: Y_conns1.7; also elsewhere on the board
Y8: Y_conns1.8; also elsewhere on the board
Y9: Y_conns1.9; also elsewhere on the board
Y10: Y_conns1.10; also elsewhere on the board
Y11: Y_conns1.11; also elsewhere on the board
Y12: Y_conns1.12; also elsewhere on the board
Y13: Y_conns1.13; also elsewhere on the board
Y14: Y_conns1.14; also elsewhere on the board
Y15: Y_conns1.15; also elsewhere on the board
Y16: Y_conns1.16; also elsewhere on the board
Y17: Y_conns1.17; also elsewhere on the board
Y18: Y_conns1.18; also elsewhere on the board
Y19: Y_conns1.19; also elsewhere on the board
Y20: Y_conns1.20; also elsewhere on the board
Y21: Y_conns1.21; also elsewhere on the board
Y22: Y_conns1.22; also elsewhere on the board
Y25: Y_conns1.25; also elsewhere on the board
Y26: Y_conns1.26; also elsewhere on the board
Y27: Y_conns1.27; also elsewhere on the board
Y28: Y_conns1.28; also elsewhere on the board
Y29: Y_conns1.29; also elsewhere on the board
Y30: Y_conns1.30; also elsewhere on the board
Y31: Y_conns1.31; also elsewhere on the board
Y32: Y_conns1.32; also elsewhere on the board
Y36: Y_conns1.36; also elsewhere on the board
Y38: Y_conns1.38; also elsewhere on the board
Y40: Y_conns1.40; also elsewhere on the board
Y42: Y_conns1.42; also elsewhere on the board
Y46: Y_conns1.46; also elsewhere on the board
Y48: Y_conns1.48; also elsewhere on the board
Y49: Y_conns1.49; also elsewhere on the board
Y50: Y_conns1.50; also elsewhere on the board
Y51: Y_conns1.51; also elsewhere on the board
Y52: Y_conns1.52; also elsewhere on the board
Y54: Y_conns1.54; also elsewhere on the board
Y59: Y_conns1.59; also elsewhere on the board
Y60: Y_conns1.60; also elsewhere on the board
Y61: Y_conns1.61; also elsewhere on the board
Y62: Y_conns1.62; also elsewhere on the board
Y63: Y_conns1.63; also elsewhere on the board
Y65: Y_conns1.65; also elsewhere on the board
Y67: Y_conns1.67; also elsewhere on the board
Y73: Y_conns1.73; also elsewhere on the board
Y74: Y_conns1.74; also elsewhere on the board
Y75: Y_conns1.75; also elsewhere on the board
Y76: Y_conns1.76; also elsewhere on the board
Y77: Y_conns1.77; also elsewhere on the board
Y78: Y_conns1.78; also elsewhere on the board
Y79: Y_conns1.79; also elsewhere on the board

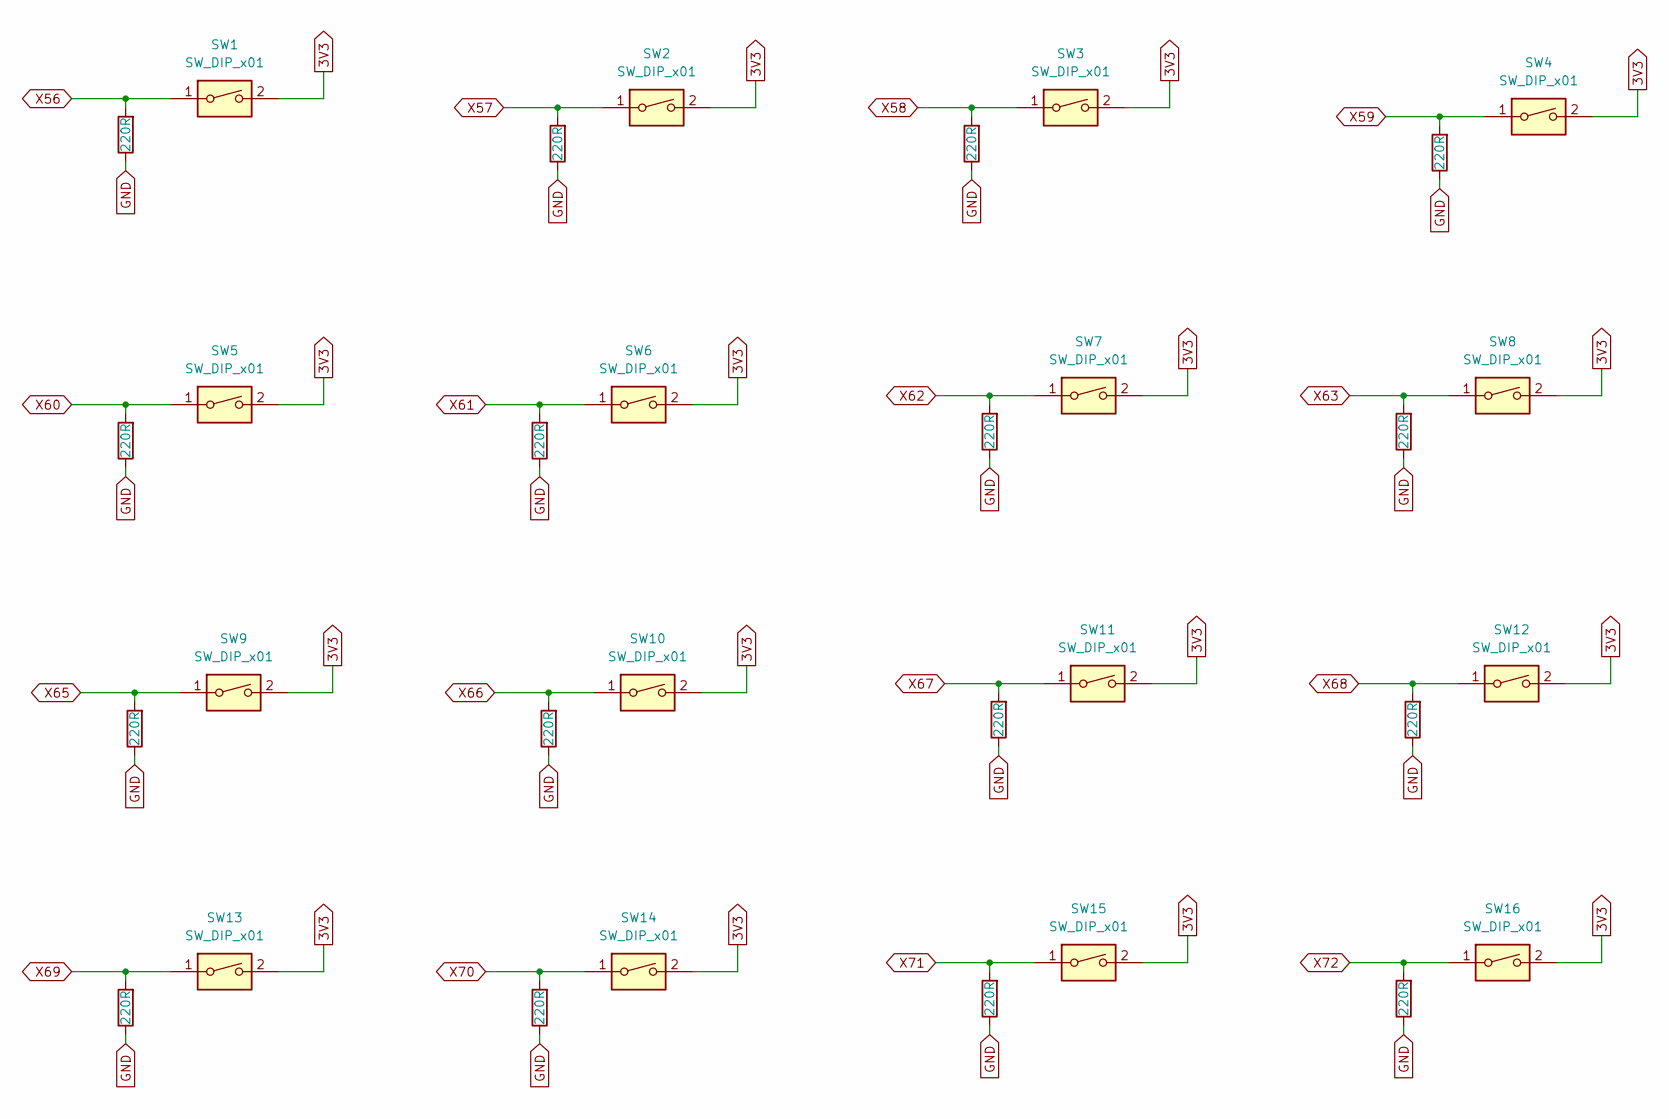
[picture p79: schematic switches.kicad_sch]

Parts:
R1, R3, R13, R15, R16, R17, R18, R19, R20, R21, R22, R23, R24, R25, R26, R27: 220R; R_0603_1608Metric
SW1, SW2, SW3, SW4, SW5, SW6, SW7, SW8, SW9, SW10, SW11, SW12, SW13, SW14, SW15, SW16: SW_DIP_x01; SW_DIP_SPSTx01_Slide_6.7x4.1mm_W6.73mm_P2.54mm_LowProfile_J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

Connections:
3V3: SW1.2, SW2.2, SW3.2, SW4.2, SW5.2, SW6.2, SW7.2, SW8.2, SW9.2, SW10.2, SW11.2, SW12.2, SW13.2, SW14.2, SW15.2, SW16.2; also elsewhere on the board
GND: R1.1, R3.1, R13.1, R15.1, R16.1, R17.1, R18.1, R19.1, R20.1, R21.1, R22.1, R23.1, R24.1, R25.1, R26.1, R27.1; also elsewhere on the board
X56: R1.2, SW1.1; also elsewhere on the board
X57: R3.2, SW2.1; also elsewhere on the board
X58: R13.2, SW3.1; also elsewhere on the board
X59: R15.2, SW4.1; also elsewhere on the board
X60: R16.2, SW5.1; also elsewhere on the board
X61: R17.2, SW6.1; also elsewhere on the board
X62: R18.2, SW7.1; also elsewhere on the board
X63: R19.2, SW8.1; also elsewhere on the board
X65: R20.2, SW9.1; also elsewhere on the board
X66: R21.2, SW10.1; also elsewhere on the board
X67: R22.2, SW11.1; also elsewhere on the board
X68: R23.2, SW12.1; also elsewhere on the board
X69: R24.2, SW13.1; also elsewhere on the board
X70: R25.2, SW14.1; also elsewhere on the board
X71: R26.2, SW15.1; also elsewhere on the board
X72: R27.2, SW16.1; also elsewhere on the board

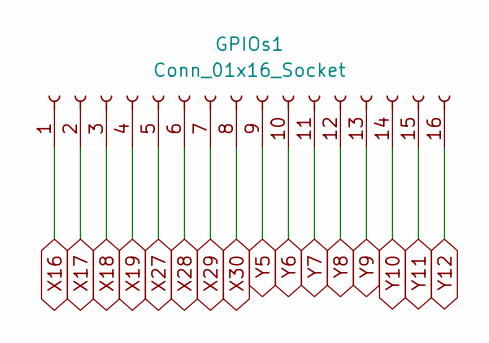
[picture p80: schematic GPIOs.kicad_sch]

Parts:
GPIOs1: Conn_01x16_Socket; PinSocket_1x16_P2.54mm_Vertical_SMD_Pin1Left

Connections:
X16: GPIOs1.1; also elsewhere on the board
X17: GPIOs1.2; also elsewhere on the board
X18: GPIOs1.3; also elsewhere on the board
X19: GPIOs1.4; also elsewhere on the board
X27: GPIOs1.5; also elsewhere on the board
X28: GPIOs1.6; also elsewhere on the board
X29: GPIOs1.7; also elsewhere on the board
X30: GPIOs1.8; also elsewhere on the board
Y5: GPIOs1.9; also elsewhere on the board
Y6: GPIOs1.10; also elsewhere on the board
Y7: GPIOs1.11; also elsewhere on the board
Y8: GPIOs1.12; also elsewhere on the board
Y9: GPIOs1.13; also elsewhere on the board
Y10: GPIOs1.14; also elsewhere on the board
Y11: GPIOs1.15; also elsewhere on the board
Y12: GPIOs1.16; also elsewhere on the board

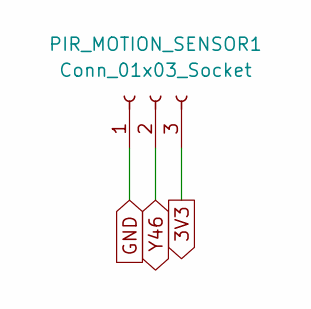
[picture p81: schematic PIR_motion_sensor.kicad_sch]

Parts:
PIR_MOTION_SENSOR1: Conn_01x03_Socket; PinSocket_1x03_P2.54mm_Vertical_SMD_Pin1Left

Connections:
3V3: PIR_MOTION_SENSOR1.3; also elsewhere on the board
GND: PIR_MOTION_SENSOR1.1; also elsewhere on the board
Y46: PIR_MOTION_SENSOR1.2; also elsewhere on the board

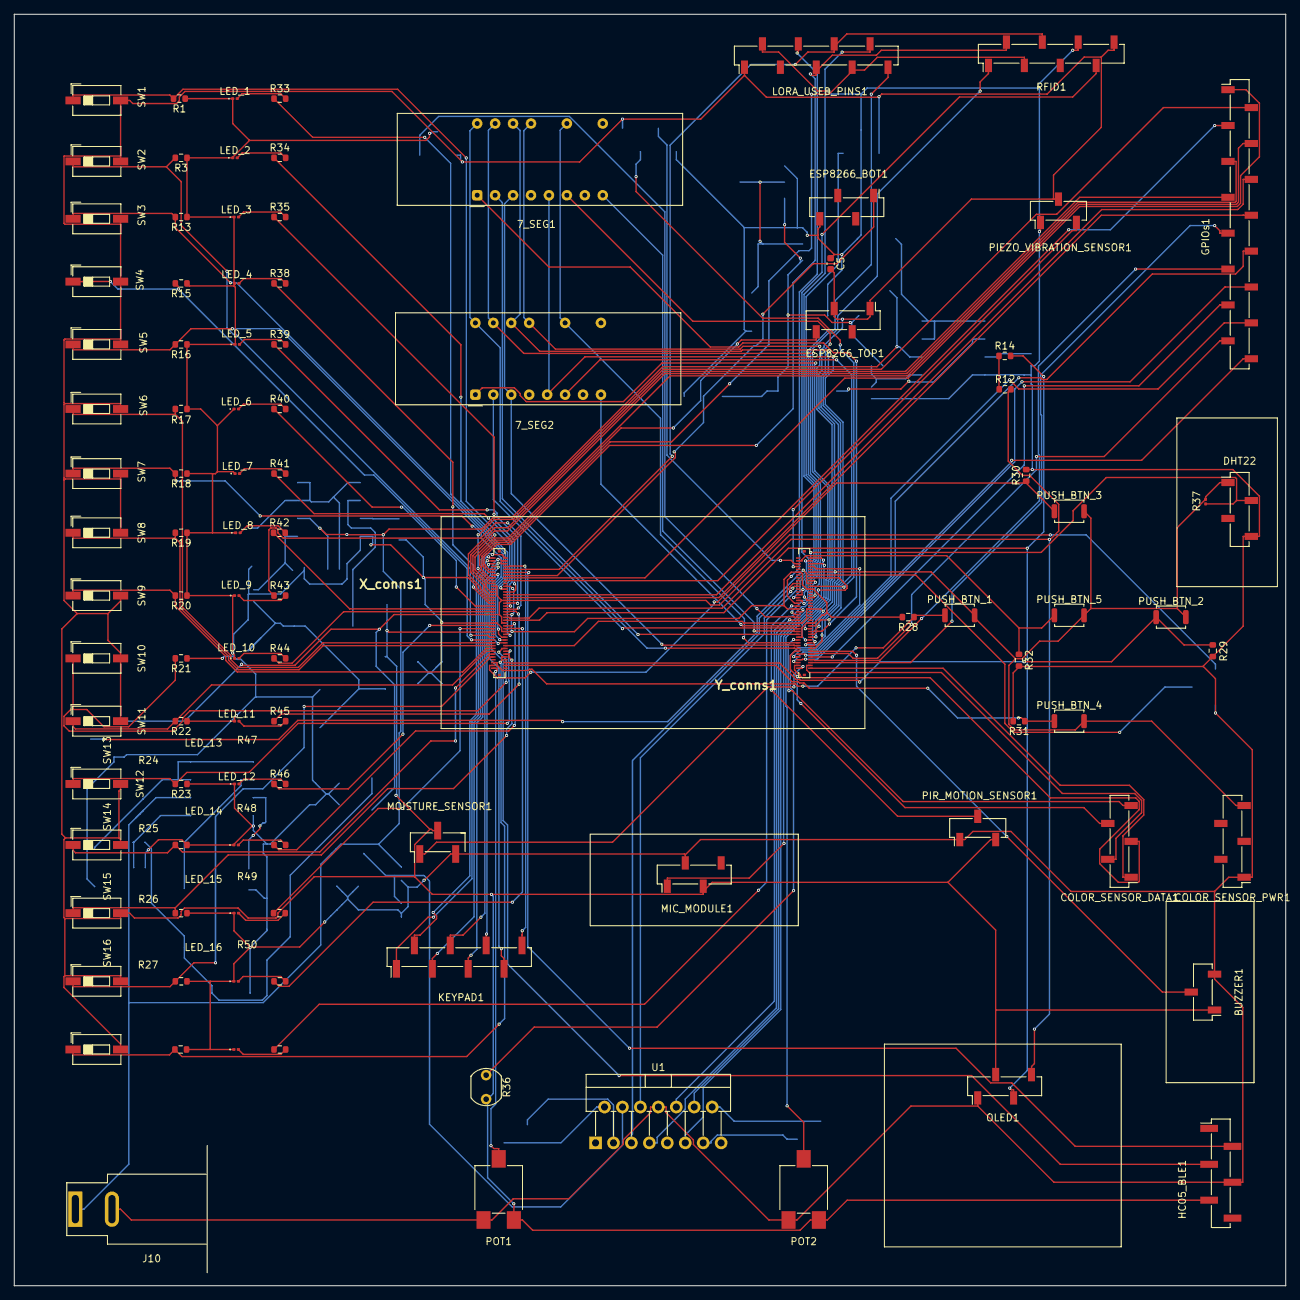
[picture p82: board kicad_pcb.kicad_pcb from above]

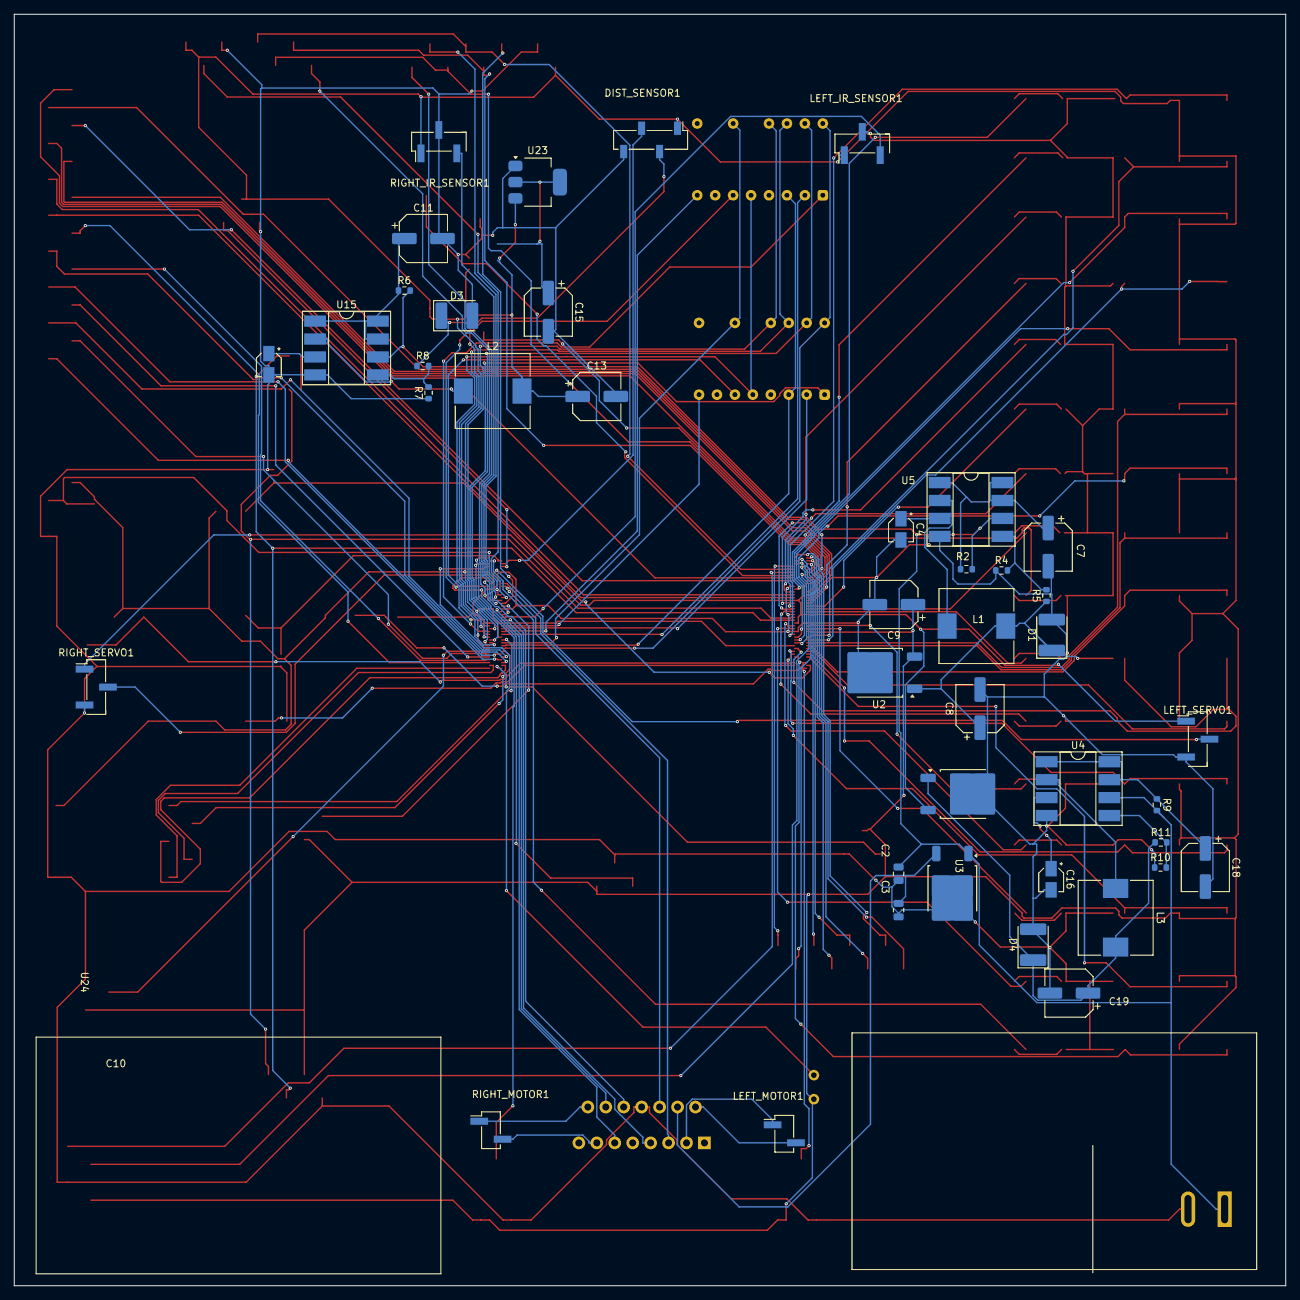
[picture p83: board kicad_pcb.kicad_pcb from below]

Board: 2 copper layers, 180.0 x 180.0 mm, 145 parts (42 on the bottom side), 158 nets.
