shahzaibWaseem27/HSHL_ELE_Shahzaib_Waseem_Project_Work/(commit log)

2024-08-13 Add files via upload
    Original project work documentation an project files
    [BOM.csv, PCB Components list.xlsm]
2025-01-22 added all macbook files in repo
    [Control Unit connectors.kicad_sch, GPIOs.kicad_sch, I2C_bus.kicad_sch, I2C_slaves.kicad_sch, IR_sensors.kicad_sch, LDR.kicad_sch, LEDs.kicad_sch, PCB Components list.xlsm]
2025-01-22 Moved previous student files into his folder. Renamed folder
    [BOM.csv, Control Unit connectors.kicad_sch, GPIOs.kicad_sch, I2C_bus.kicad_sch, I2C_slaves.kicad_sch, IR_sensors.kicad_sch, LDR.kicad_sch, LEDs.kicad_sch]
2025-01-22 Added a excel file copy of high density pin connectors pin mapping
    [High density connectors pin mapping.xlsx]
2025-02-12 added gerber and drill files
    [kicad_pcb-B_Cu.gbr, kicad_pcb-B_Mask.gbr, kicad_pcb-B_Paste.gbr, kicad_pcb-B_Silkscreen.gbr, kicad_pcb-Edge_Cuts.gbr, kicad_pcb-F_Cu.gbr, kicad_pcb-F_Mask.gbr, kicad_pcb-F_Paste.gbr]
